misakigr/Ambulat_pristr/Ведомость метизов.pdf

00-25-КМД

13-июн-2025

Проект: Больничное учреждение без специальных требований к размещению. Амбулатория ООО "Аракс"

Деталировщик:

Исполнитель: | Шифр проекта:
ДЕТАЛЬНАЯ ВЕДОМОСТЬ БОЛТОВ | Мисак | Дата
Шайба C.16.01.08кп.016 ГОСТ 11371-78 | | 5 | 100 | 11371-78 | 0 | 1,1
Шайба C.14.01.08кп.016 ГОСТ 11371-78 | | 5 | 168 | 11371-78 | 0 | 1,4
0 | 3,8 Гайка М16 6Н.5 ГОСТ 5915-70 | 5 | 100 | 5915-70
0 | 3,8 Гайка М14 6Н.5 ГОСТ 5915-70 | 5 | 168 | 5915-70
Болт М16 - 6gx60.88 ГОСТ 7798-70 | 60 | 8.8 | 2 | 7798-70 | 0,1 | 0,3
Болт М16 - 6gx55.88 ГОСТ 7798-70 | 55 | 8.8 | 48 | 7798-70 | 0,1 | 5,8
Болт М14 - 6gx50.88 ГОСТ 7798-70 | 50 | 8.8 | 84 | 7798-70 | 0,1 | 7
| | Промежуточный итог: | 670 | | | 23,1
Всего: | 670 | 23,1
Длина Класс | Количест во

(кг)

Покрытие | Тип | Вес | Итог | Описание

(мм)

Наименование | шт. | Вес
(шт) | (кг/шт)

Покрытие

(мм)

Длина | Класс
Наименование
Страница | 1 / 1
