misakigr/Ambulat_pristr/02-2025-ОЗД-АР1.pdf

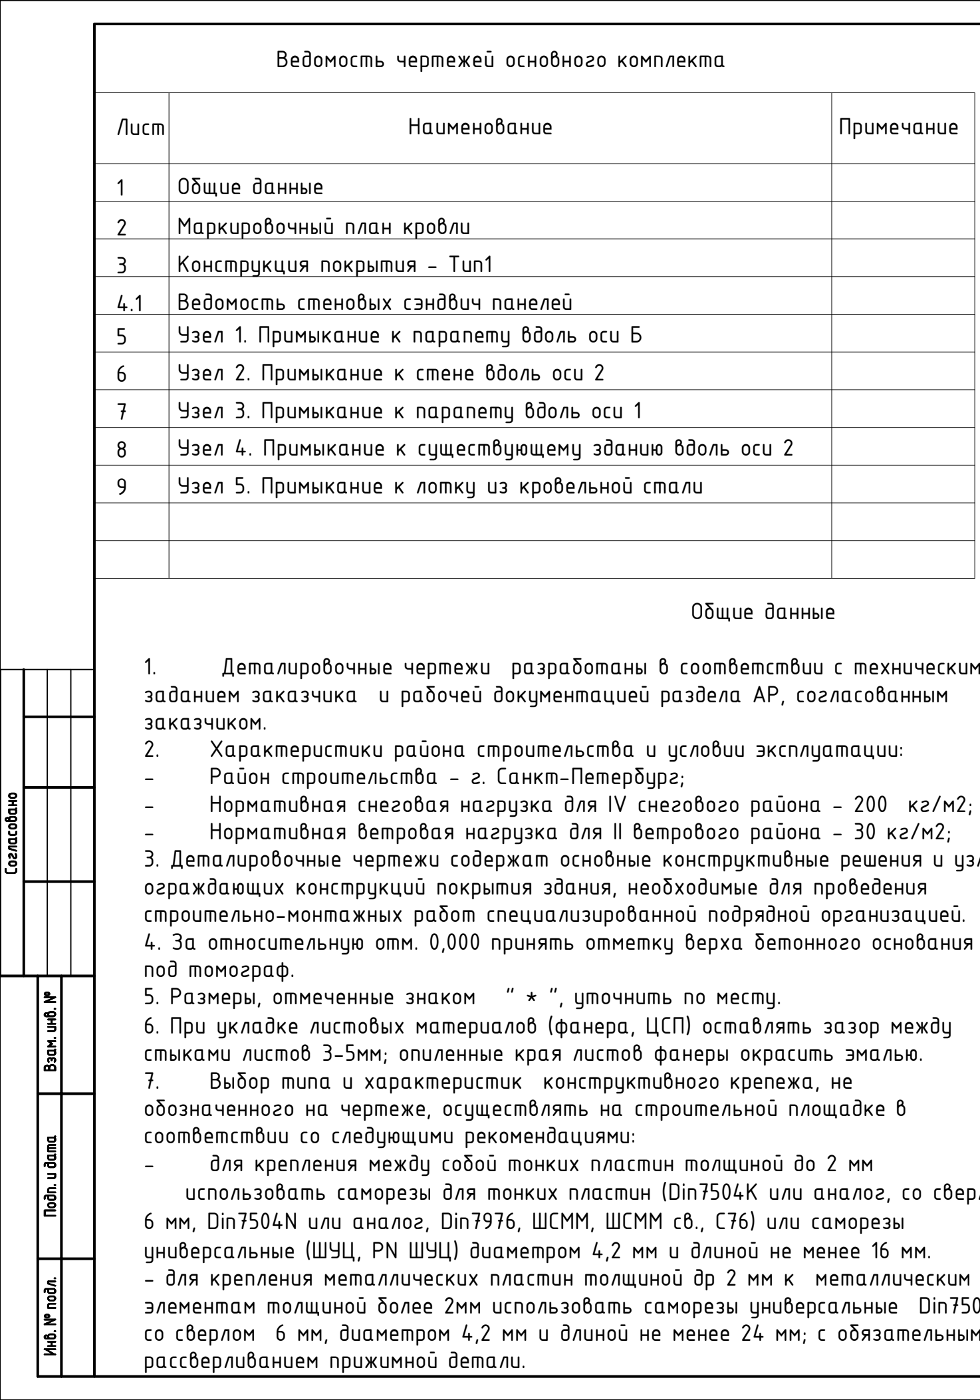
[picture p1: figure]

Ведомость чертежей основного комплекта Лист | Наименование | Примечание 1 | Общие данные 2 | Маркировочный план кровли 3 | Конструкция покрытия - Тип1 | действующими на территории РФ. Настоящий проект выполнен в соответствии с нормами, правилами и стандартами, - для крепления между собой металлических пластин толщиной более 2 мм использовать саморезы универсальные Din7504K со сверлом 12 мм или саморезы Pias диаметром 4.2 мм и длиной не менее 24 мм. - для крепления ЦСП, фанеры и стекломагниевого листа к металлическим каркасам использовать саморезы FLUGEL 4,2х38. - для нерасчетного фиксирующего крепления в бетон использовать дюбели NAT (L), YLT, КВТ, КВТМ, LYT UK KP, LYT LK SP, KAT TORX (N) или KAT HEX (N) диаметром не менее 6 мм и длиной не менее 30 мм. - при отсутствии на чертежах рекомендации по использованию конкретного крепежа допускается использование аналогов, по согласованию с автором проекта листы гипсокартона по подконструкции (внутренняя отделка) крепить к профлисту плоскими саморезами не менее 2-х штук на м2 через бутиловую ленту. Диаметр и тип самореза по выбору подрядной организацией 4.1 | Ведомость стеновых сэндвич панелей 5 | Узел 1. Примыкание к парапету вдоль оси Б 6 | Узел 2. Примыкание к стене вдоль оси 2 7 | Узел 3. Примыкание к парапету вдоль оси 1 8 | Узел 4. Примыкание к существующему зданию вдоль оси 2 Общие данные 1. | Деталировочные чертежи разработаны в соответствии с техническим заданием заказчика и рабочей документацией раздела АР, согласованным заказчиком. 2. | Характеристики района строительства и условии эксплуатации: - | Район строительства - г. Санкт-Петербург; - | Нормативная снеговая нагрузка для IV снегового района - 200 кг/м2; - | Нормативная ветровая нагрузка для II ветрового района - 30 кг/м2; 3. Деталировочные чертежи содержат основные конструктивные решения и узлы ограждающих конструкций покрытия здания, необходимые для проведения строительно-монтажных работ специализированной подрядной организацией. 4. За относительную отм. 0,000 принять отметку верха бетонного основания под томограф. 5. Размеры, отмеченные знаком " * ", уточнить по месту. 6. При укладке листовых материалов (фанера, ЦСП) оставлять зазор между стыками листов 3-5мм; опиленные края листов фанеры окрасить эмалью. 7. | Выбор типа и характеристик конструктивного крепежа, не обозначенного на чертеже, осуществлять на строительной площадке в соответствии со следующими рекомендациями: - | для крепления между собой тонких пластин толщиной до 2 мм использовать саморезы для тонких пластин (Din7504K или аналог, со сверлом 6 мм, Din7504N или аналог, Din7976, ШСММ, ШСММ св., С76) или саморезы универсальные (ШУЦ, PN ШУЦ) диаметром 4,2 мм и длиной не менее 16 мм. - для крепления металлических пластин толщиной др 2 мм к металлическим элементам толщиной более 2мм использовать саморезы универсальные Din7504K со сверлом 6 мм, диаметром 4,2 мм и длиной не менее 24 мм; с обязательным рассверливанием прижимной детали. 9 | Узел 5. Примыкание к лотку из кровельной стали

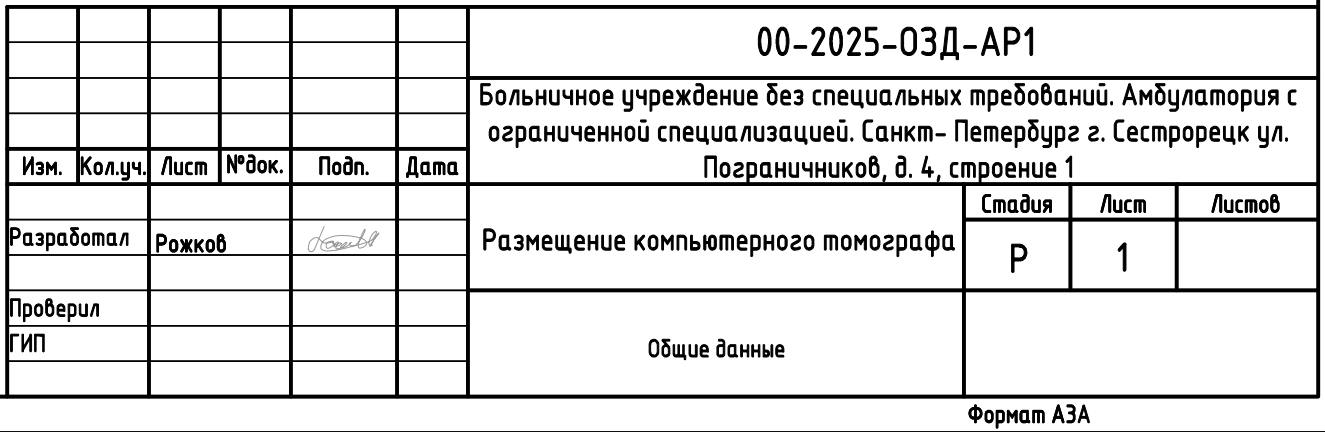
[picture p2: figure]
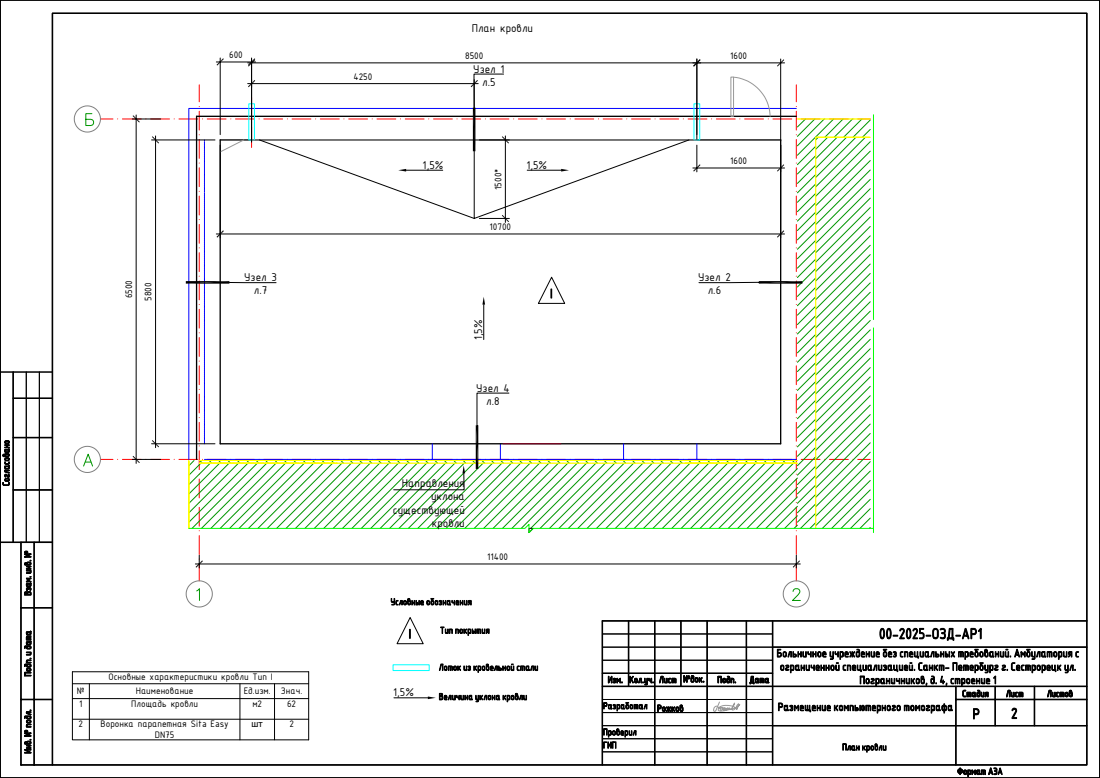
[picture p3: page 2]

1,5% 1,5% 1,5% 1600 План кровли 4250 1,5% Узел 1 л.5 Узел 2 л.6 Узел 3 л.7 Узел 4 л.8 Направления уклона существующей кровли

5800 10700 Основные характеристики кровли Тип I № Наименование Ед.изм. Знач. 1 Площадь кровли м2 62 2 Воронка парапетная Sita Easy DN75 шт 2

Тип К1 Прогоны см. КМ Гидроизоляция верхий слой - Технониколь ЭКП Техноэласт Гидроизоляция нижний слой - Технониколь Техноэласт Фикс П с механическим креплением к основанию Термоплиты LOGICPIR PROF Ф/Ф толщ. 50мм Теплоизоляция-каменная вата Техноруф Н ПРОФ, толщ.150мм Пароизоляция-Технониколь паробарьер СА500 Основание по КМ- профнастил | 1,5% | Профнастил с контруклоном к воронкам

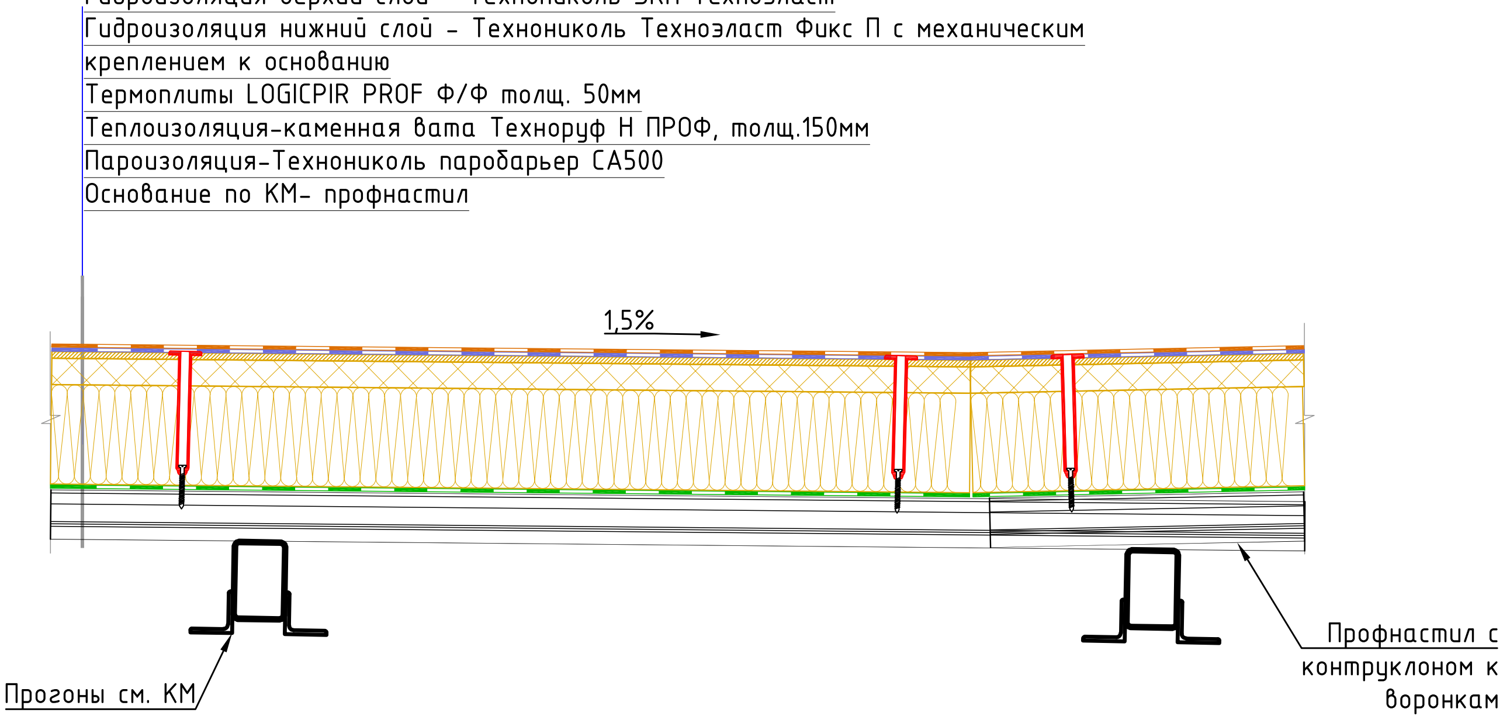
[picture p4: figure]
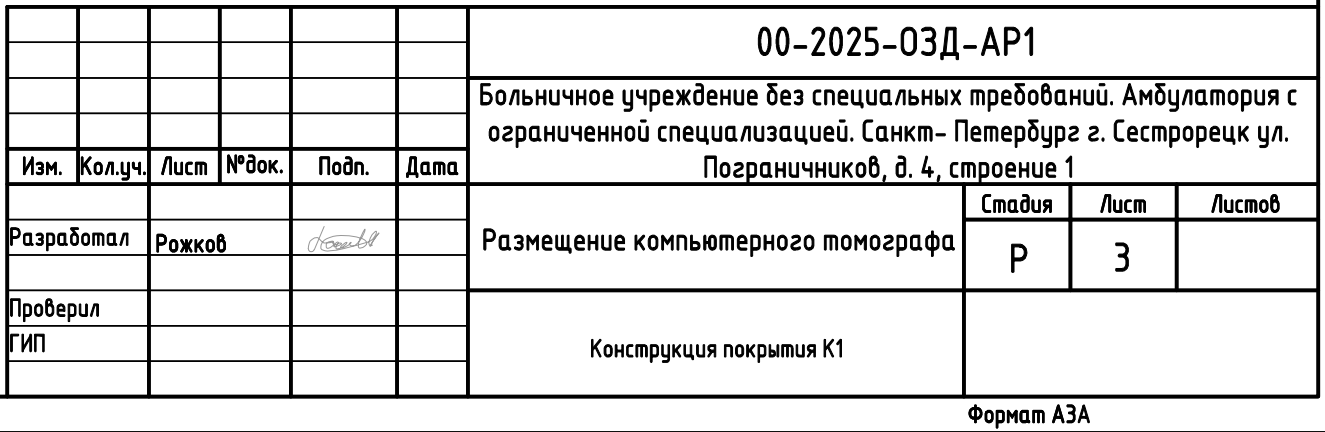
[picture p5: figure]

1000 1190 1190 СП1* СП1 СП1 СП2* СП2 СП2 СП3* СП3 СП3 150 3140 20 3935 20 4163 20 +0,400 +0,400 6100 3050 3050 1000 1190 1190 СП4* СП4 СП4 СП5* СП5 СП5 150 3100 20 3330 20 +0,400 Ведомость стеновых сэндвич-панелей Крафтспан Поз. Обозначение Высота, мм Длина, мм Толщ., мм Кол-во шт Примеч. 1 СП-1 1190 3140 150 3 *-подрезать по месту 2 СП-2 1190 3935 150 3 *-подрезать по месту 3 СП-3 1190 4163 150 3 *-подрезать по месту 4 СП-4 1190 3100 150 3 *-подрезать по месту 5 СП-5 1190 3330 150 3 *-подрезать по месту

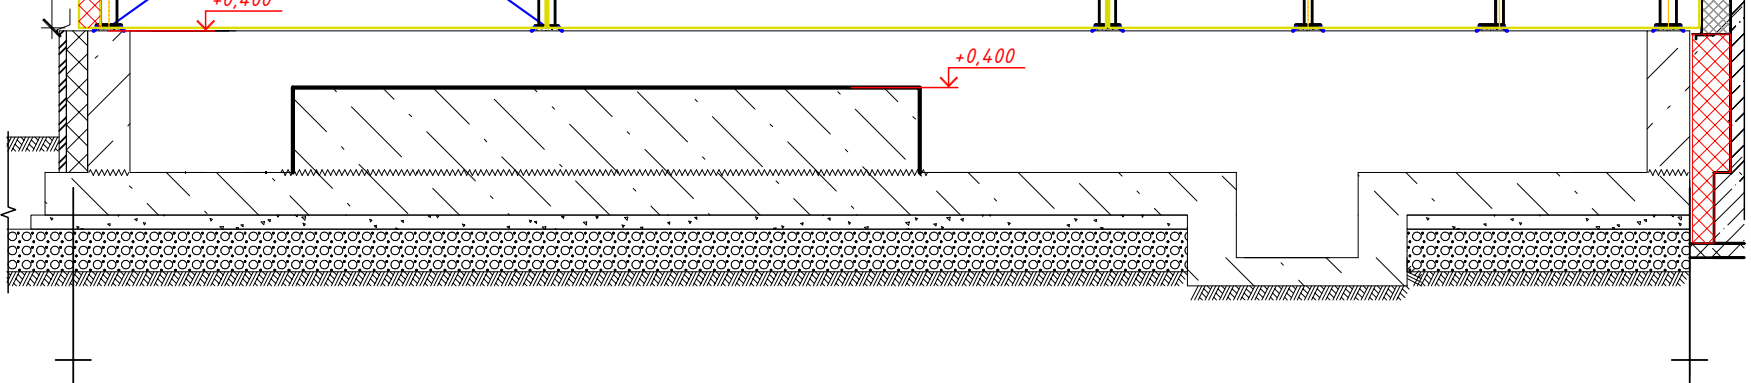
[picture p6: figure]
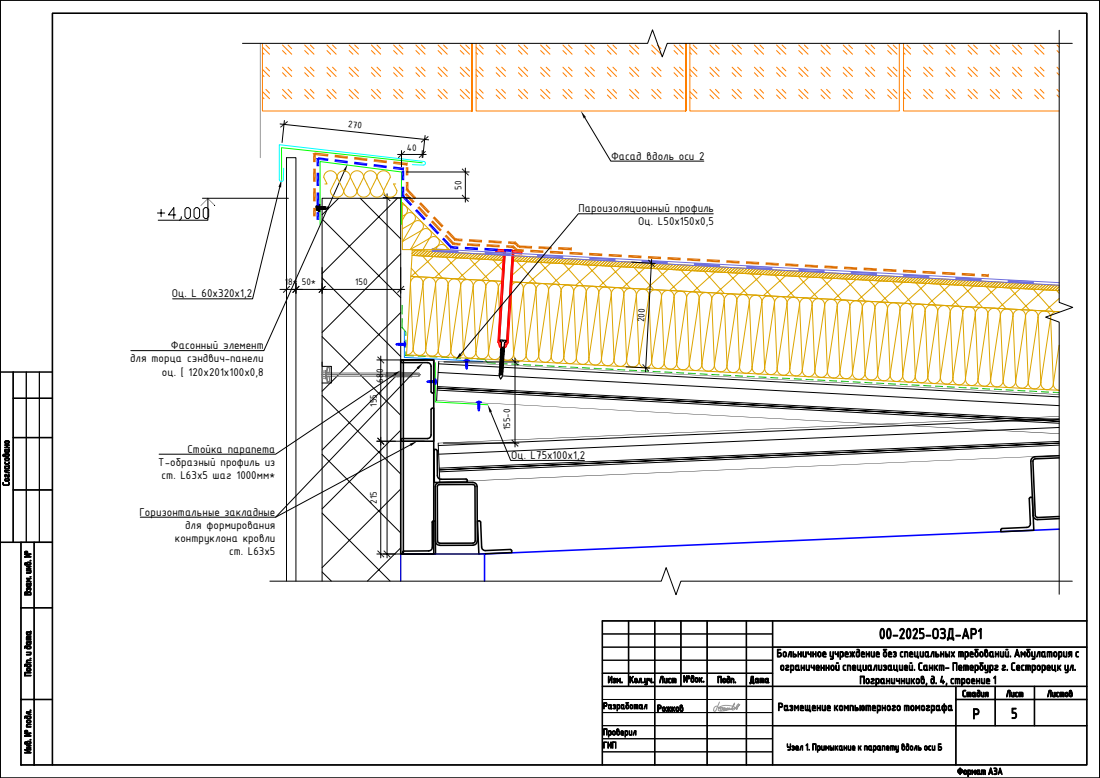
[picture p7: page 5]
150 Фасонный элемент для торца сэндвич-панели оц. [ 120x201x100x0,8

50 270 40 Фасад вдоль оси 2

155-0 Оц. L75x100x1,2Пароизоляционный профиль Оц. L50x150x0,5 200

155 215 Стойка парапета Т-образный профиль из ст. L63x5 шаг 1000мм* 18* 50*

680 Горизонтальные закладные для формирования контруклона кровли ст. L63x5

Гидроизоляция верхий слой - Технониколь ЭКП Техноэласт Гидроизоляция нижний слой - Технониколь Техноэласт Фикс П с механическим креплением к основанию Сплошной настил - лист СМЛ 10мм Теплоизоляция-каменная вата Техноруф Н ПРОФ, толщ.50+100=150мм Обрешетка из оц. [50x150x50x1,2 вдоль стены Пароизоляция - Технониколь СА500 Теплоизоляция-каменная вата Техноруф Н ПРОФ, толщ.50мм Основание по Ж.Б. Пароизоляционный компенсационный профиль Оц. 300x50x50x100x0,8 Оц. [50x150x575x150x50x1,2

556 50 50 Оц. -130х1,2

50 Оц. L100х50x1,2 Компенсационный профиль Оц. 200x50x50x100x0,8 Герметик PU Капельник из кровельной стали

575 150 50

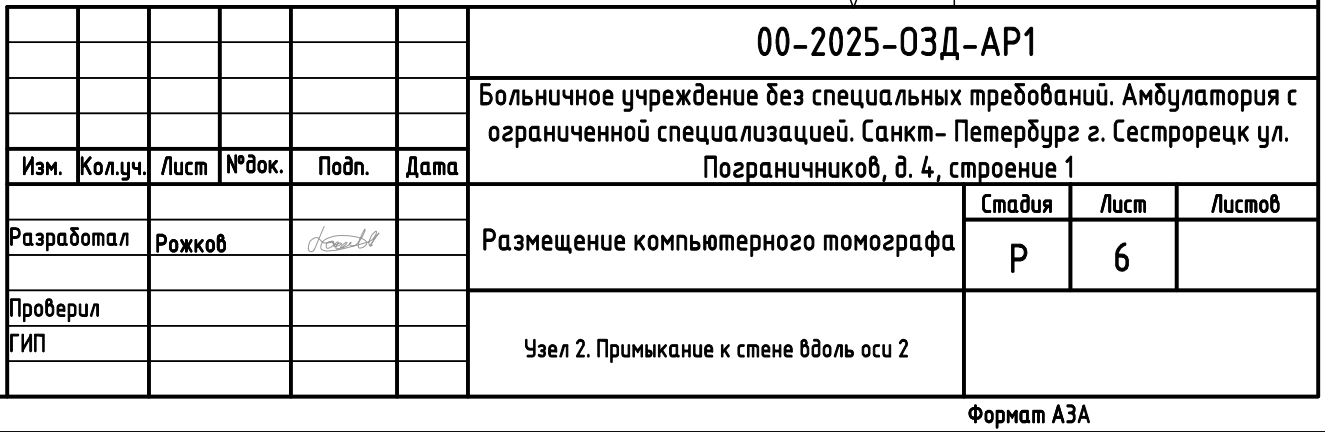
[picture p8: figure]
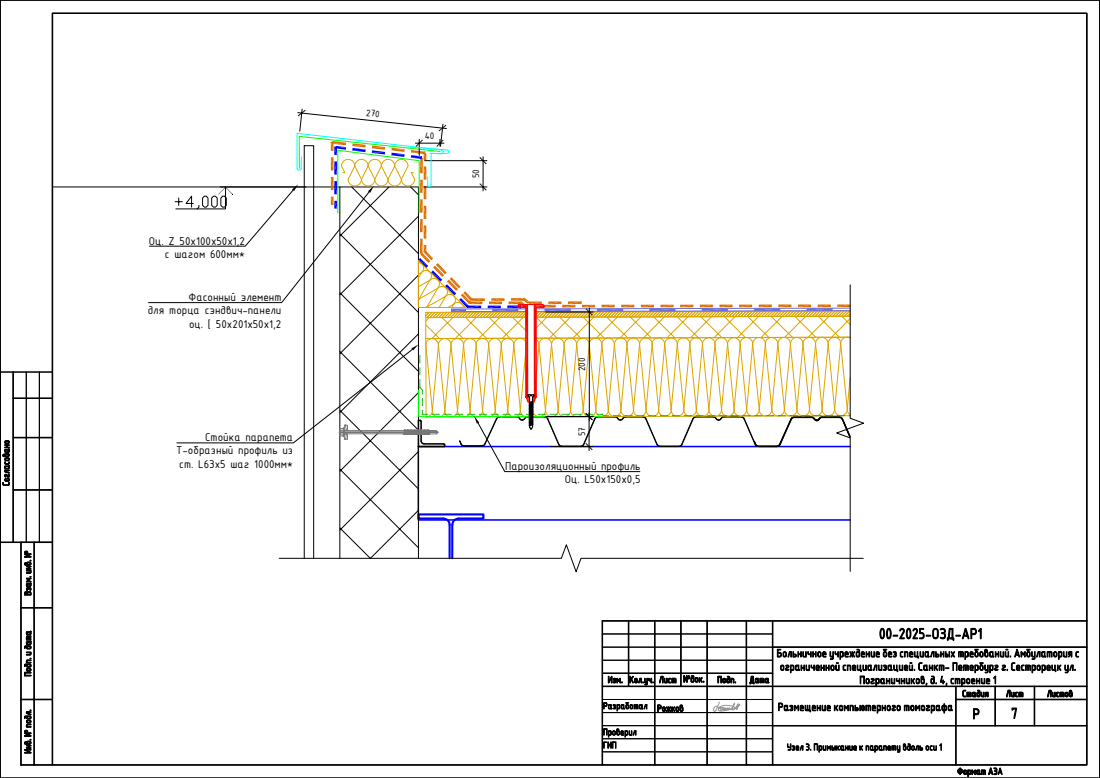
[picture p9: page 7]

57 200 Оц. Z 50x100x50x1,2 с шагом 600мм* Фасонный элемент для торца сэндвич-панели оц. [ 50x201x50x1,2 Стойка парапета Т-образный профиль из ст. L63x5 шаг 1000мм* Пароизоляционный профиль Оц. L50x150x0,5

35 Пароизоляционный компенсационный профиль Оц. 300x50x50x100x0,8 Элемент добора толщины из оц.20х20х100х20х15х0,8 вкладывать в импост верхний, к боковым импостам крепить механически на саморезы сверлоконечные 20 Герметик PU

150 Существующий капельник L=150мм* 50

100 150 Слой усиления Унифлекс ЭПП (или аналог) Оц. [50x150x50x1,2 H=195мм
195 Оц. L 50x50x1,2 Сплошной настил Гидроизоляция 2 слоя до границы водораздела 1.5% Уклон существующей кровли

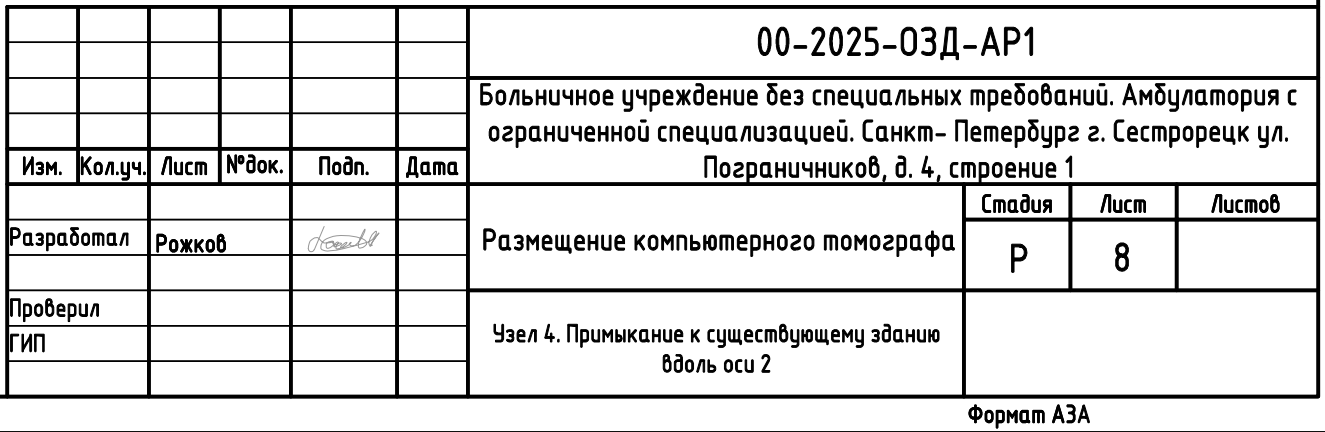
[picture p10: figure]
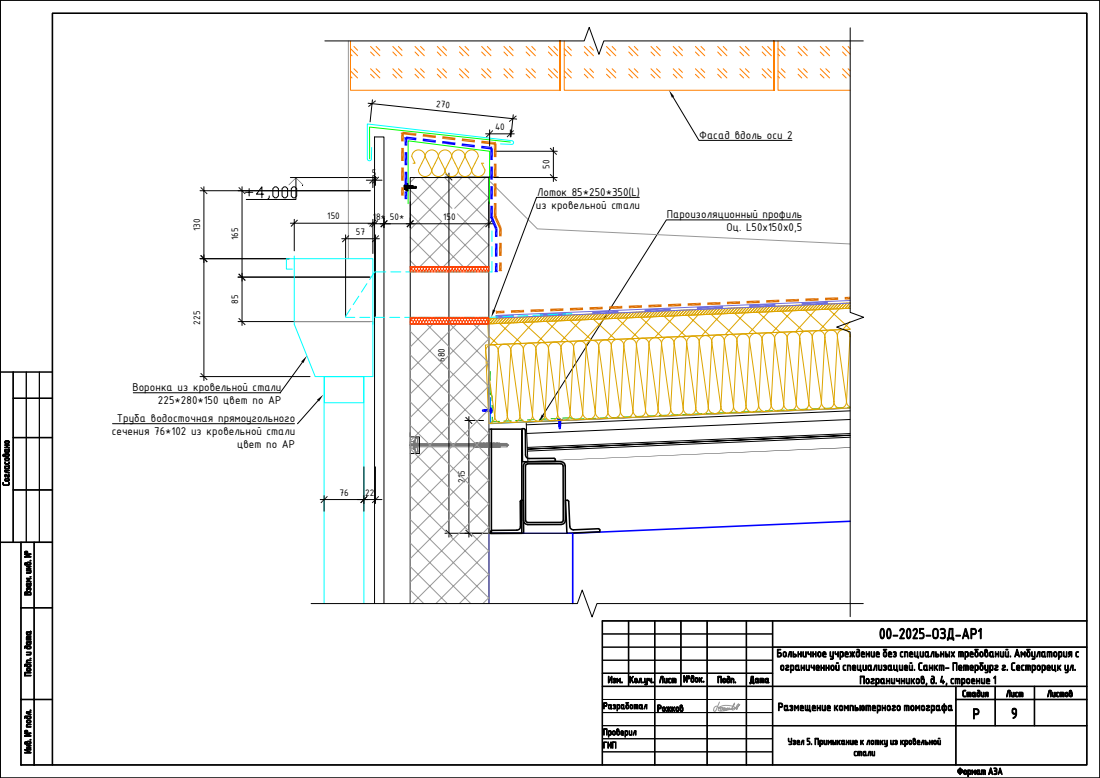
[picture p11: page 9]

50 270 40 Фасад вдоль оси 2 57

130 76 22 Труба водосточная прямоугольного сечения 76*102 из кровельной стали цвет по АР Лоток 85*250*350(L) из кровельной стали Воронка из кровельной стали 225*280*150 цвет по АР

150 Пароизоляционный профиль Оц. L50x150x0,5
