misakigr/Ambulat_pristr/(list of files, cad)

Other CAD files:
Ambulat.dwg
