misakigr/Ambulat_pristr/Балки.pdf

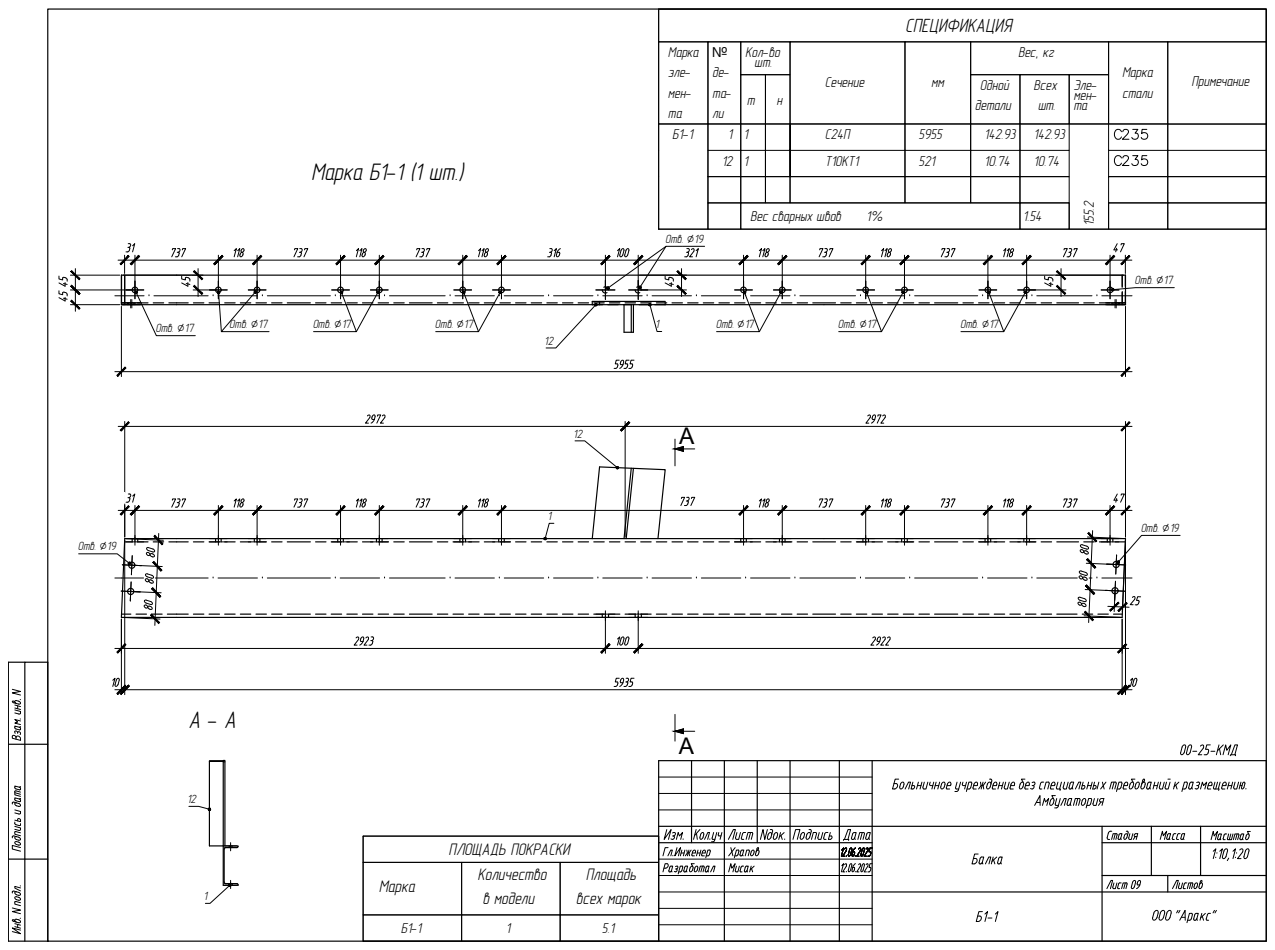
[picture p12: page 1]
СПЕЦИФИКАЦИЯ Марка эле- мен- та; Кол-во шт.; Всех шт. Одной детали Вес, кг Сечение; Примечание Марка стали Эле- мен- та Б1-1; 10.74 Вес сварных швов

155.2 ПЛОЩАДЬ ПОКРАСКИ Площадь всех марок Количество в модели МаркаБ1-1 1 5.1 Марка Б1-1 (1 шт.) 1 Отв. 19 Отв. 19 12 АА 1 Отв. 17 Отв. 17 Отв. 17 Отв. 17 Отв. 17 Отв. 17 Отв. 17 Отв. 17 Отв. 19 12 1 12А - А

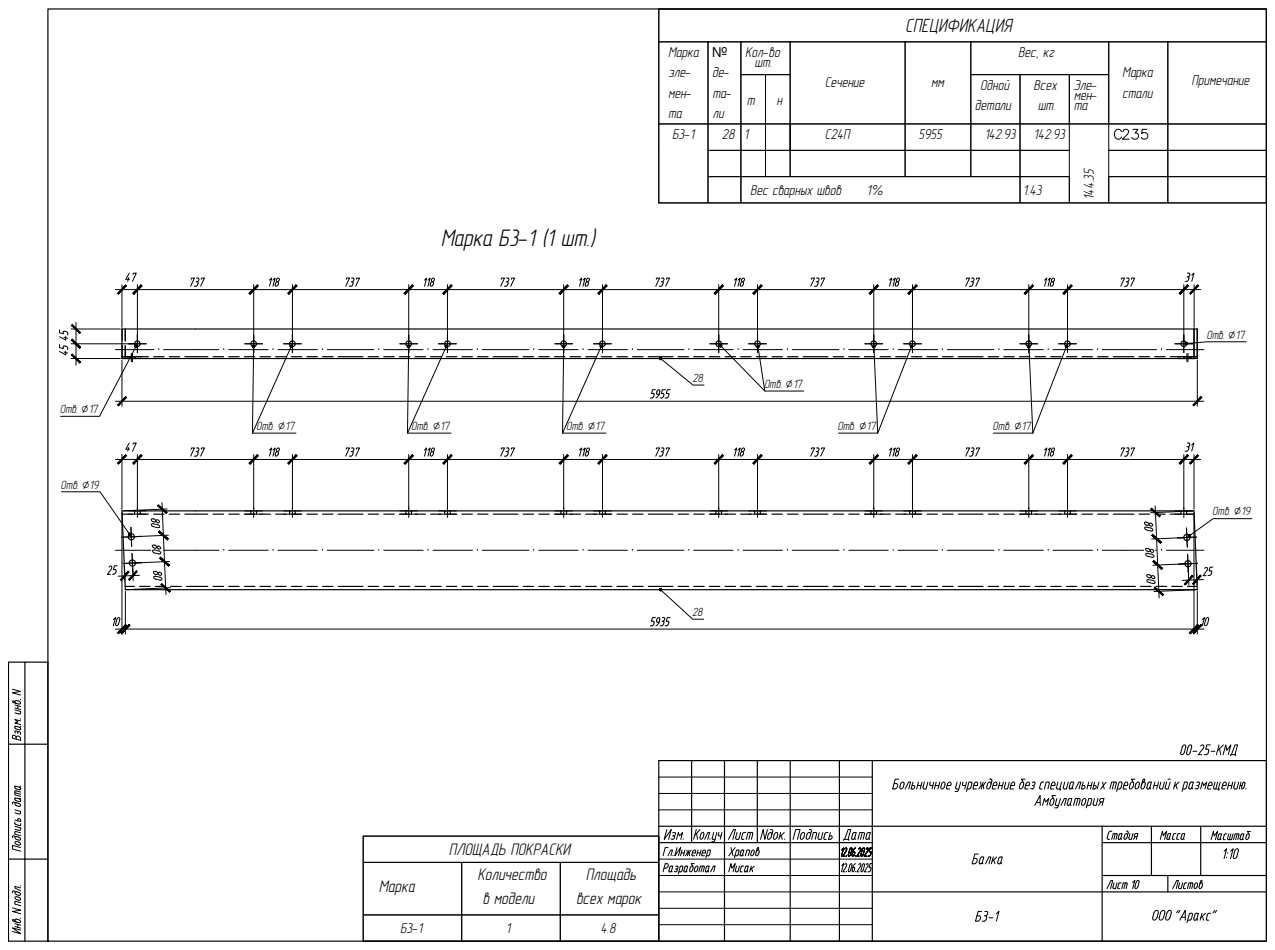
[picture p13: page 2]
СПЕЦИФИКАЦИЯ Марка эле- мен- та; Кол-во шт.; Всех шт. Одной детали Вес, кг Сечение; Примечание Марка стали Эле- мен- та Б3-1; 142.93 Вес сварных швов

144.35 ПЛОЩАДЬ ПОКРАСКИ Площадь всех марок Количество в модели МаркаБ3-1 1 4.8 Марка Б3-1 (1 шт.) 28 Отв. 19 Отв. 19 28 Отв. 17 Отв. 17 Отв. 17 Отв. 17 Отв. 17 Отв. 17 Отв. 17 Отв. 17

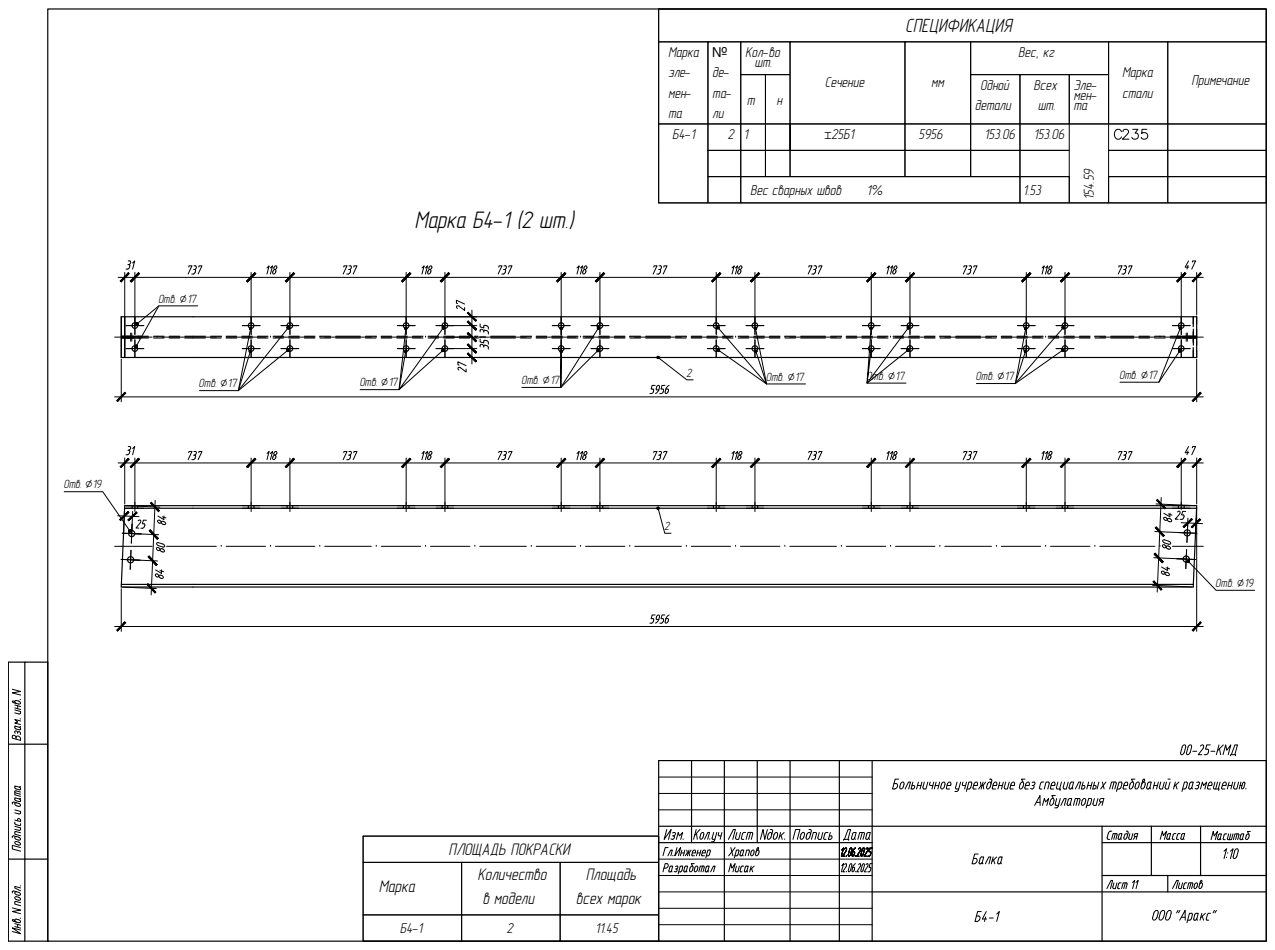
[picture p14: page 3]
СПЕЦИФИКАЦИЯ Марка эле- мен- та; Кол-во шт.; Всех шт. Одной детали Вес, кг Сечение; Примечание Марка стали Эле- мен- та Б4-1; 153.06 Вес сварных швов

154.59 ПЛОЩАДЬ ПОКРАСКИ Площадь всех марок Количество в модели МаркаБ4-1 2 11.45 Марка Б4-1 (2 шт.) 2 Отв. 19 Отв. 19 2 Отв. 17 Отв. 17 Отв. 17 Отв. 17 Отв. 17 Отв. 17 Отв. 17 Отв. 17
