misakigr/Ambulat_pristr/Деталировка.pdf

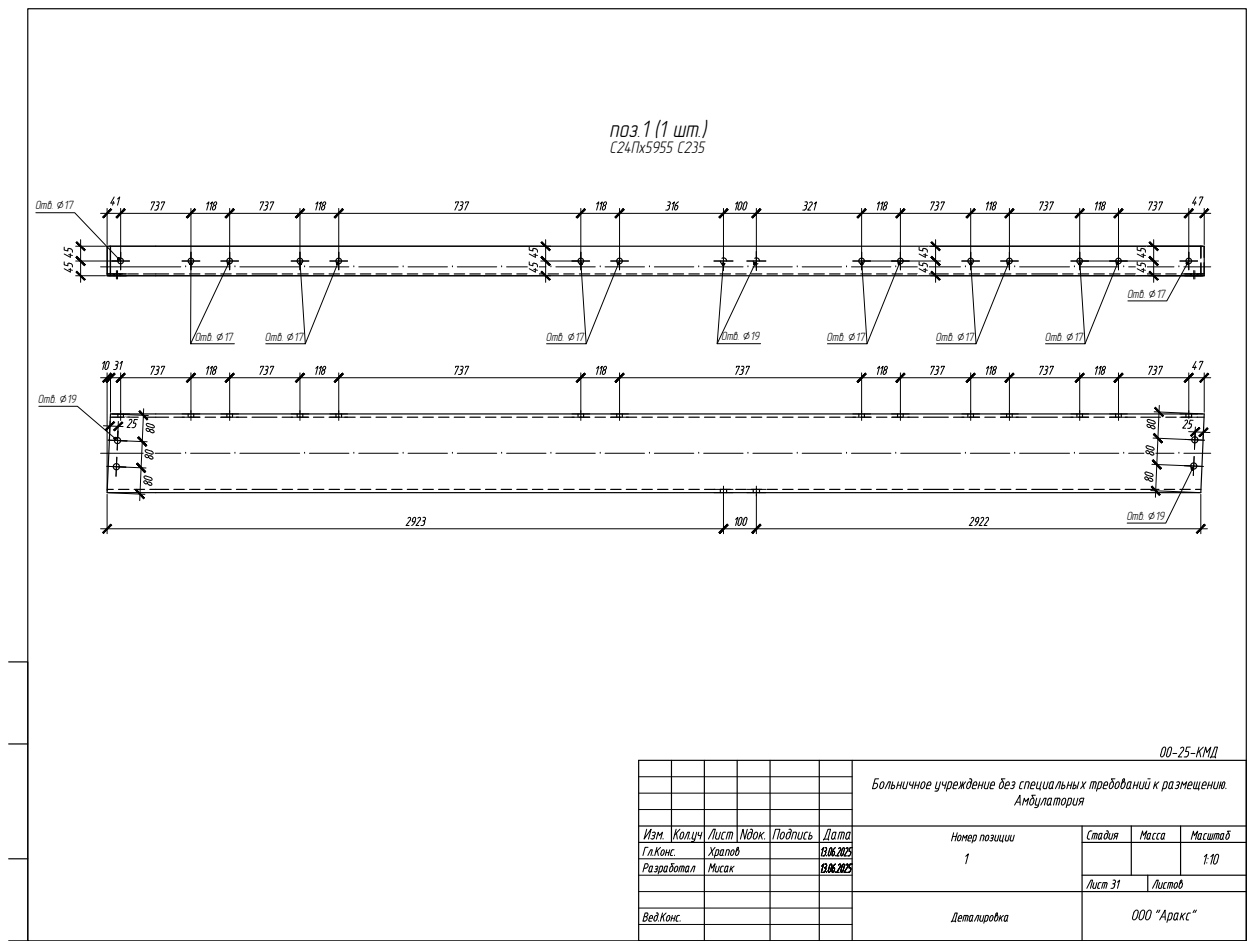
[picture p15: page 1]
поз.1 (1 шт.) С24Пx5955 С235 Отв. 19; Отв. 19 Отв. 17; Отв. 17; Отв. 17 Отв. 19

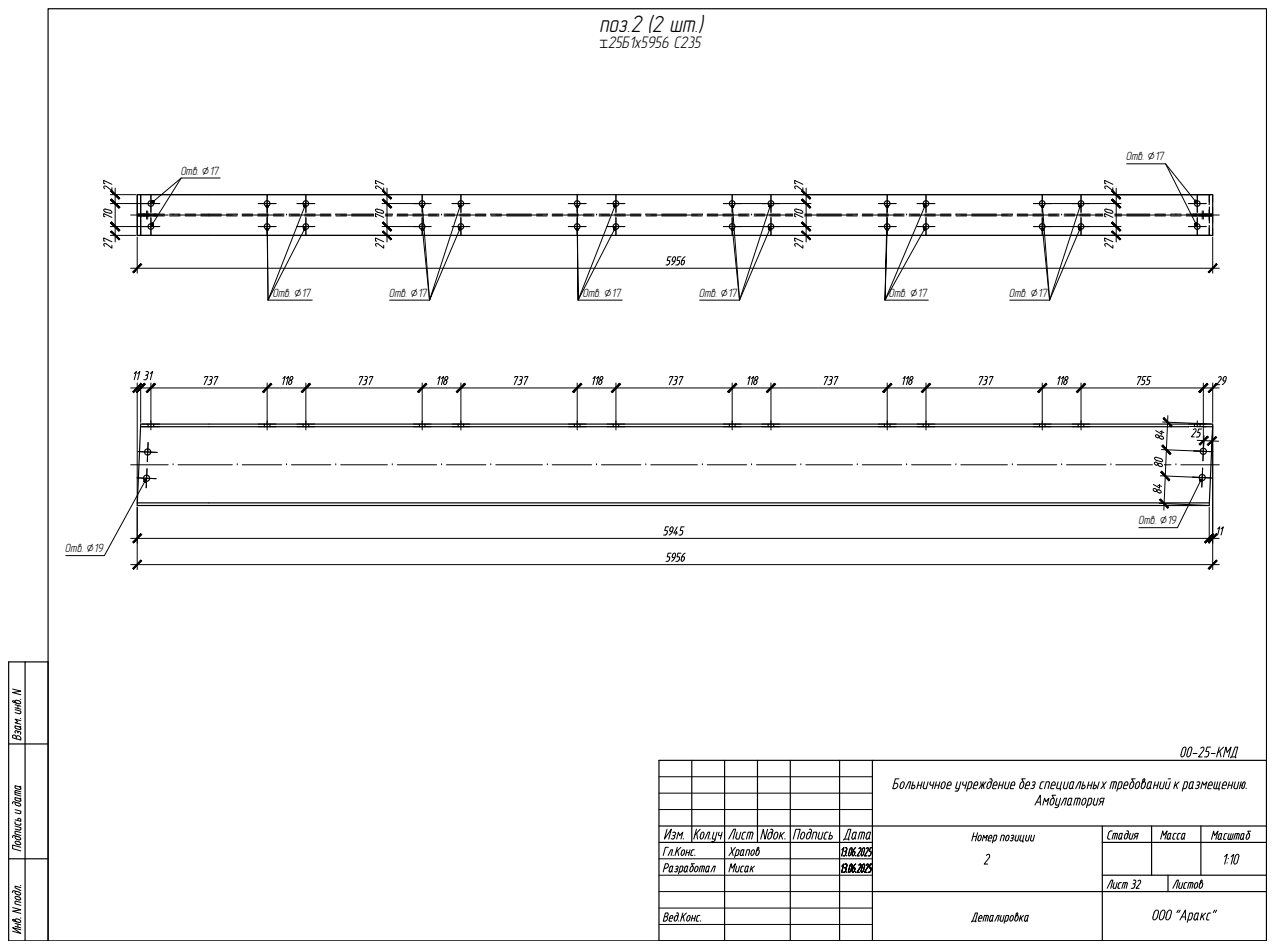
[picture p16: page 2]
поз.2 (2 шт.) I25Б1x5956 С235 Отв. 19; Отв. 19 Отв. 17; Отв. 17

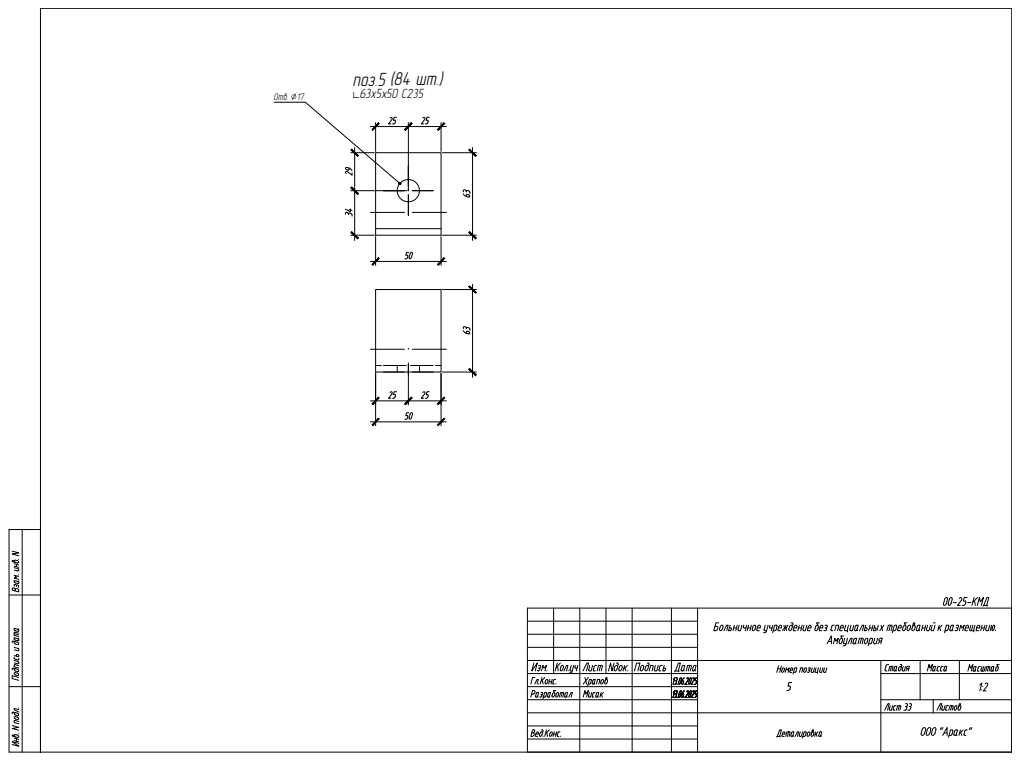
[picture p17: page 3]
поз.5 (84 шт.) Отв. 17

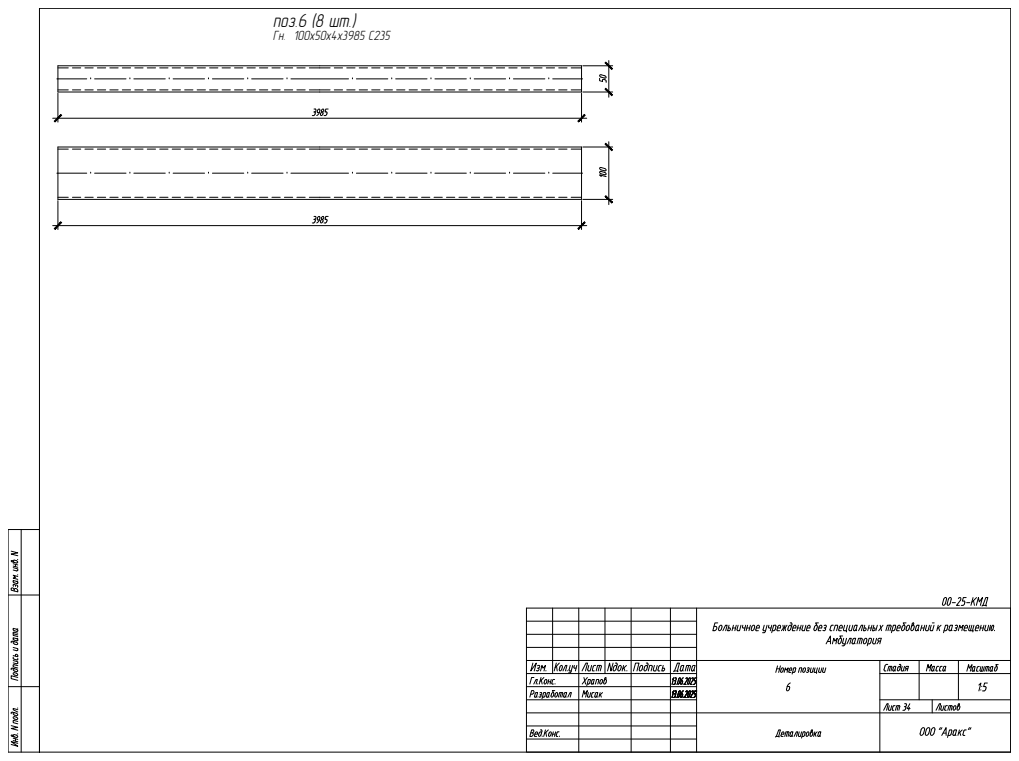
[picture p18: page 4]

поз.6 (8 шт.) Гн. 100x50x4x3985 С235

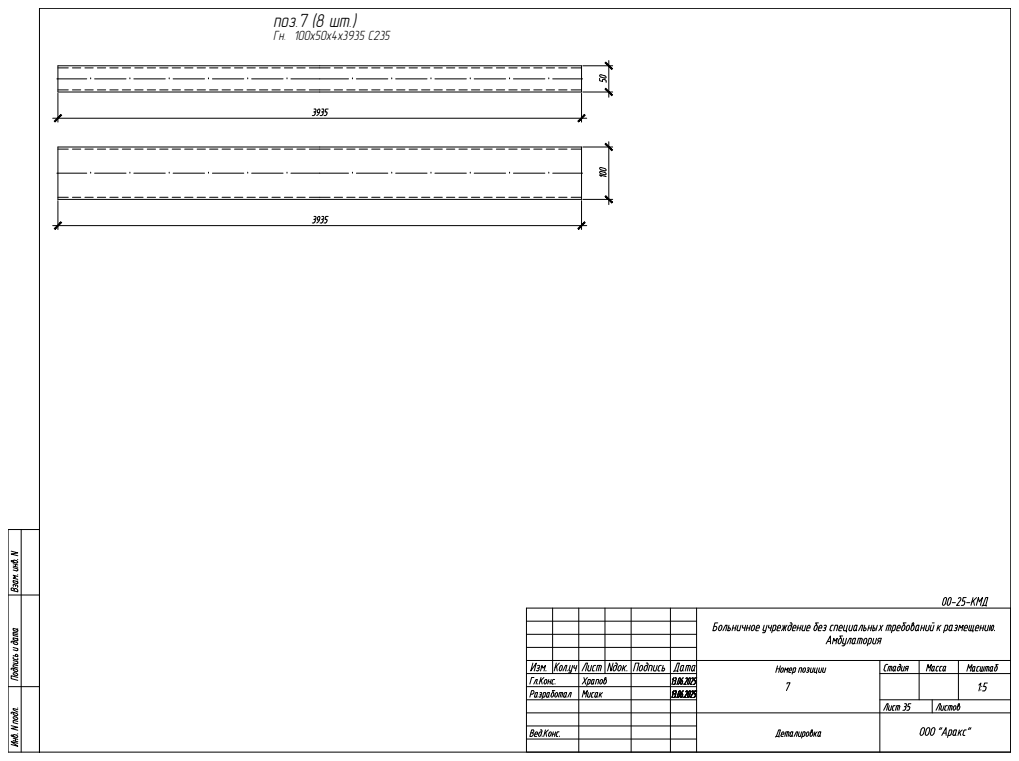
[picture p19: page 5]

поз.7 (8 шт.) Гн. 100x50x4x3935 С235

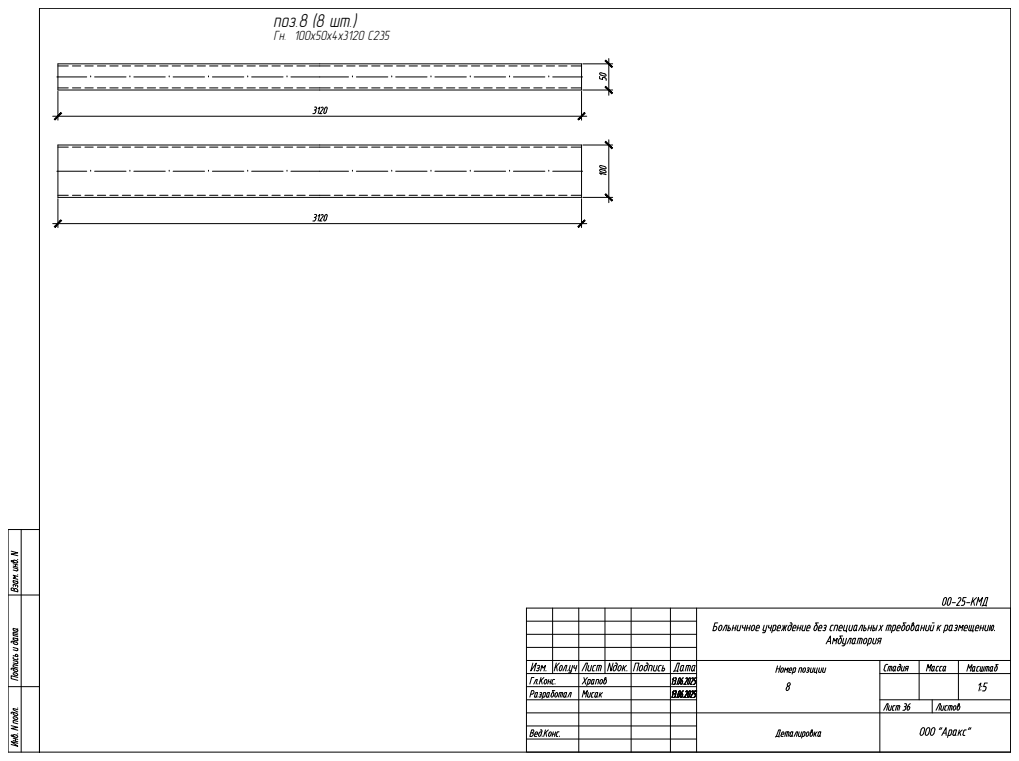
[picture p20: page 6]

поз.8 (8 шт.) Гн. 100x50x4x3120 С235

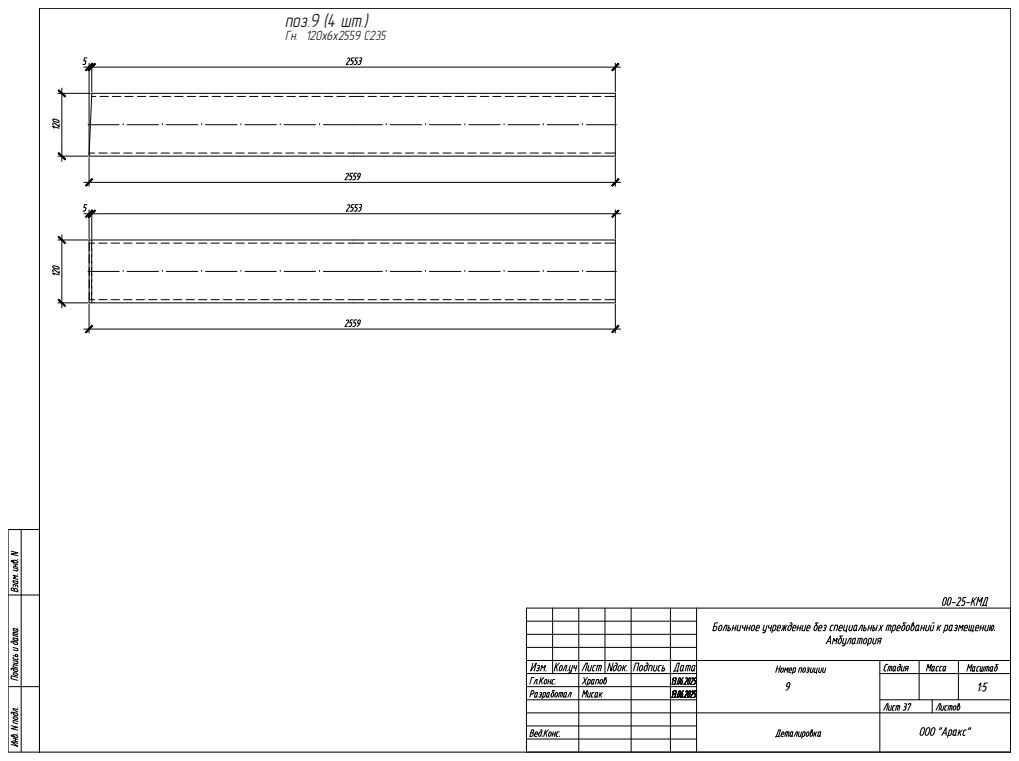
[picture p21: page 7]

поз.9 (4 шт.) Гн. 120x6x2559 С235

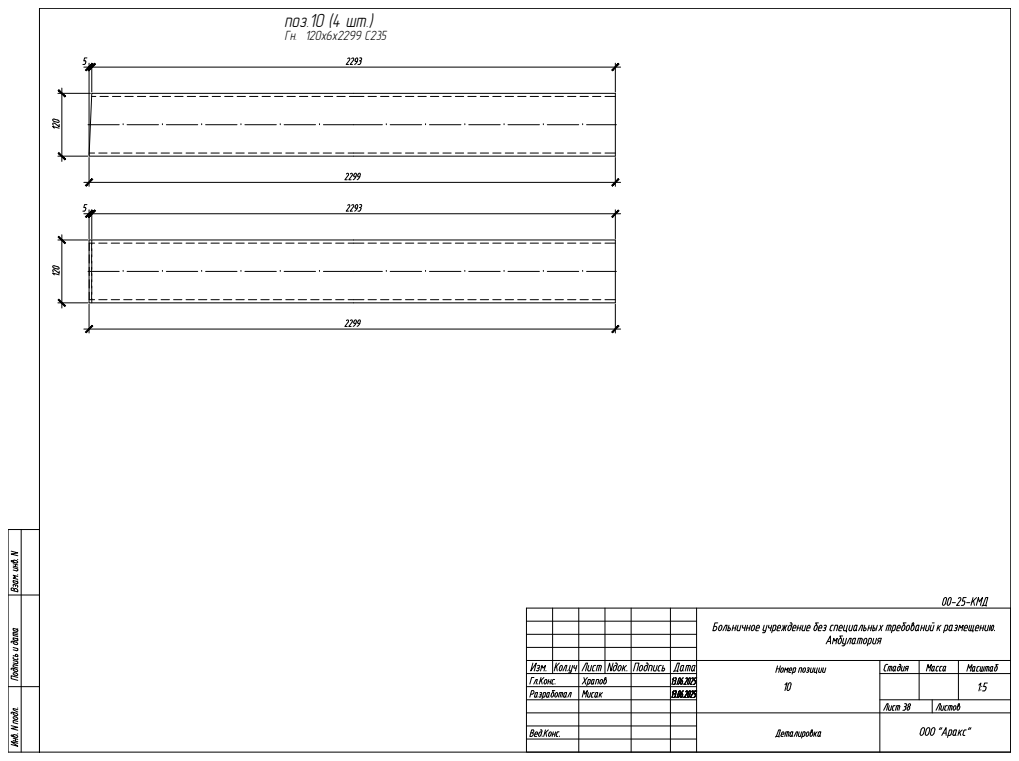
[picture p22: page 8]

поз.10 (4 шт.) Гн. 120x6x2299 С235

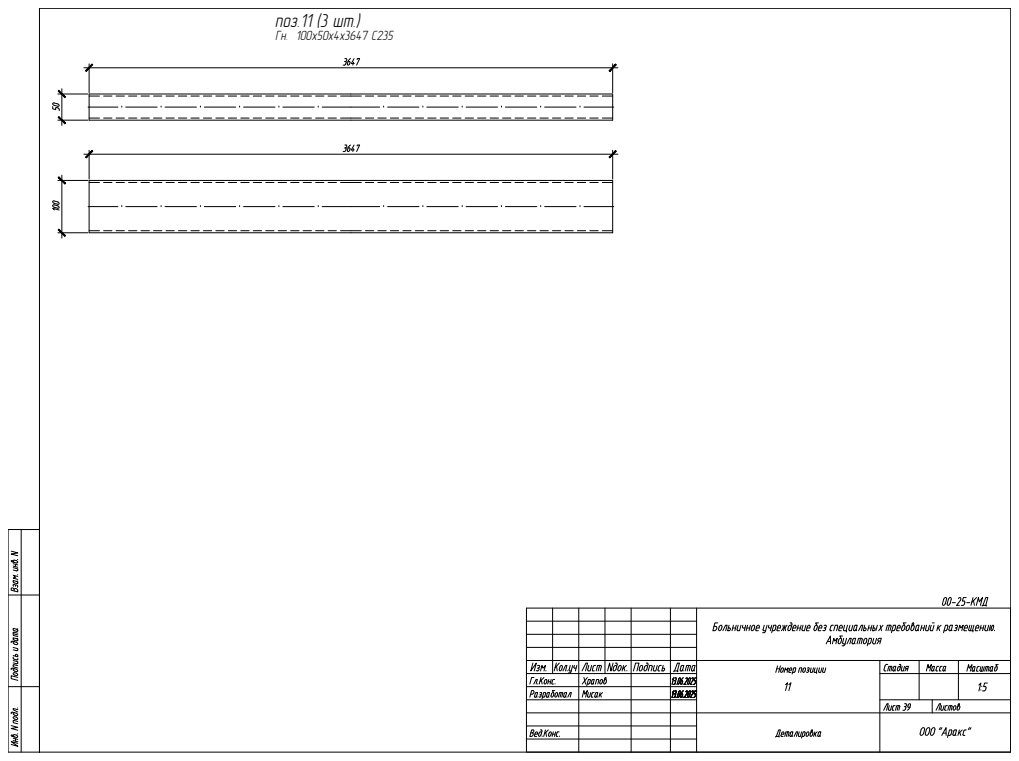
[picture p23: page 9]

поз.11 (3 шт.) Гн. 100x50x4x3647 С235

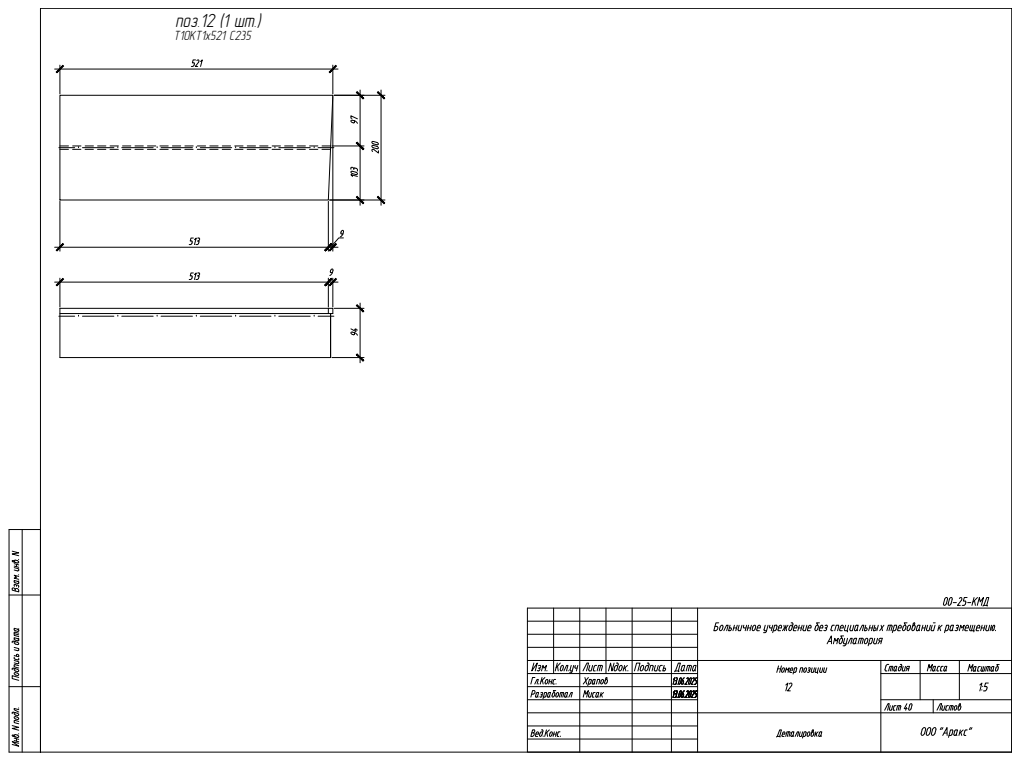
[picture p24: page 10]
поз.12 (1 шт.) Т10КТ1x521 С235

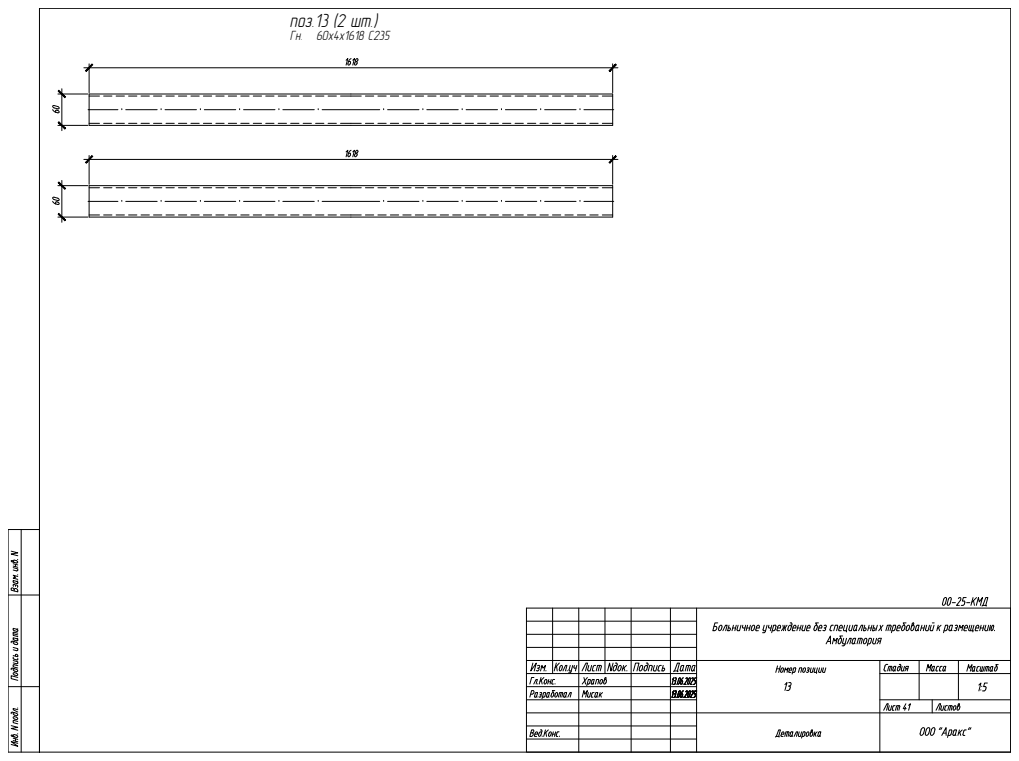
[picture p25: page 11]

поз.13 (2 шт.) Гн. 60x4x1618 С235

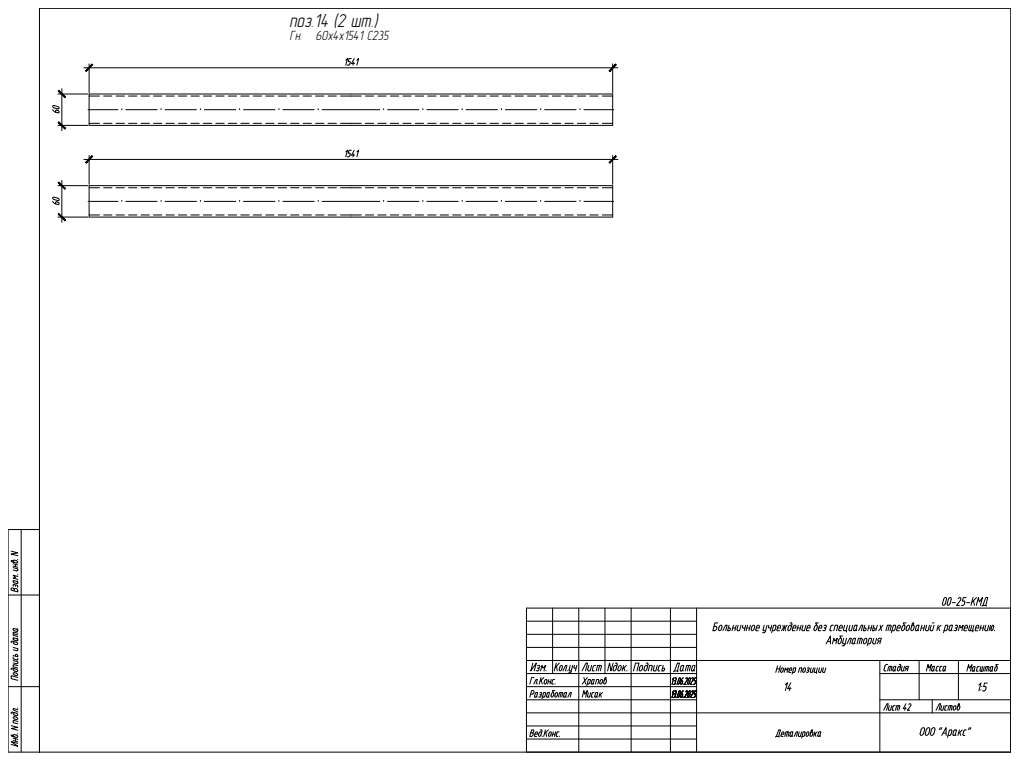
[picture p26: page 12]

поз.14 (2 шт.) Гн. 60x4x1541 С235

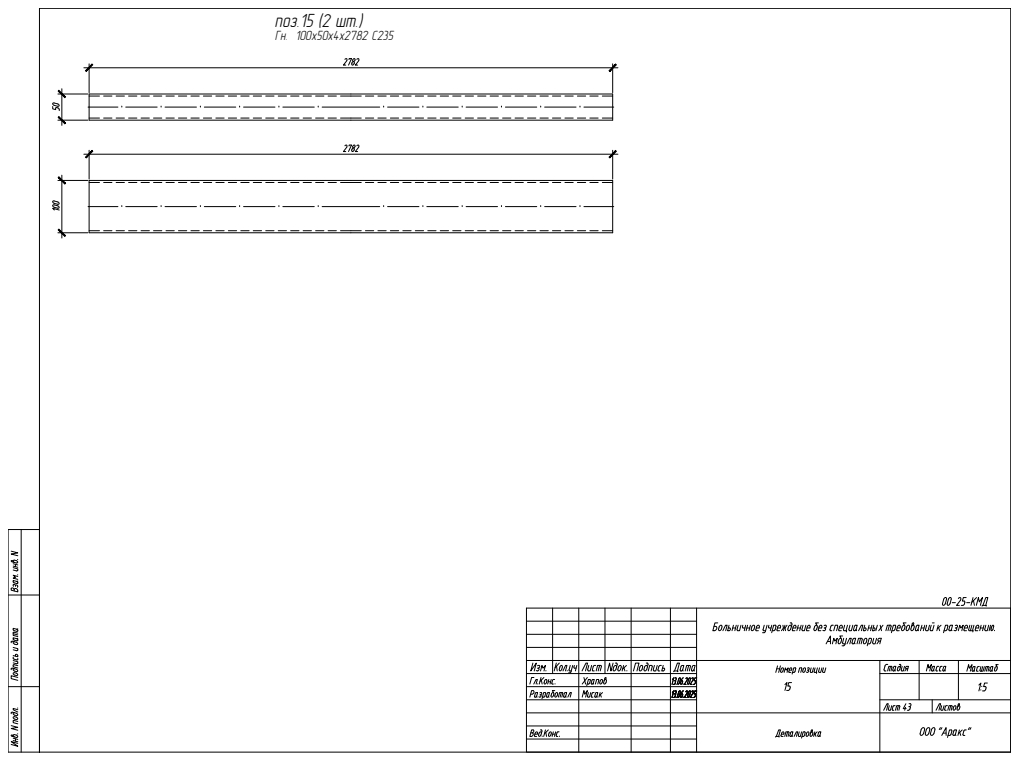
[picture p27: page 13]

поз.15 (2 шт.) Гн. 100x50x4x2782 С235

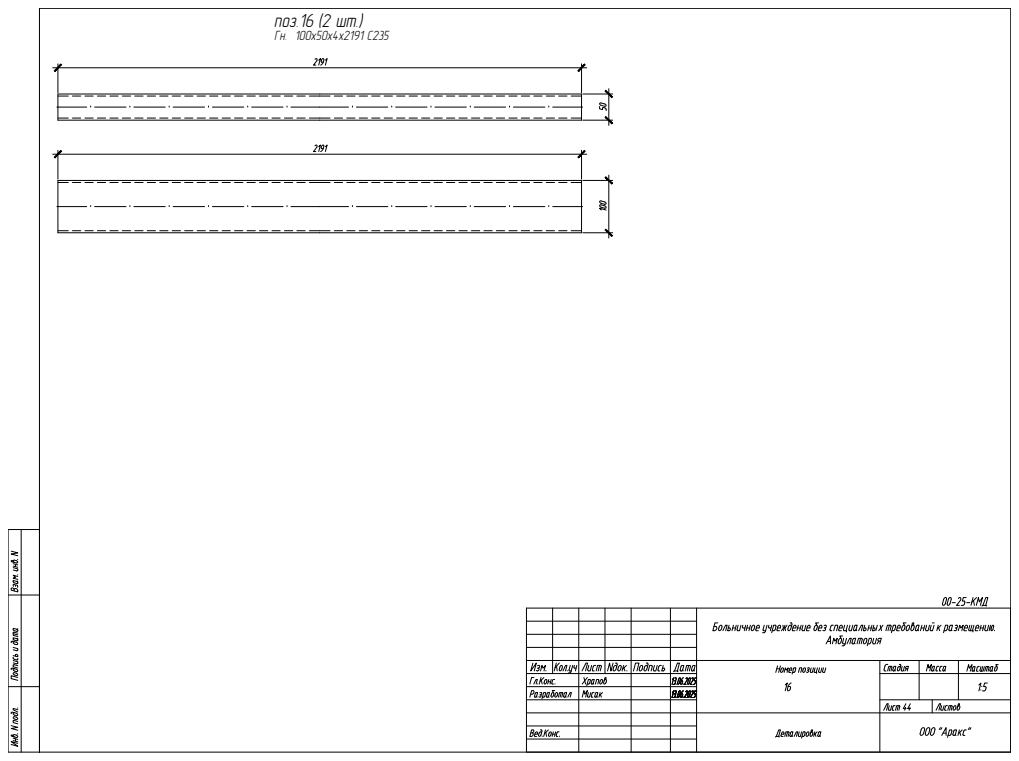
[picture p28: page 14]

поз.16 (2 шт.) Гн. 100x50x4x2191 С235

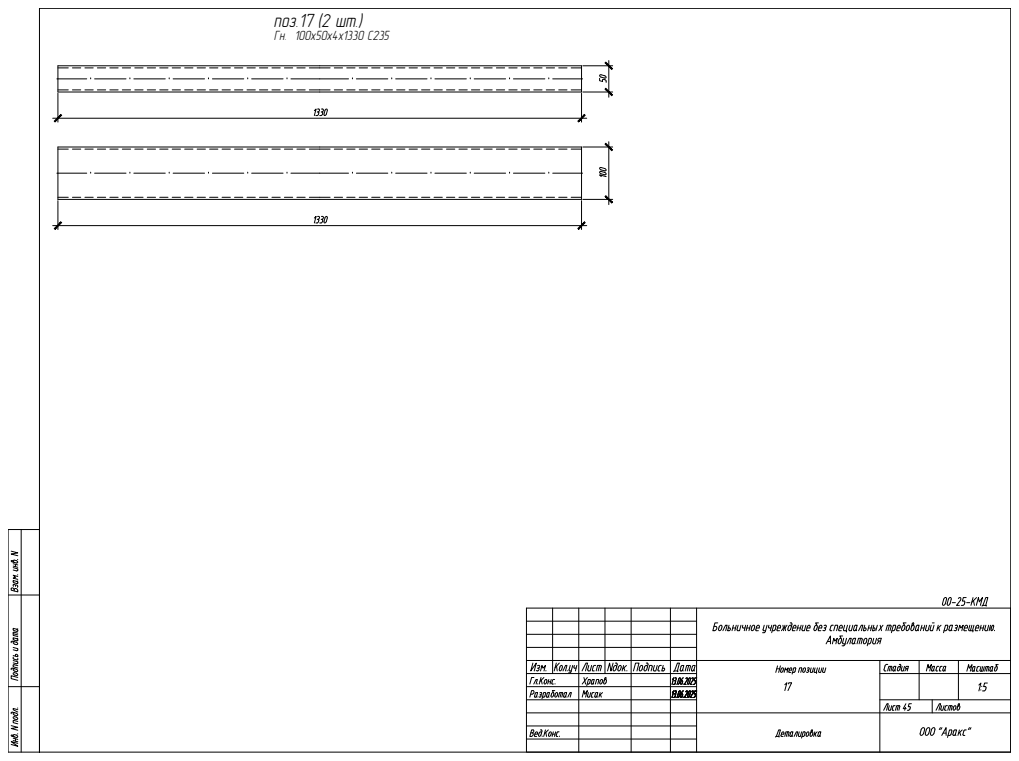
[picture p29: page 15]

поз.17 (2 шт.) Гн. 100x50x4x1330 С235

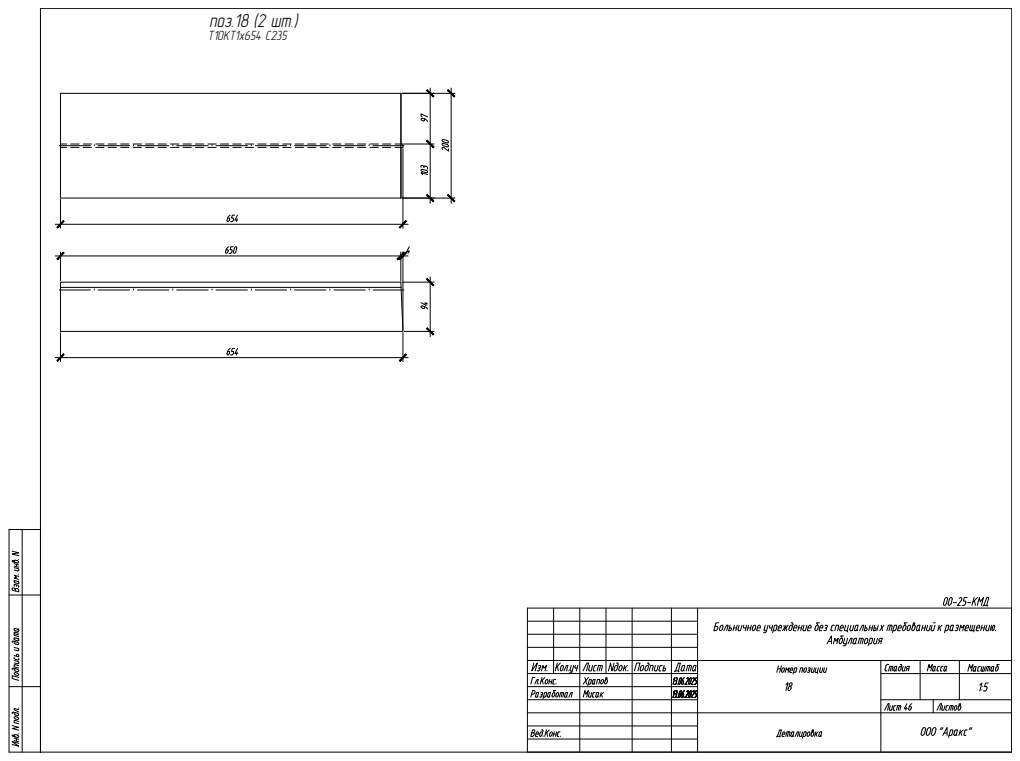
[picture p30: page 16]
поз.18 (2 шт.) Т10КТ1x654 С235

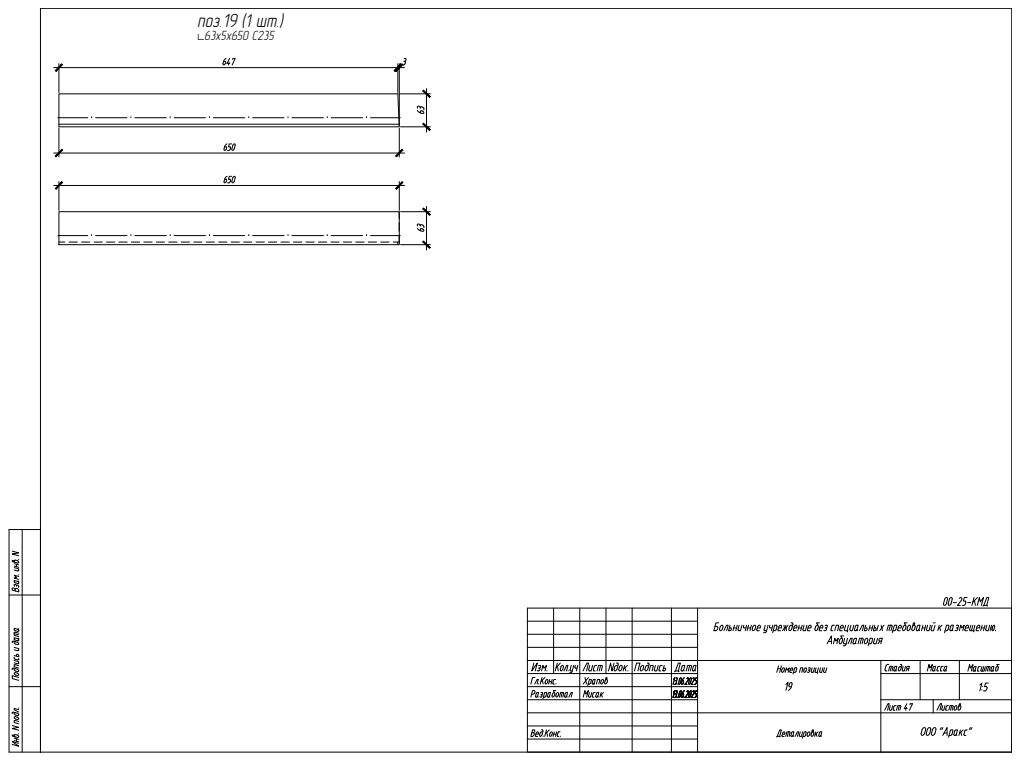
[picture p31: page 17]
поз.19 (1 шт.) L63x5x650 С235

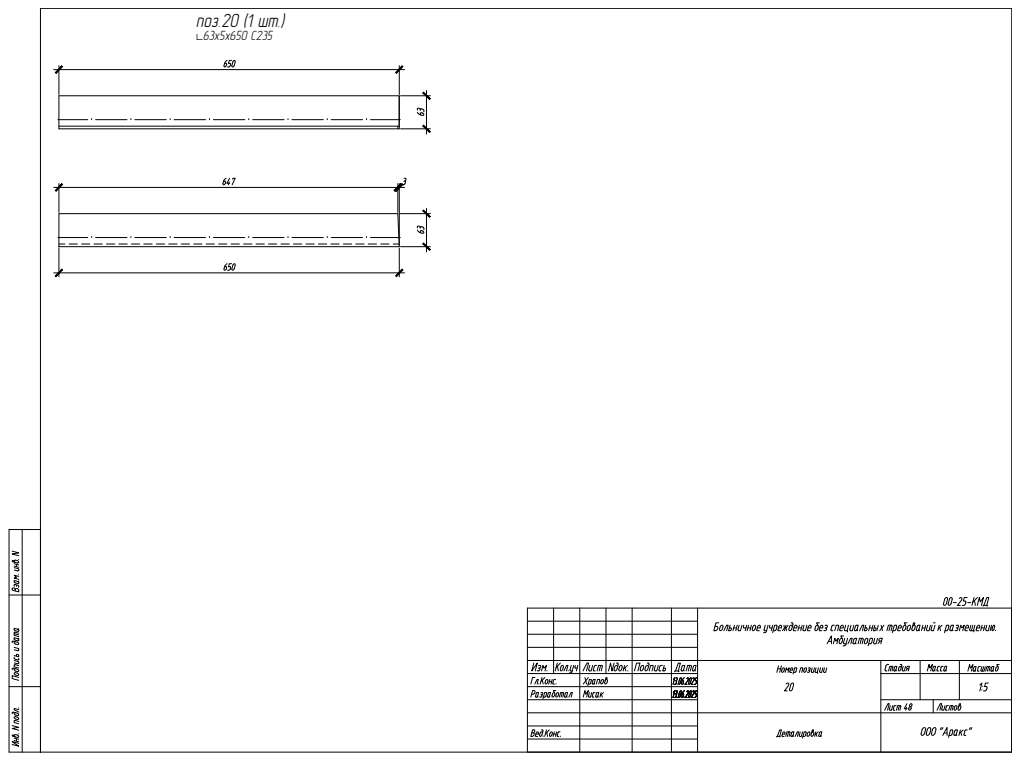
[picture p32: page 18]
поз.20 (1 шт.) L63x5x650 С235

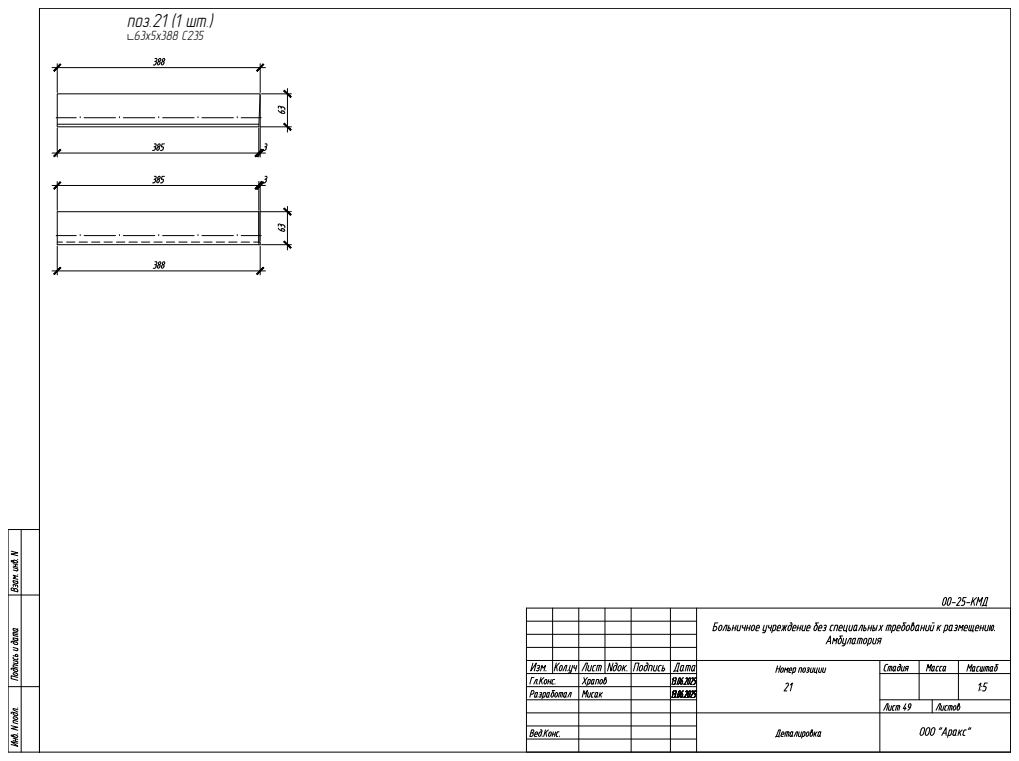
[picture p33: page 19]
поз.21 (1 шт.) L63x5x388 С235

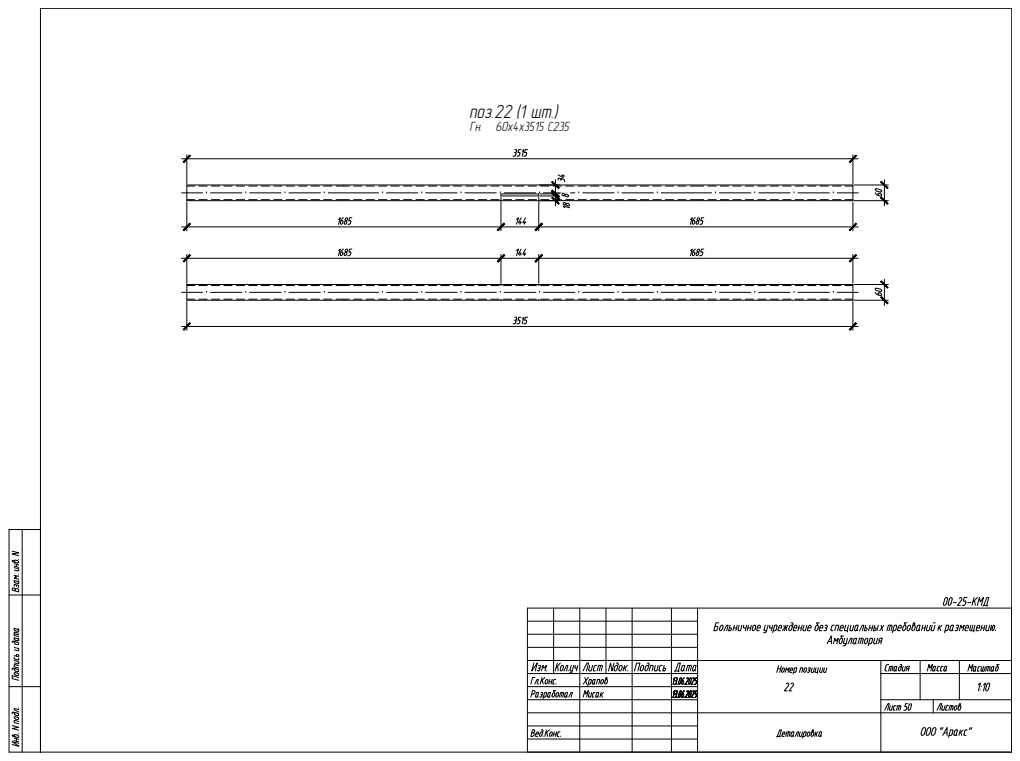
[picture p34: page 20]

поз.22 (1 шт.) Гн. 60x4x3515 С235

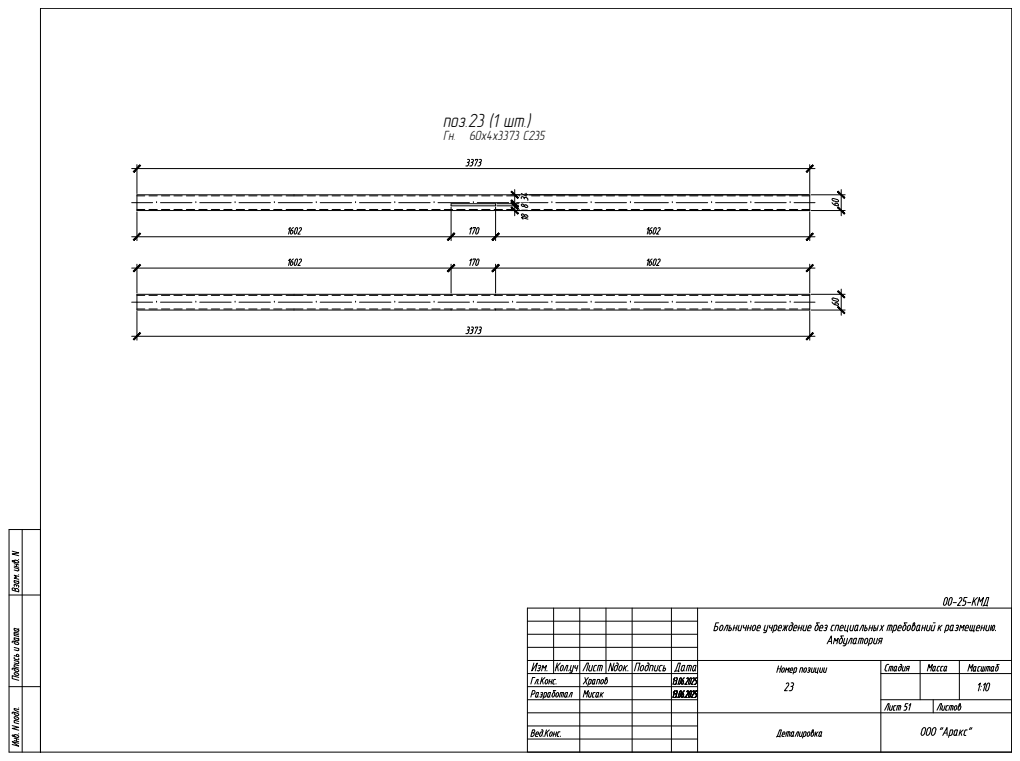
[picture p35: page 21]

поз.23 (1 шт.) Гн. 60x4x3373 С235

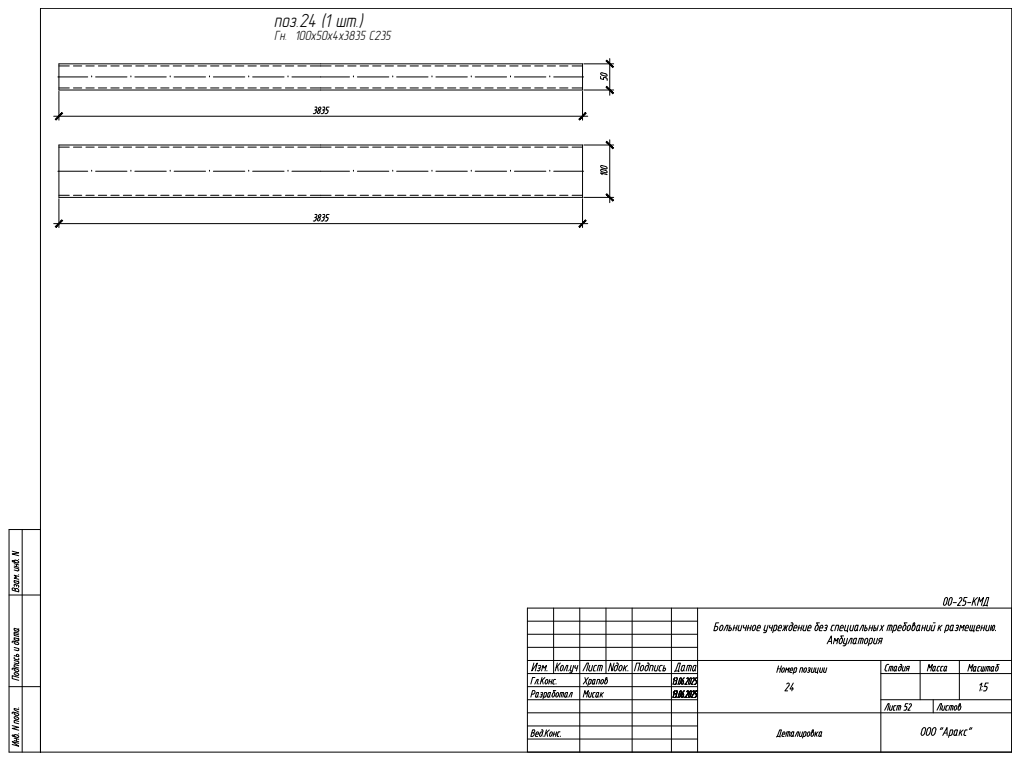
[picture p36: page 22]

поз.24 (1 шт.) Гн. 100x50x4x3835 С235

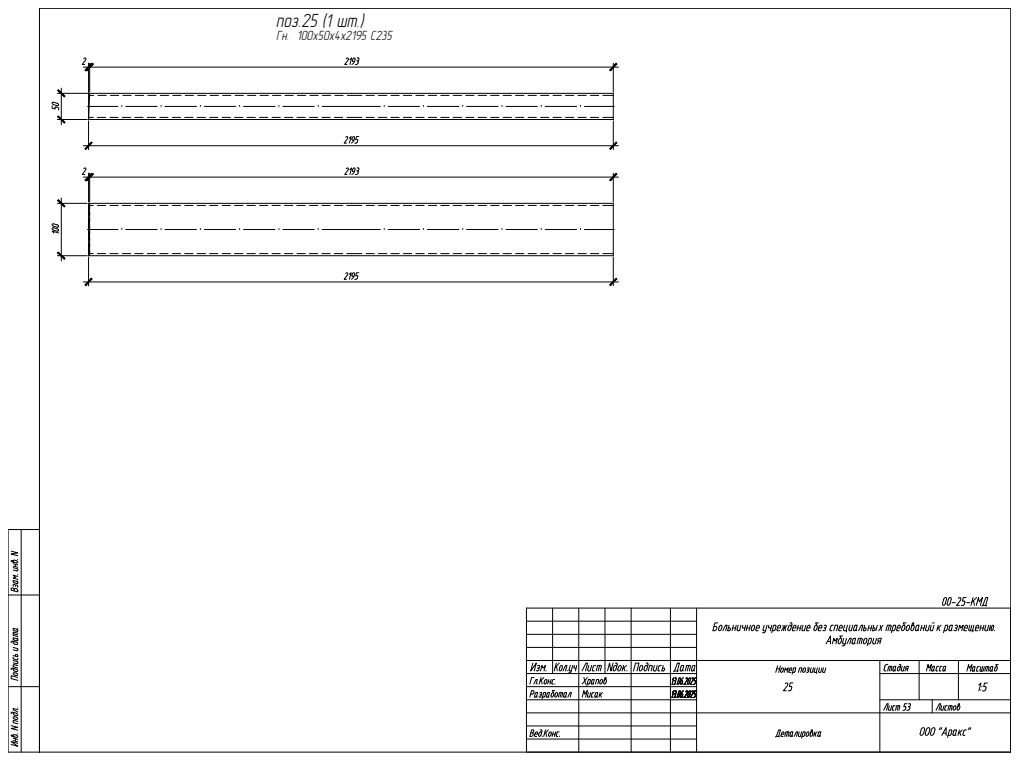
[picture p37: page 23]

поз.25 (1 шт.) Гн. 100x50x4x2195 С235

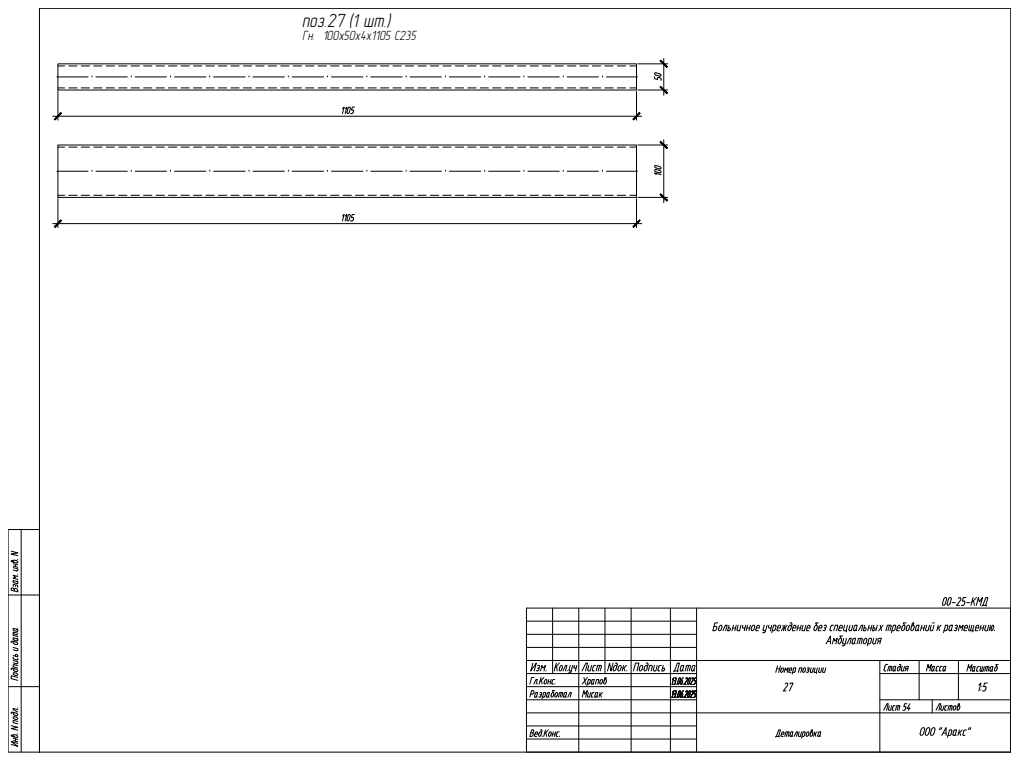
[picture p38: page 24]

поз.27 (1 шт.) Гн. 100x50x4x1105 С235

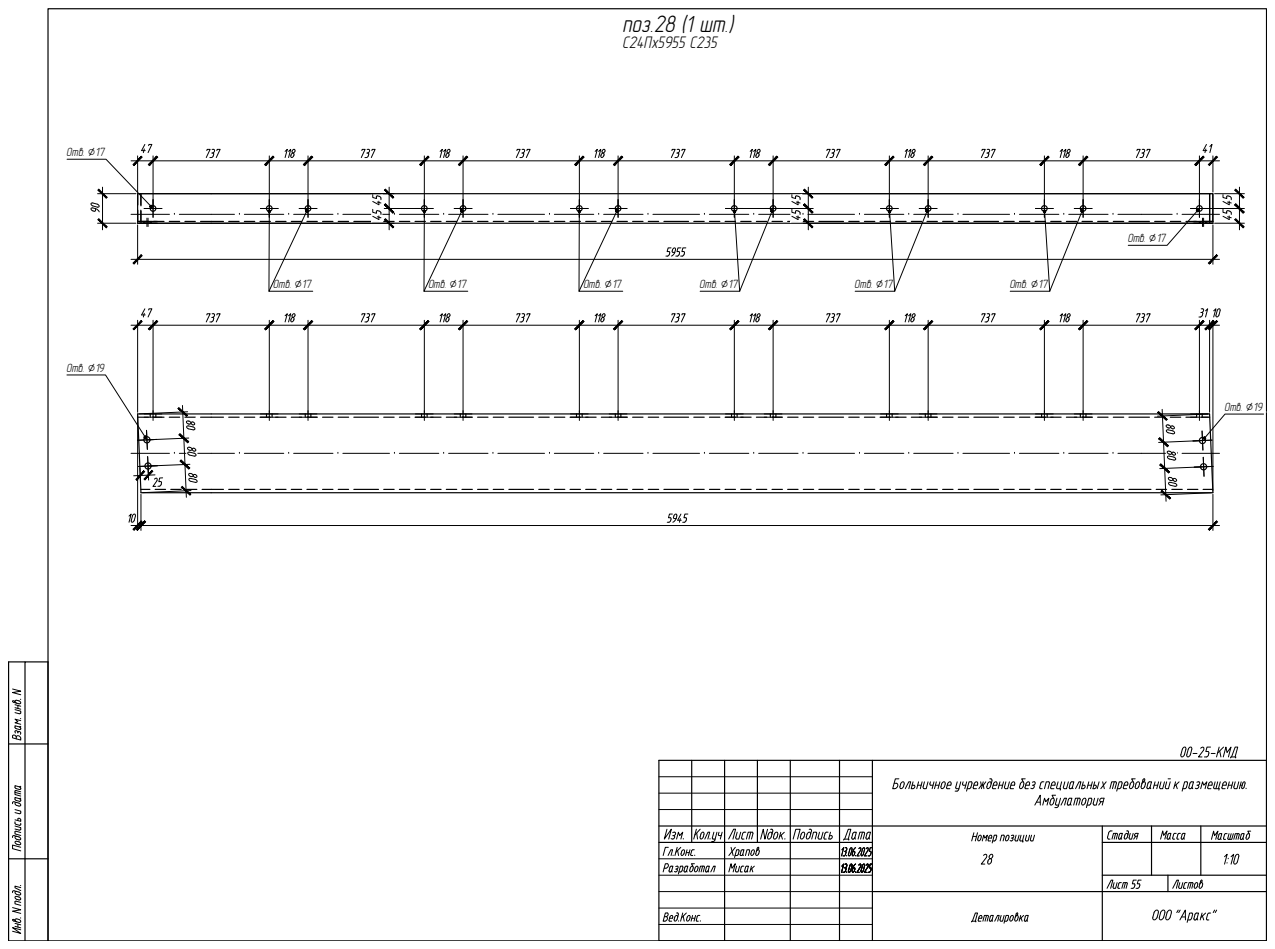
[picture p39: page 25]
поз.28 (1 шт.) С24Пx5955 С235; Отв. 19 Отв. 19; Отв. 17 Отв. 17; Отв. 17
