misakigr/Ambulat_pristr/Колонны.pdf

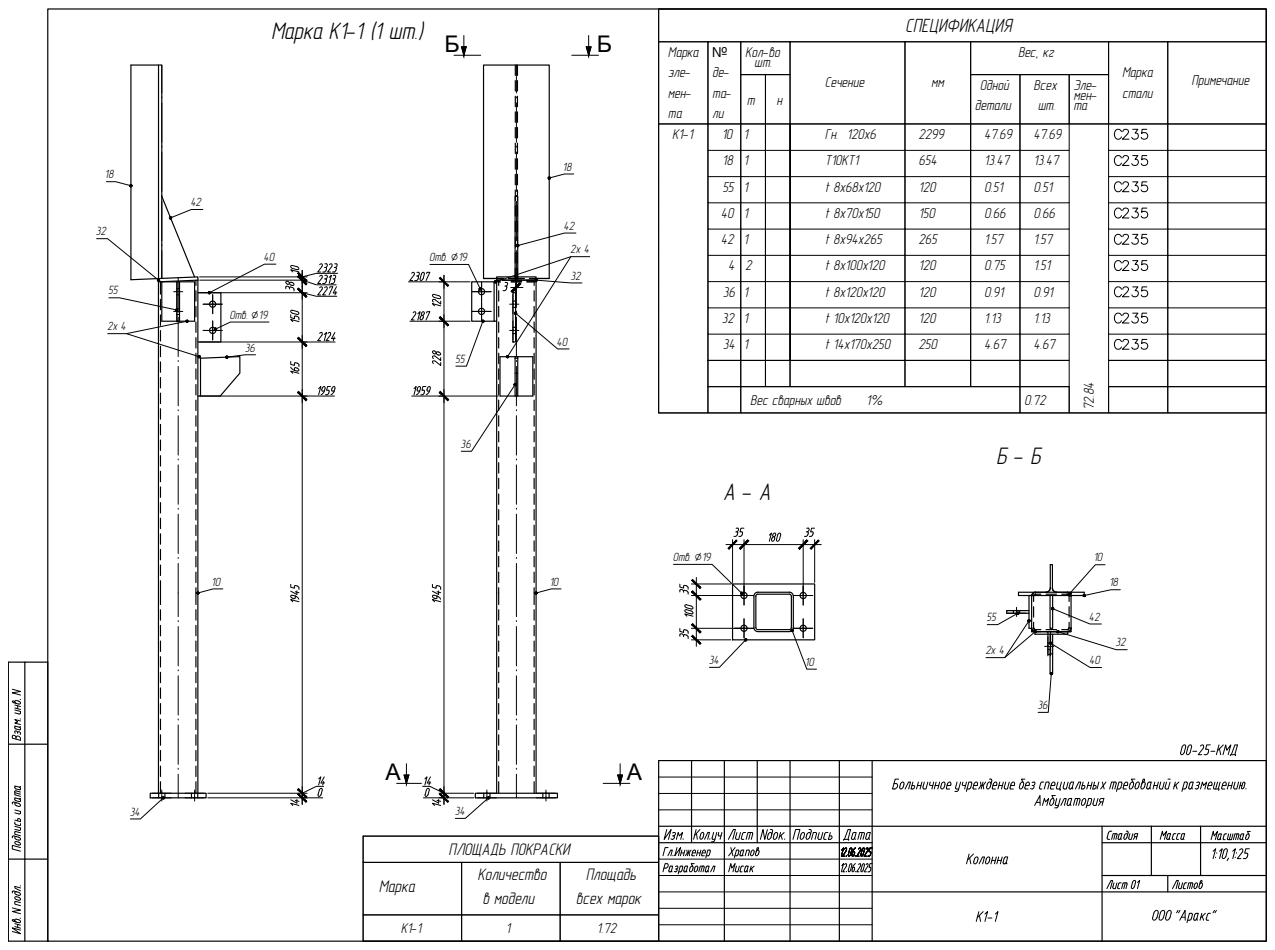
[picture p40: page 1]
СПЕЦИФИКАЦИЯ Марка эле- мен- та; Кол-во шт.; Всех шт. Одной детали Вес, кг Сечение; Примечание Марка стали Эле- мен- та К1-1; 4.67 Вес сварных швов

72.84 ПЛОЩАДЬ ПОКРАСКИ Площадь всех марок Количество в модели МаркаК1-1 1 1.72 Марка К1-1 (1 шт.) 10 42 34 2x 4 55 Отв. 19 18 36 40 32 А А Б Б 10 42 34 2x 4 55 18 36 40 Отв. 19 32 34 10 Отв. 19 А - А 10 42 2x 4 55 18 36 40 32 Б - Б

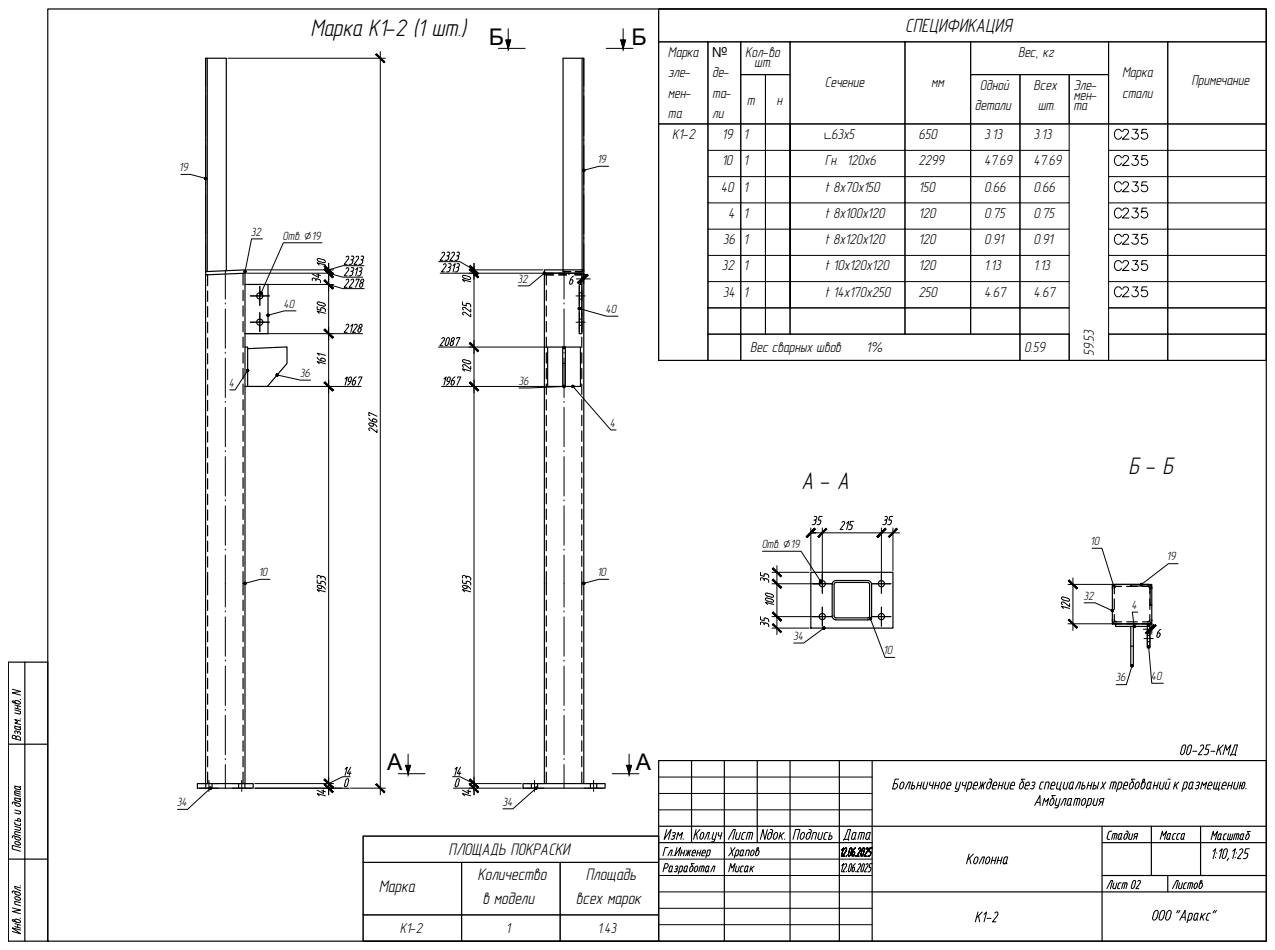
[picture p41: page 2]
СПЕЦИФИКАЦИЯ Марка эле- мен- та; Кол-во шт.; Всех шт. Одной детали Вес, кг Сечение; Примечание Марка стали Эле- мен- та К1-2; 4.67 Вес сварных швов

59.53 ПЛОЩАДЬ ПОКРАСКИ Площадь всех марок Количество в модели МаркаК1-2 1 1.43 Марка К1-2 (1 шт.) 10 34 404 36 19 32 А А Б Б 10 34 40Отв. 19 4 36 19 32 10 34 Отв. 19А - А 10 40 4 36 19 32 Б - Б

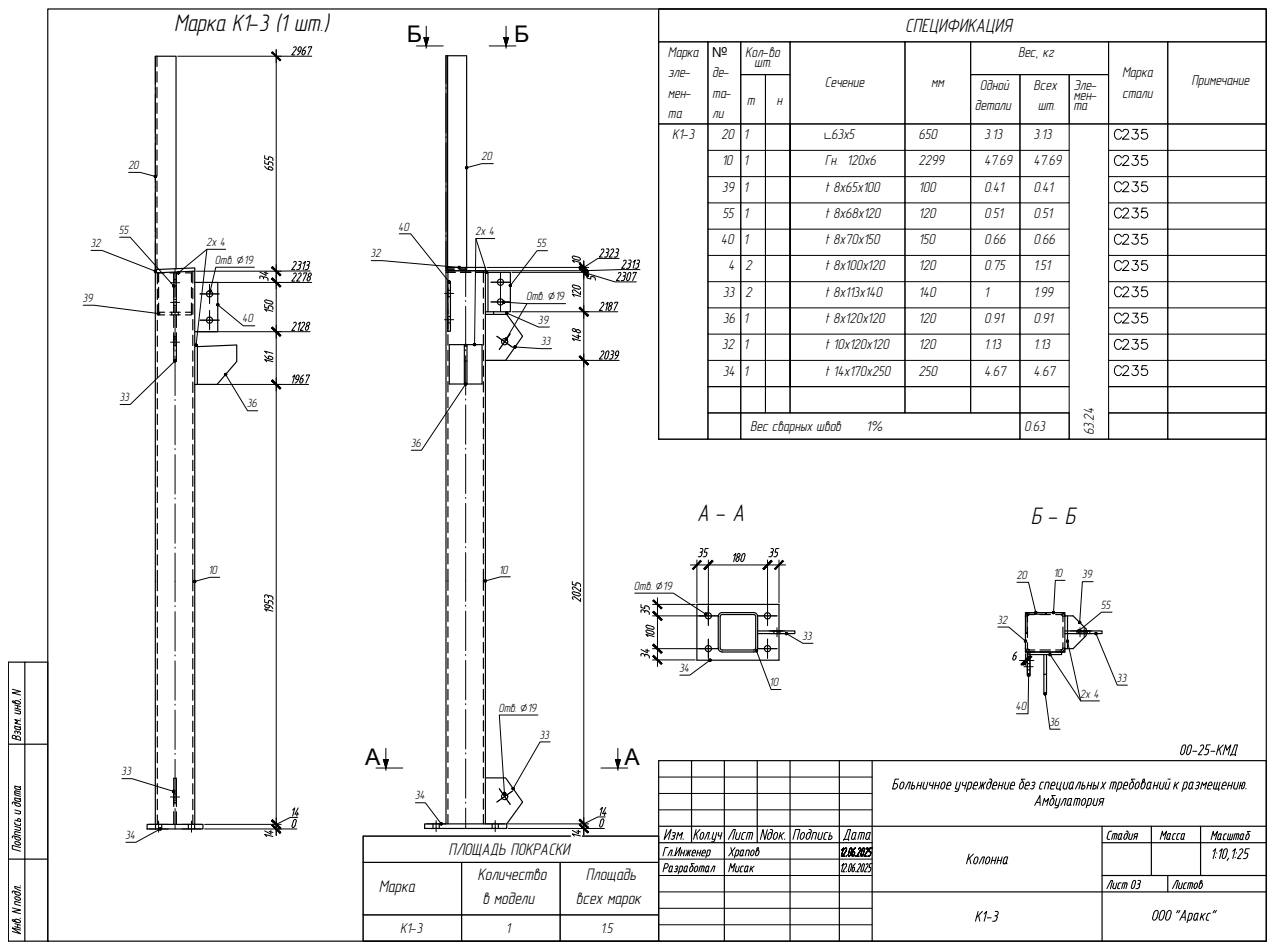
[picture p42: page 3]
СПЕЦИФИКАЦИЯ Марка эле- мен- та; Кол-во шт.; Всех шт. Одной детали Вес, кг Сечение; Примечание Марка стали Эле- мен- та К1-3; 4.67 Вес сварных швов

63.24 ПЛОЩАДЬ ПОКРАСКИ Площадь всех марок Количество в модели МаркаК1-3 1 1.5 Марка К1-3 (1 шт.) 10 33 Отв. 19 33 Отв. 19 39 34 2x 4 55 40 36 20 32 А А Б Б 10 3333 39 34 2x 4 55 40 Отв. 1936 20 32 10 33 34 Отв. 19 А - А 10 33 392x 4 55 40 36 20 32 Б - Б

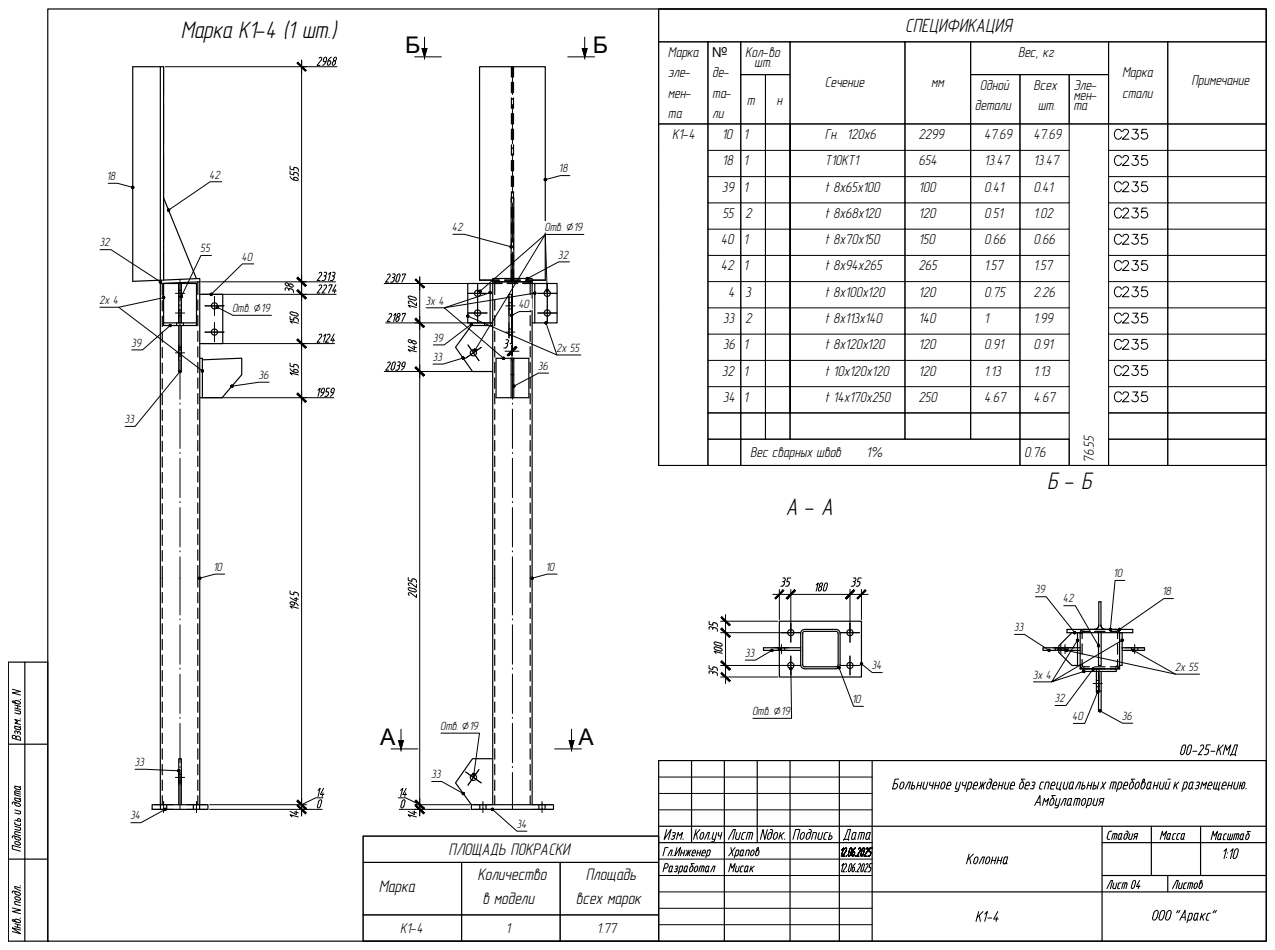
[picture p43: page 4]
СПЕЦИФИКАЦИЯ Марка эле- мен- та; Кол-во шт.; Всех шт. Одной детали Вес, кг Сечение; Примечание Марка стали Эле- мен- та К1-4; 4.67 Вес сварных швов

76.55 ПЛОЩАДЬ ПОКРАСКИ Площадь всех марок Количество в модели МаркаК1-4 1 1.77 Марка К1-4 (1 шт.) 10 33Отв. 19 33 42 Отв. 19 18 39 34 3x 4 2x 55 36 40 32 А А Б Б 10 33 33 18 42 3934 2x 4 55 36 40 Отв. 19 32 10 33 34 Отв. 19А - А 10 33 42 39 18 3x 4 2x 55 40 36 32 Б - Б

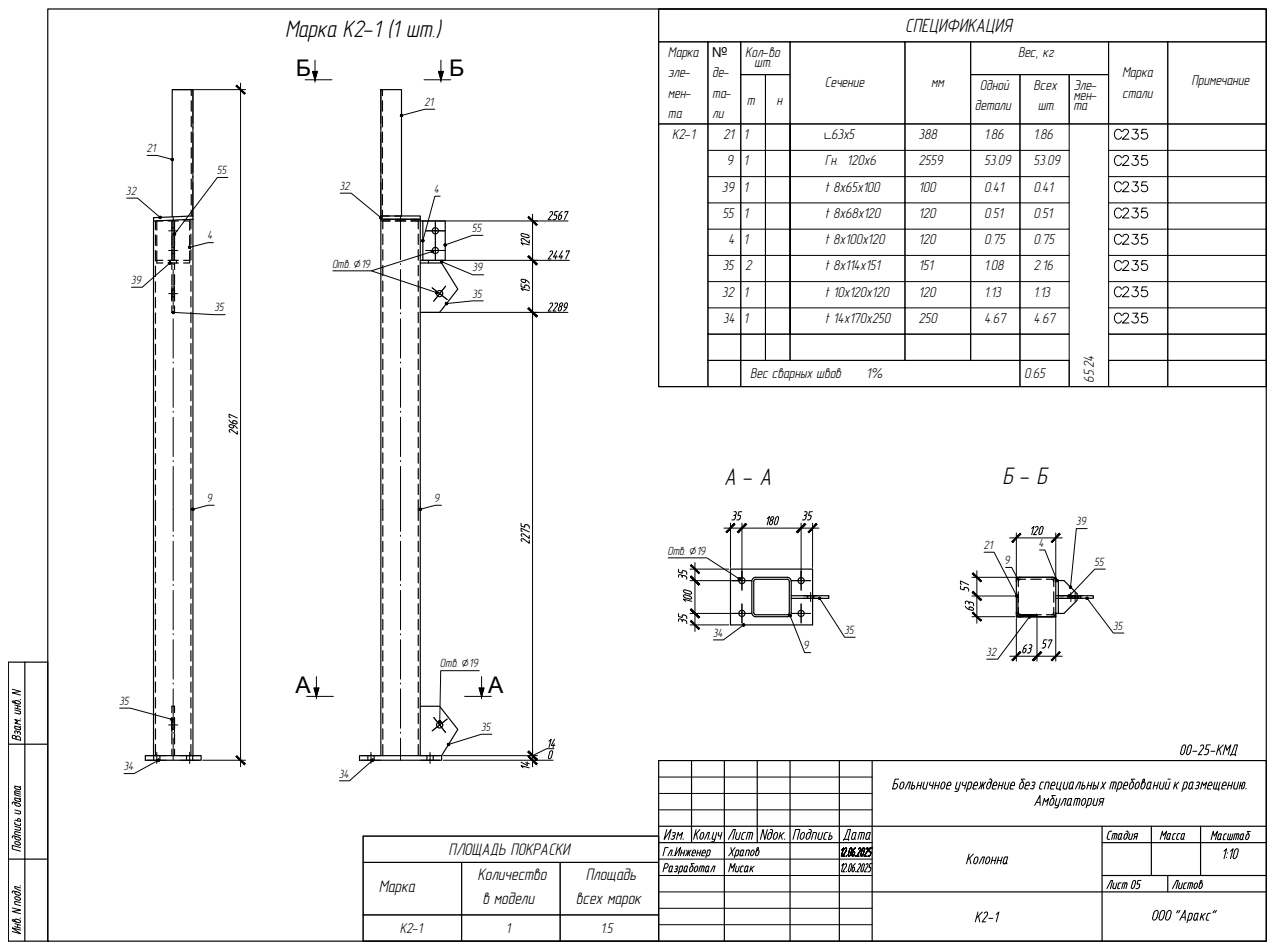
[picture p44: page 5]
СПЕЦИФИКАЦИЯ Марка эле- мен- та; Кол-во шт.; Всех шт. Одной детали Вес, кг Сечение; Примечание Марка стали Эле- мен- та К2-1; 4.67 Вес сварных швов

65.24 ПЛОЩАДЬ ПОКРАСКИ Площадь всех марок Количество в модели МаркаК2-1 1 1.5 Марка К2-1 (1 шт.)9 35 Отв. 19 35 Отв. 1939 34 4 55 21 32 А А Б Б 9 35 3539 34 4 55 21 32 9 35 34 Отв. 19 А - А 9 35 39 4 55 2132 Б - Б

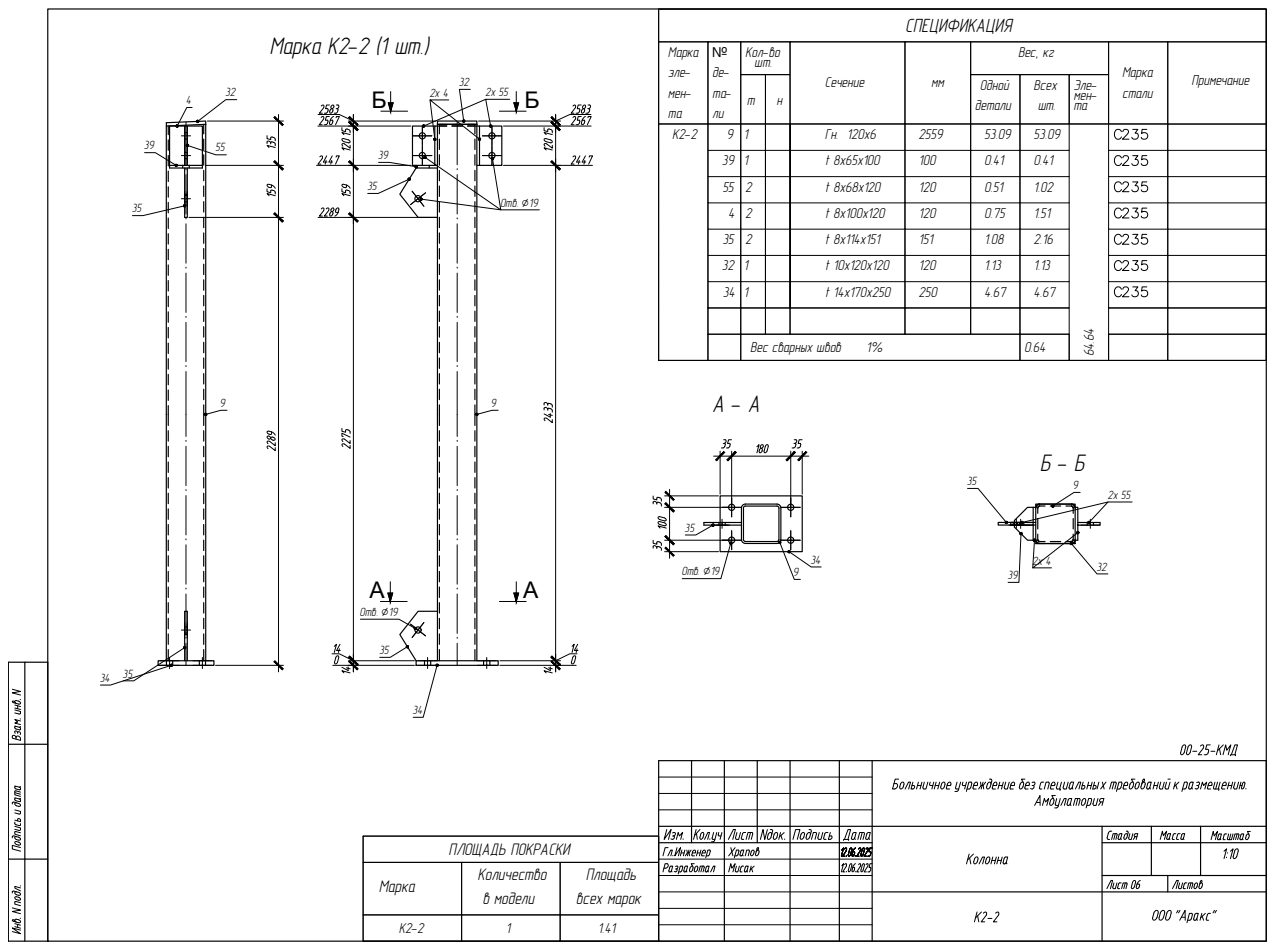
[picture p45: page 6]
СПЕЦИФИКАЦИЯ Марка эле- мен- та; Кол-во шт.; Всех шт. Одной детали Вес, кг Сечение; Примечание Марка стали Эле- мен- та К2-2; 4.67 Вес сварных швов

64.64 ПЛОЩАДЬ ПОКРАСКИ Площадь всех марок Количество в модели Марка К2-2 1 1.41 Марка К2-2 (1 шт.) 9 35 Отв. 19 35 Отв. 19 39 34 2x 4 2x 55 32 А А Б Б 9 35 35 39 34 4 5532 9 35 34 Отв. 19А - А 9 35 39 2x 4 2x 55 32 Б - Б

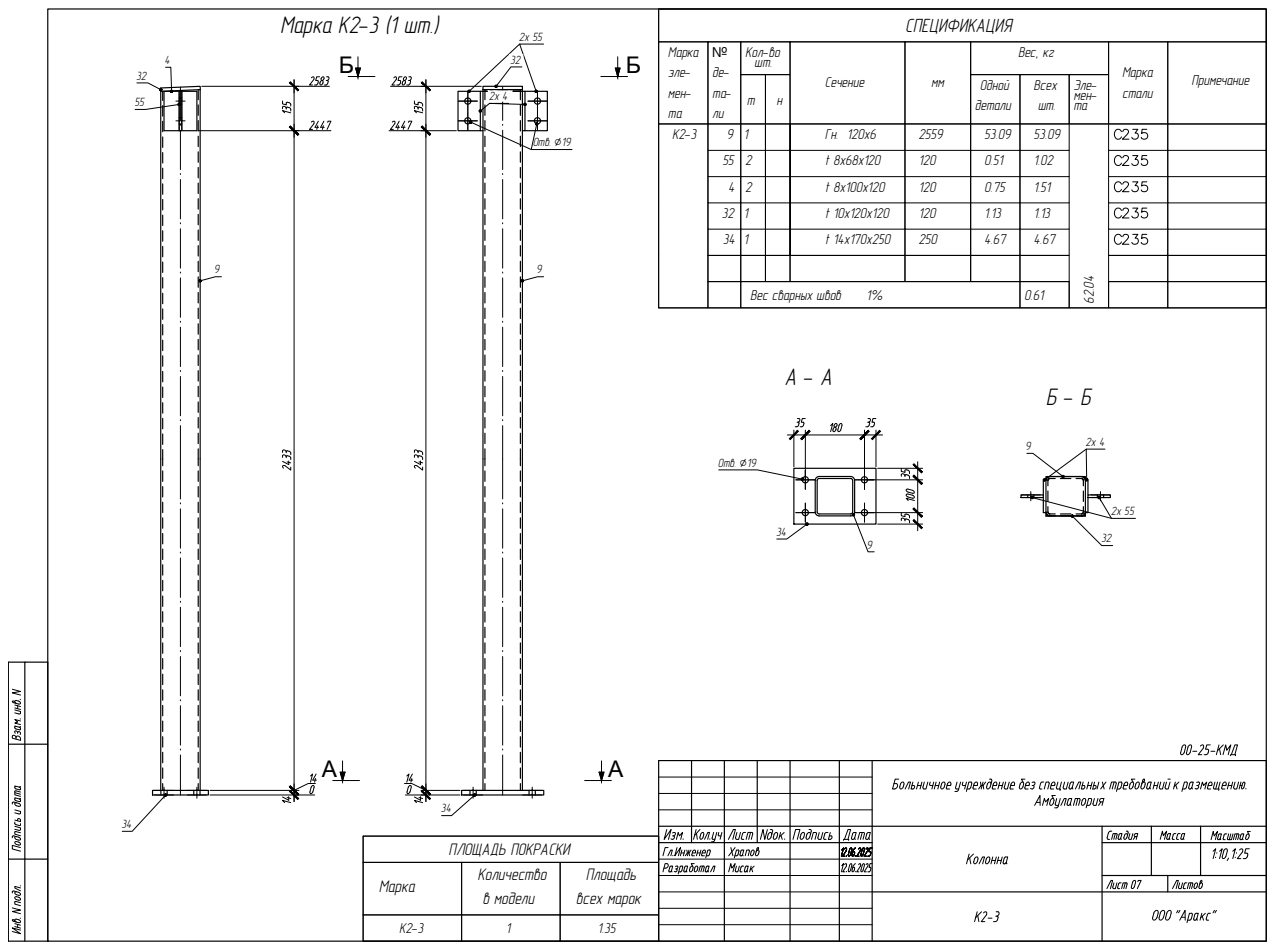
[picture p46: page 7]
СПЕЦИФИКАЦИЯ Марка эле- мен- та; Кол-во шт.; Всех шт. Одной детали Вес, кг Сечение; Примечание Марка стали Эле- мен- та К2-3; 4.67 Вес сварных швов

62.04 ПЛОЩАДЬ ПОКРАСКИ Площадь всех марок Количество в модели Марка К2-3 1 1.35 9 34 2x 4 2x 55Отв. 19 32 9 2x 4 2x 55 32 А А Б Б Б - Б Марка К2-3 (1 шт.) 9 34 4 5532 9 34 Отв. 19 А - А

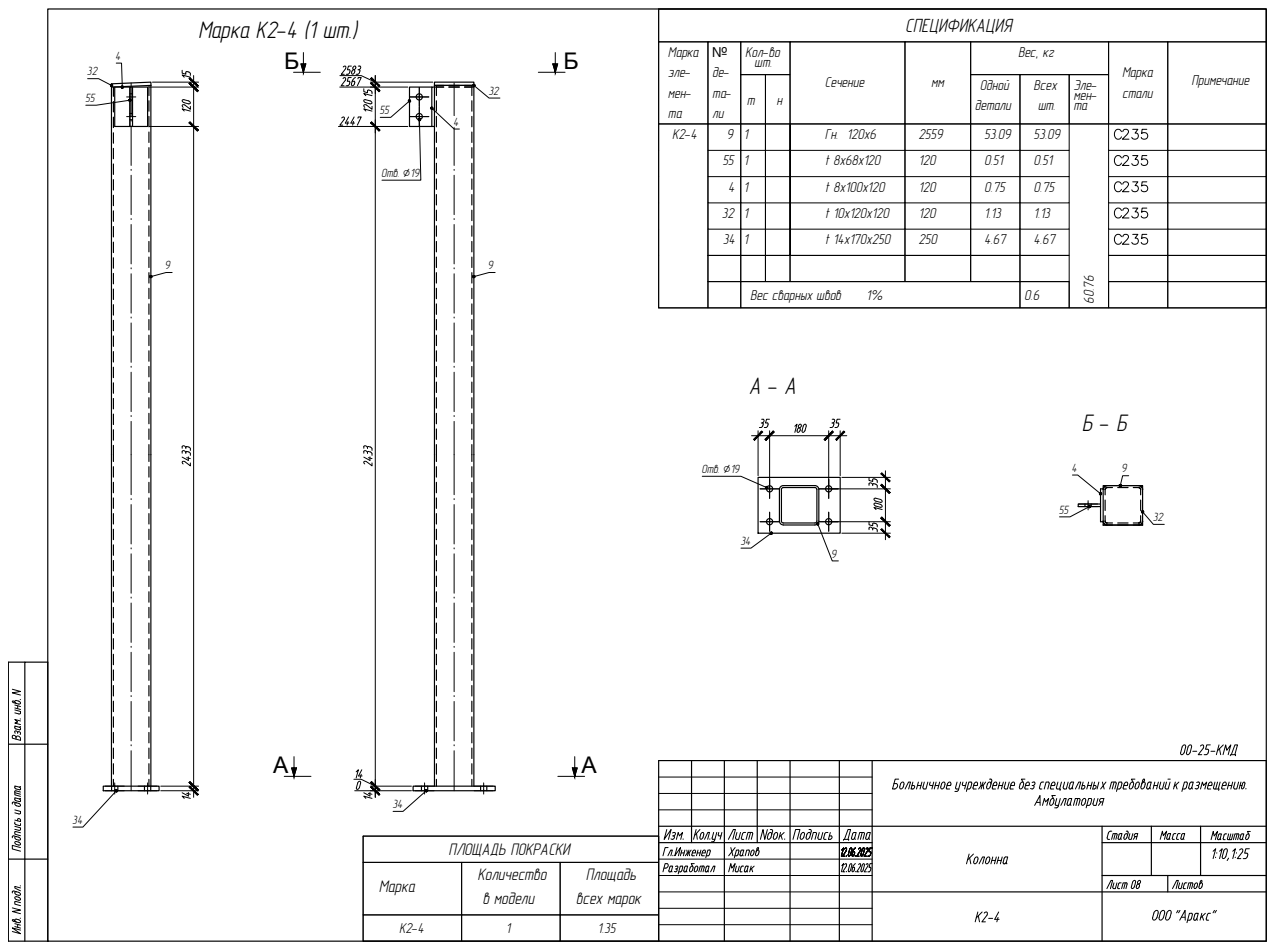
[picture p47: page 8]
СПЕЦИФИКАЦИЯ Марка эле- мен- та; Кол-во шт.; Всех шт. Одной детали Вес, кг Сечение; Примечание Марка стали Эле- мен- та К2-4; 4.67 Вес сварных швов

60.76 ПЛОЩАДЬ ПОКРАСКИ Площадь всех марок Количество в модели Марка К2-4 1 1.35 Марка К2-4 (1 шт.) 9 4 55Отв. 19 34 32 А А Б Б 9 4 55 34 32 9 34 Отв. 19 А - А 4 9 55 32 Б - Б
