misakigr/Ambulat_pristr/Общий Вид.pdf

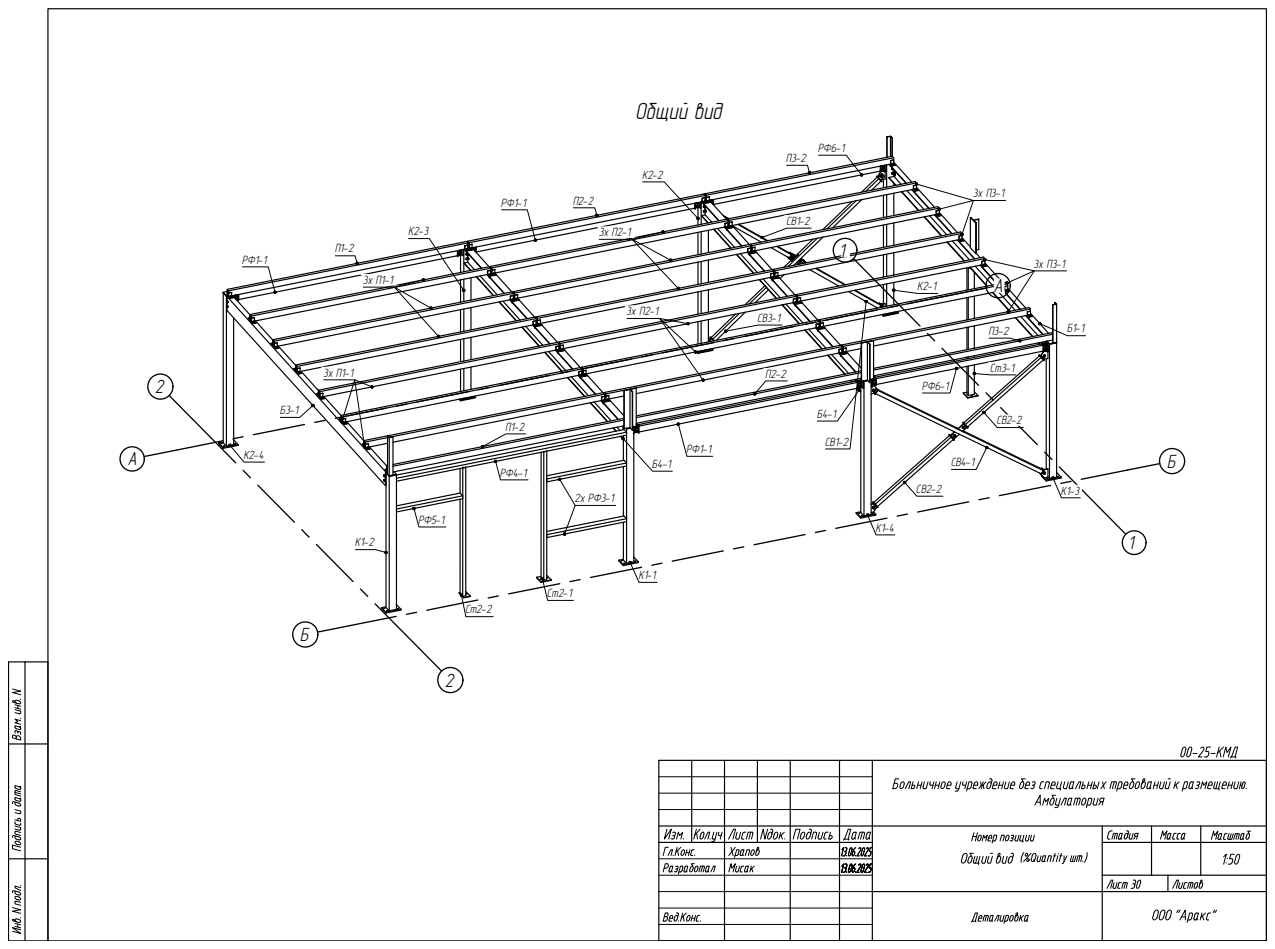
[picture p48: page 1]
Общий вид К2-2 К2-3 К2-4

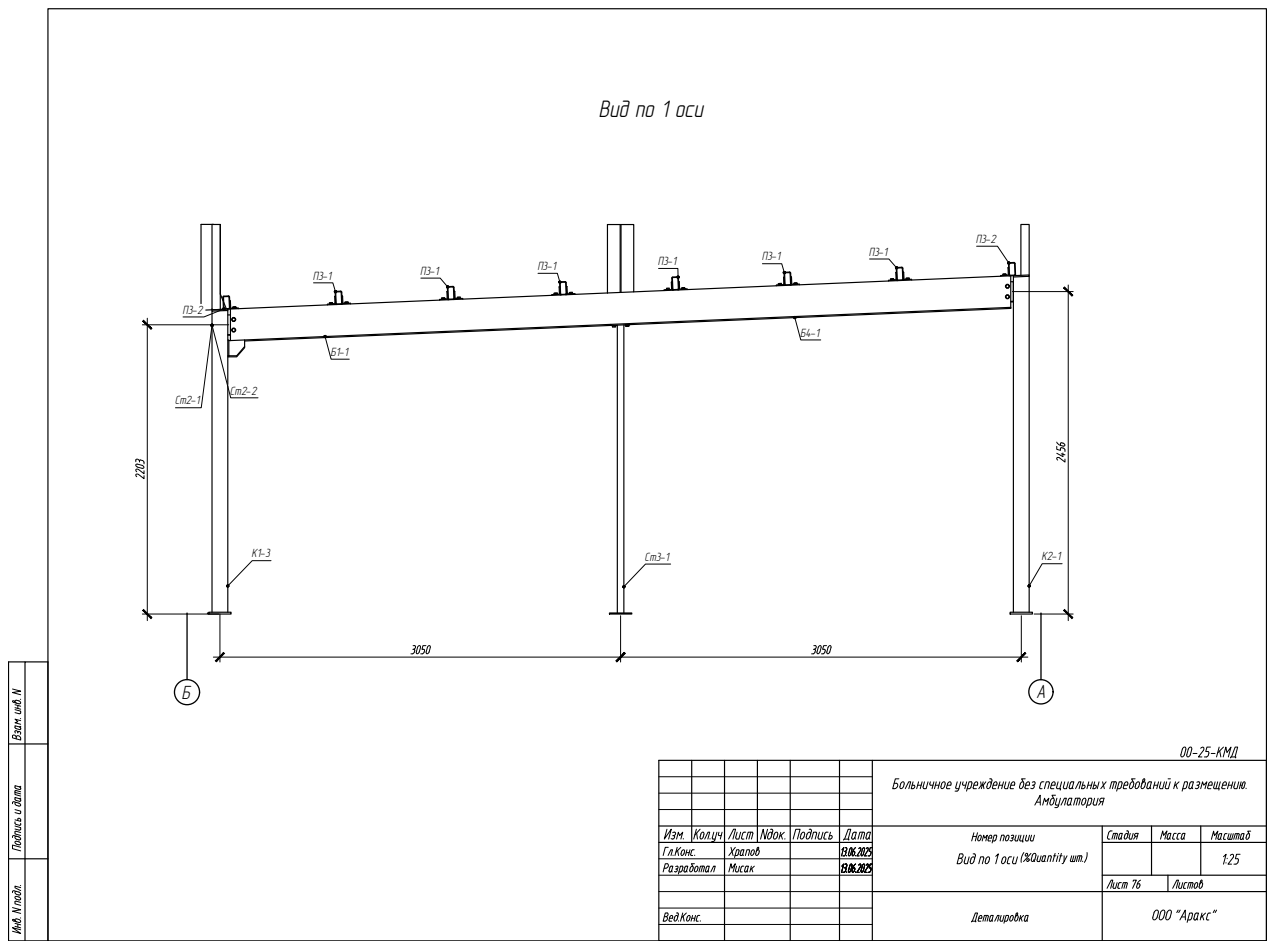
[picture p49: page 2]
А Вид по 1 оси К1-3

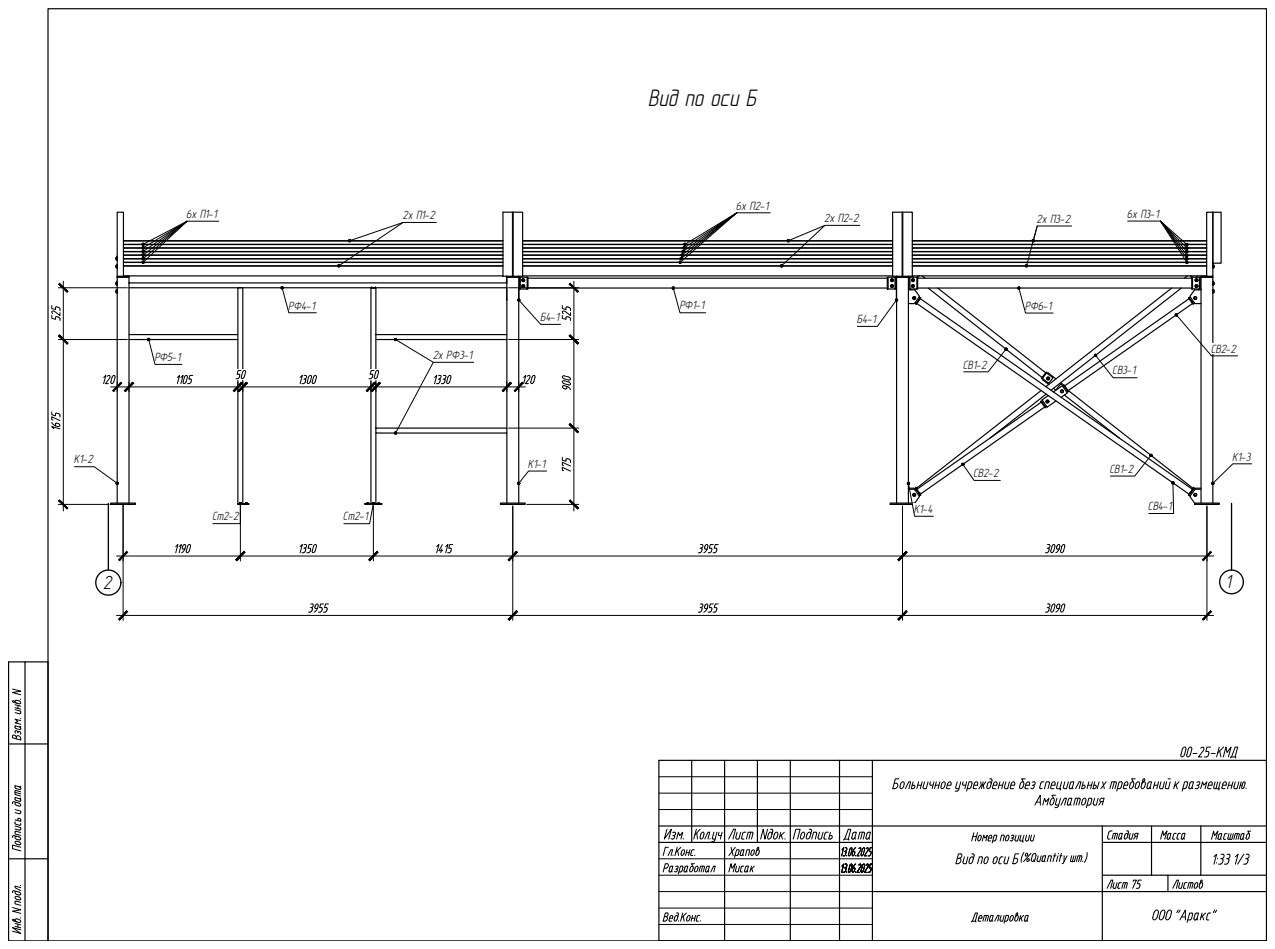
[picture p50: page 3]
1 Вид по оси Б К1-1 К1-2
