misakigr/Ambulat_pristr/Пластины.pdf

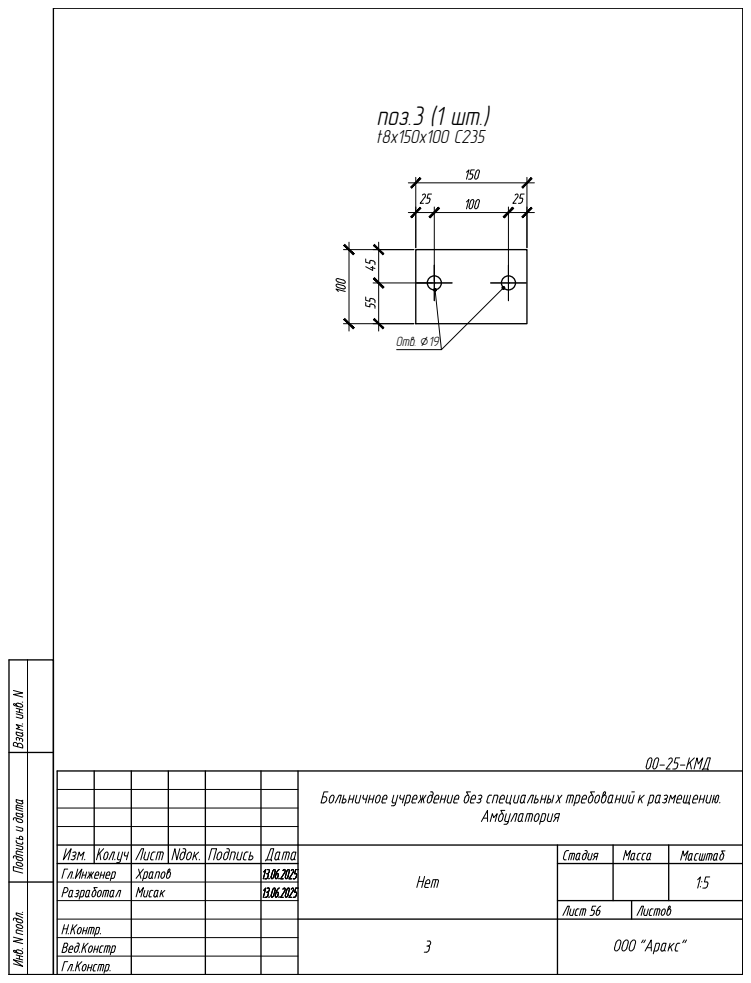
[picture p51: page 1]
Отв. 19; поз.3 (1 шт.) t8x150x100 С235

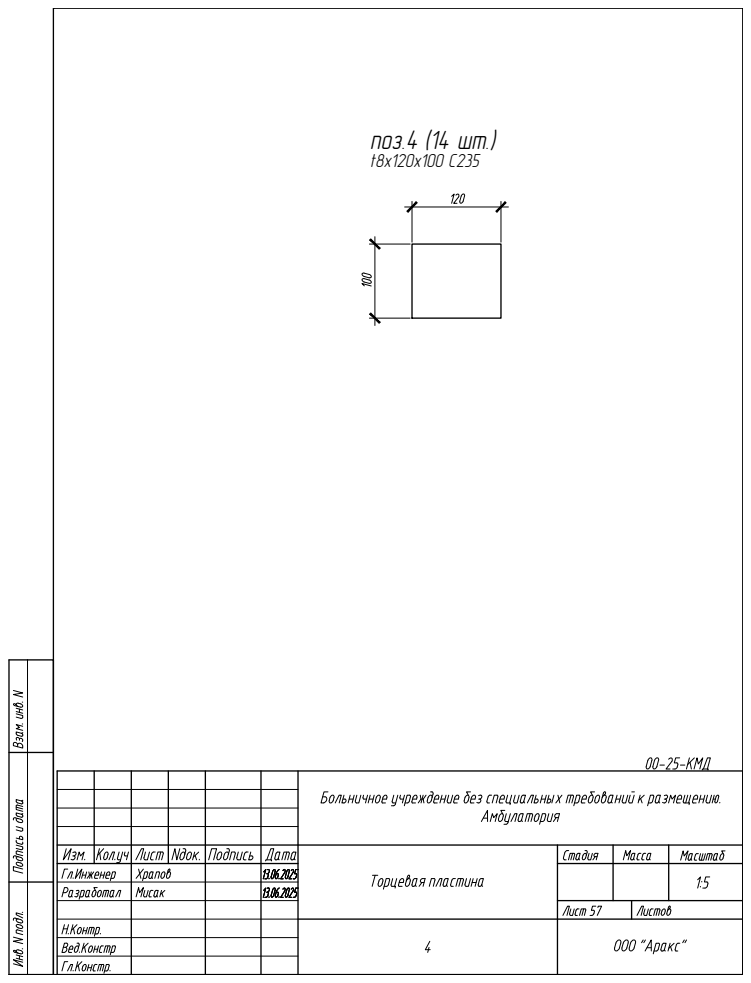
[picture p52: page 2]
поз.4 (14 шт.) t8x120x100 С235

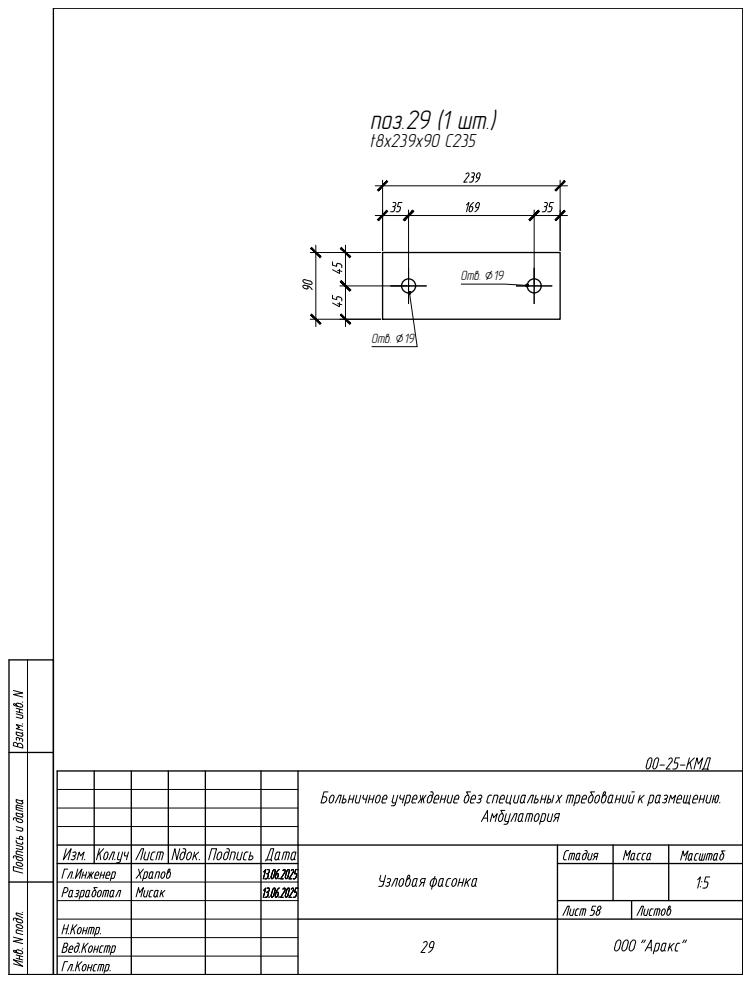
[picture p53: page 3]
поз.29 (1 шт.) t8x239x90 С235; Отв. 19

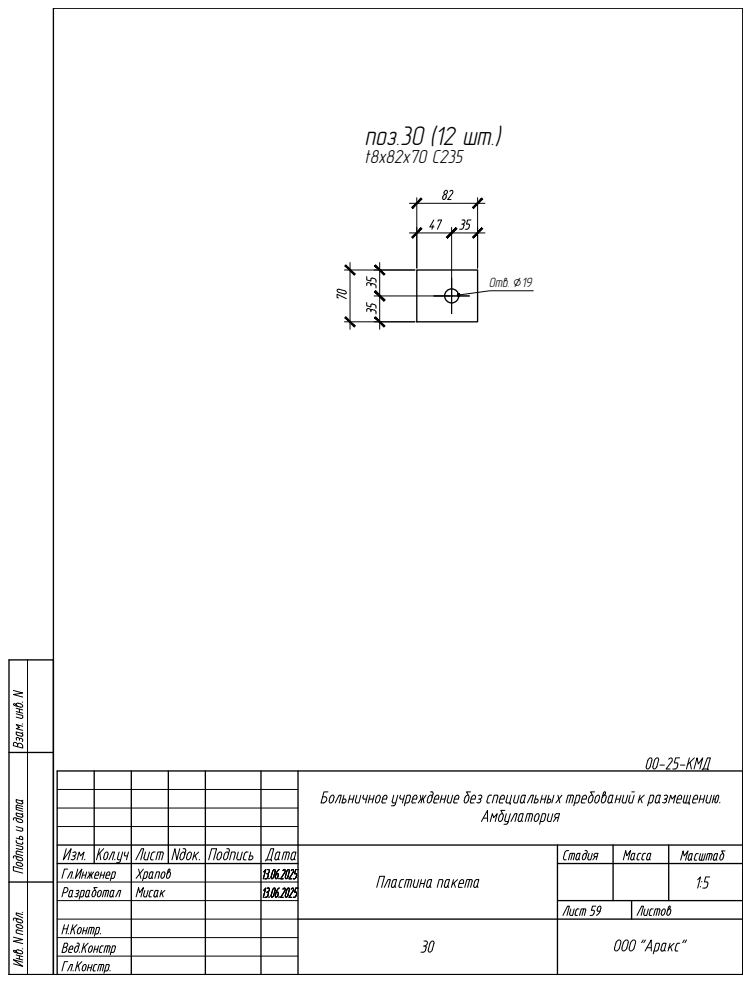
[picture p54: page 4]
поз.30 (12 шт.) t8x82x70 С235; Отв. 19

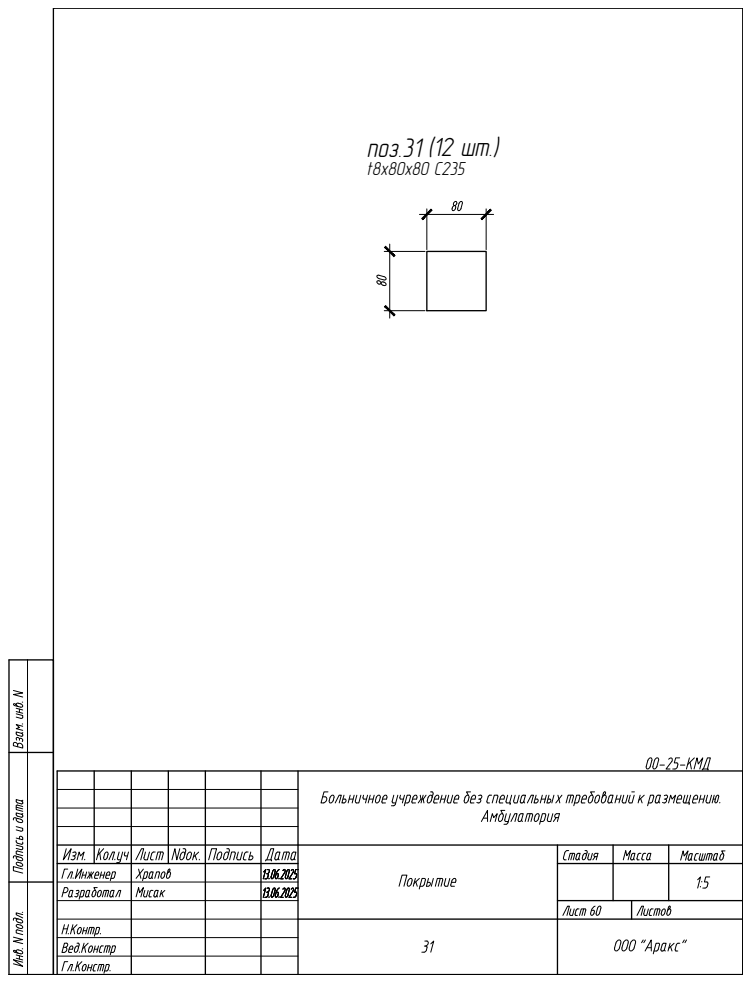
[picture p55: page 5]
поз.31 (12 шт.) t8x80x80 С235

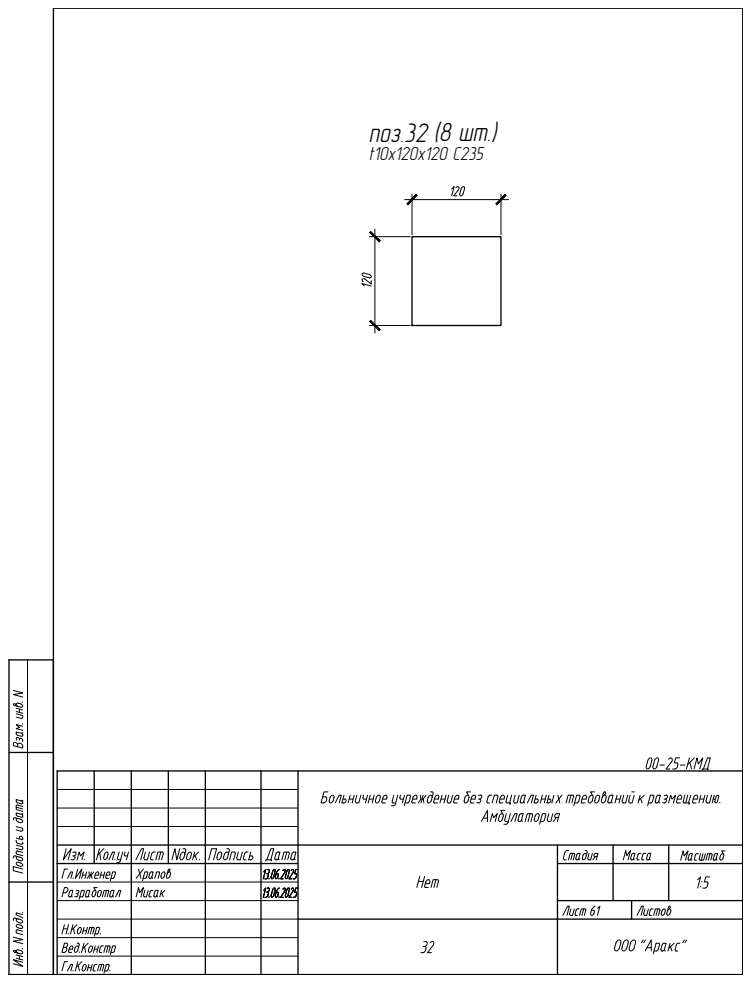
[picture p56: page 6]
поз.32 (8 шт.) t10x120x120 С235

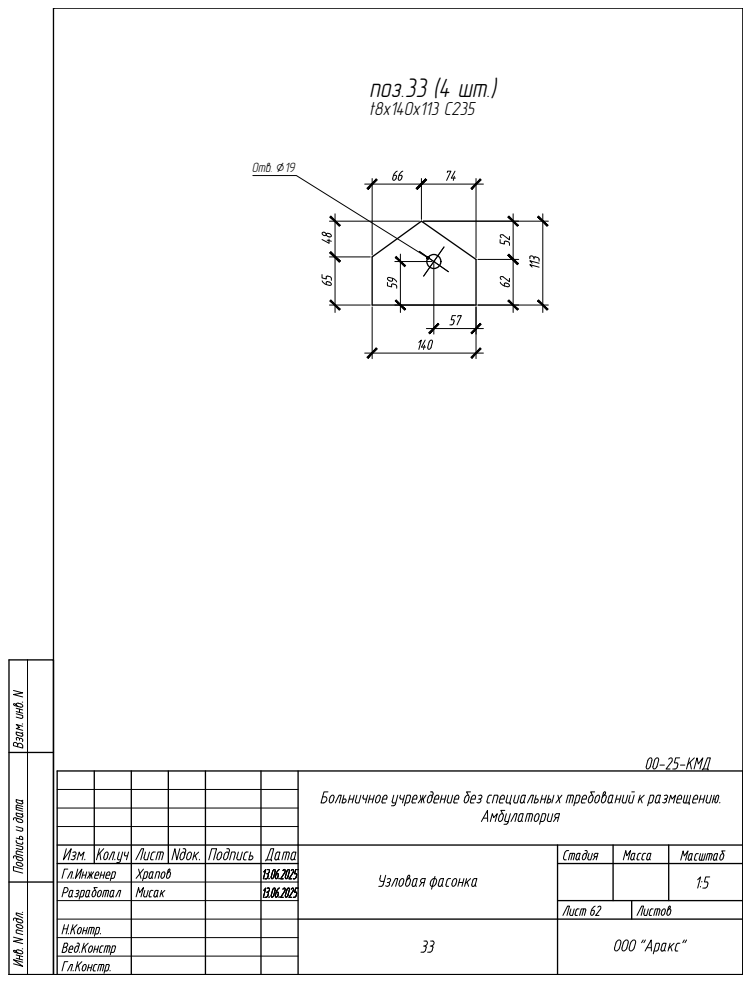
[picture p57: page 7]
поз.33 (4 шт.) t8x140x113 С235; Отв. 19

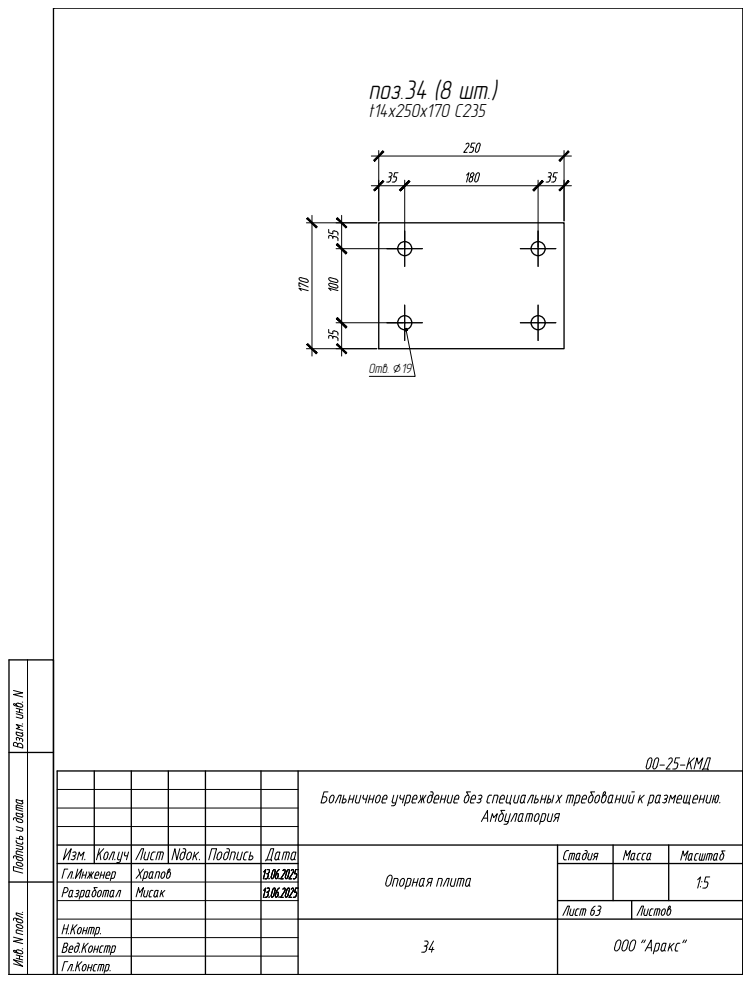
[picture p58: page 8]
поз.34 (8 шт.) t14x250x170 С235; Отв. 19

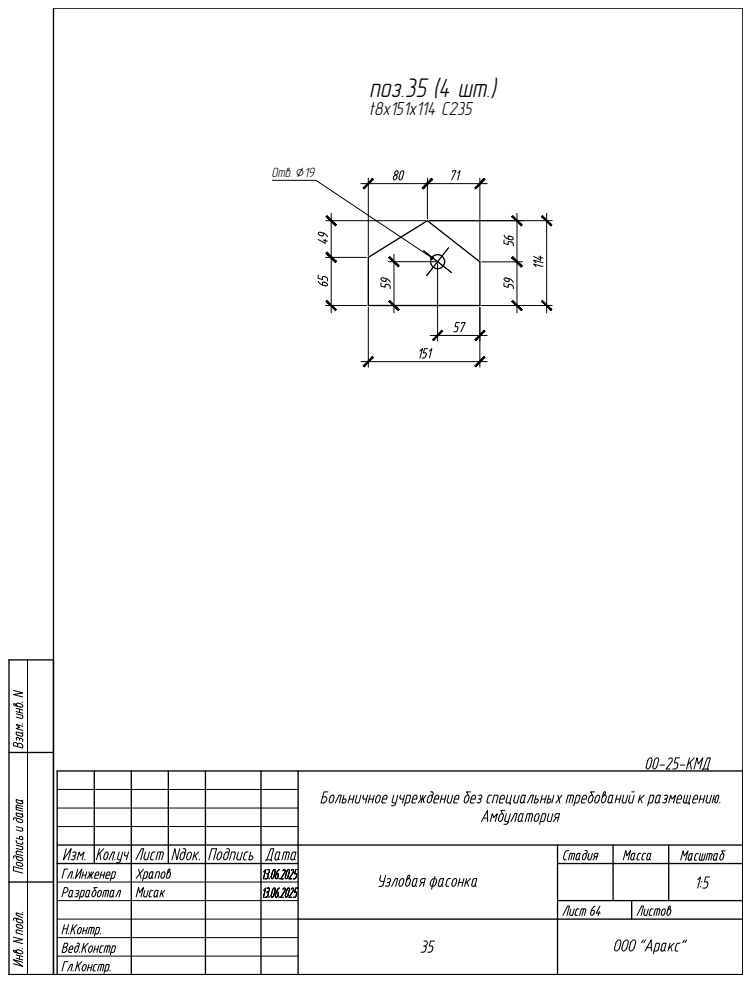
[picture p59: page 9]
поз.35 (4 шт.) t8x151x114 С235; Отв. 19

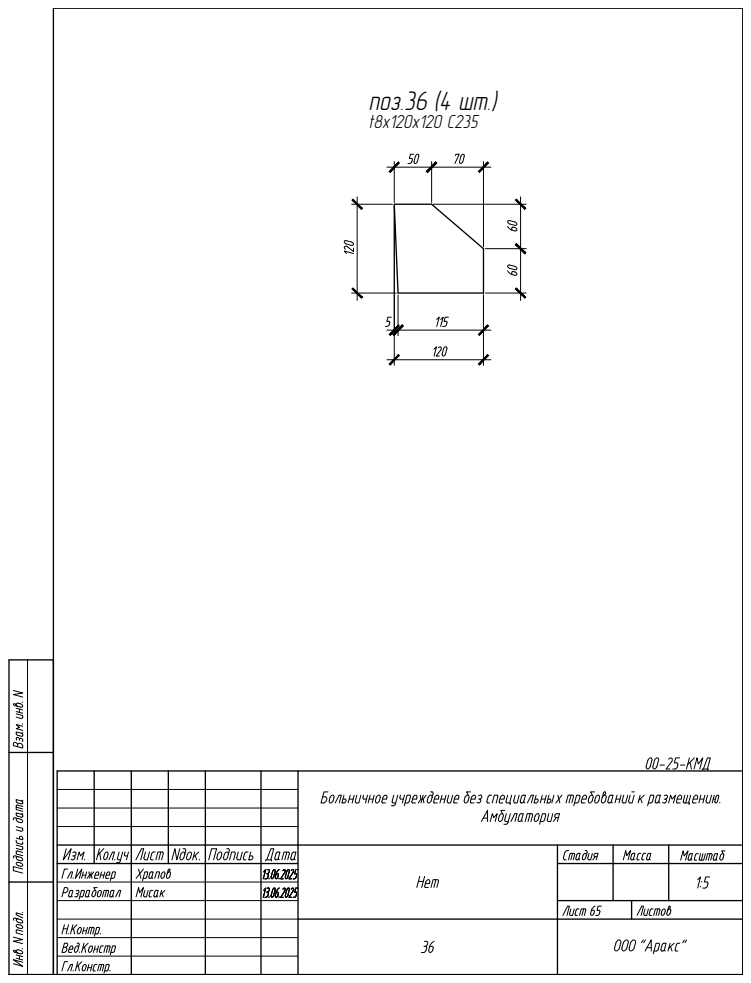
[picture p60: page 10]
поз.36 (4 шт.) t8x120x120 С235

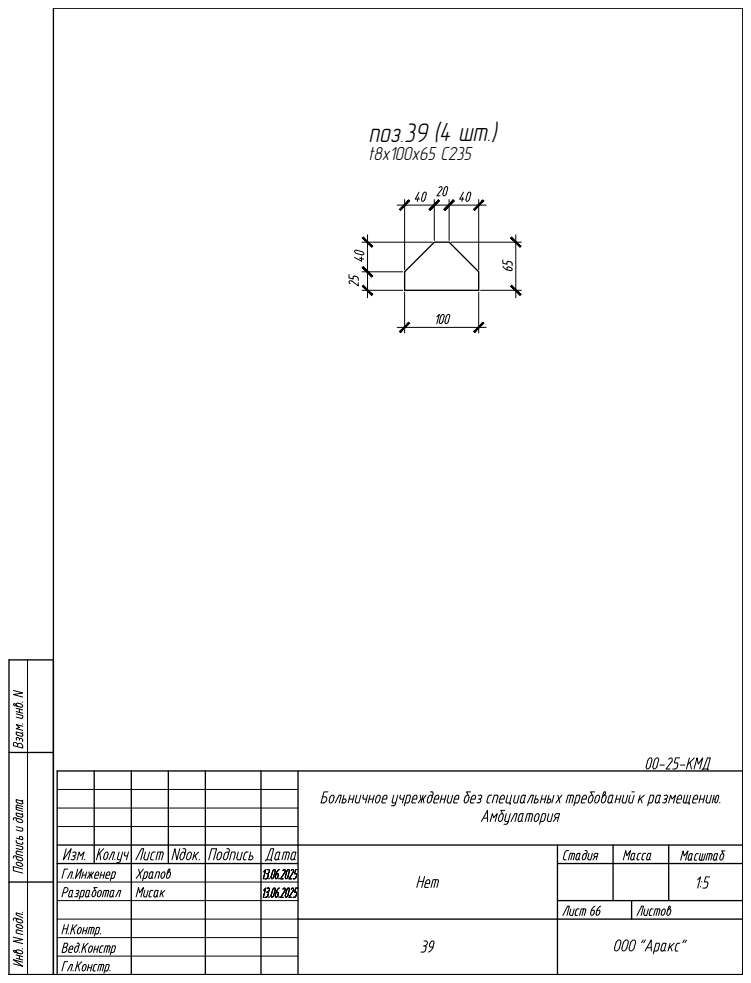
[picture p61: page 11]
поз.39 (4 шт.) t8x100x65 С235

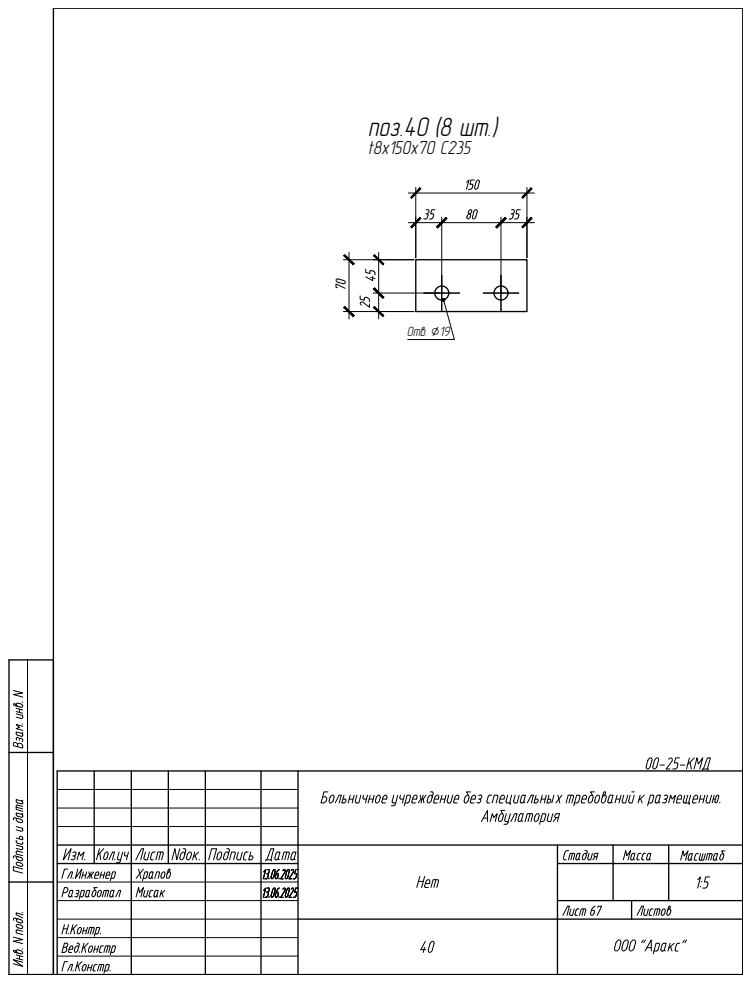
[picture p62: page 12]
поз.40 (8 шт.) t8x150x70 С235; Отв. 19

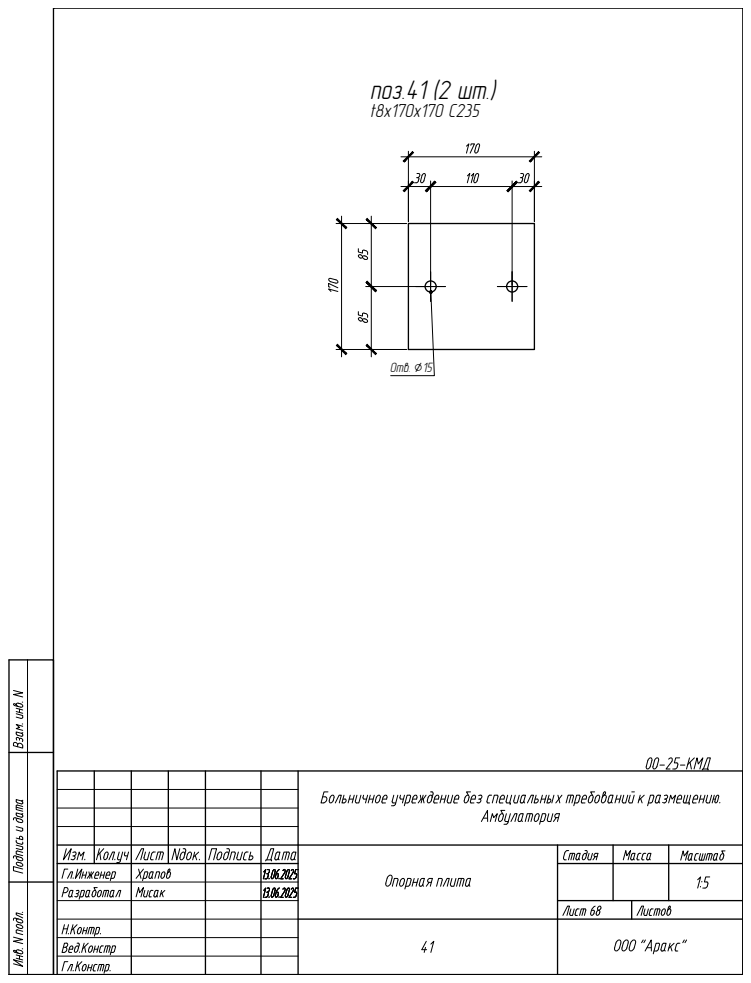
[picture p63: page 13]
поз.41 (2 шт.) t8x170x170 С235; Отв. 15

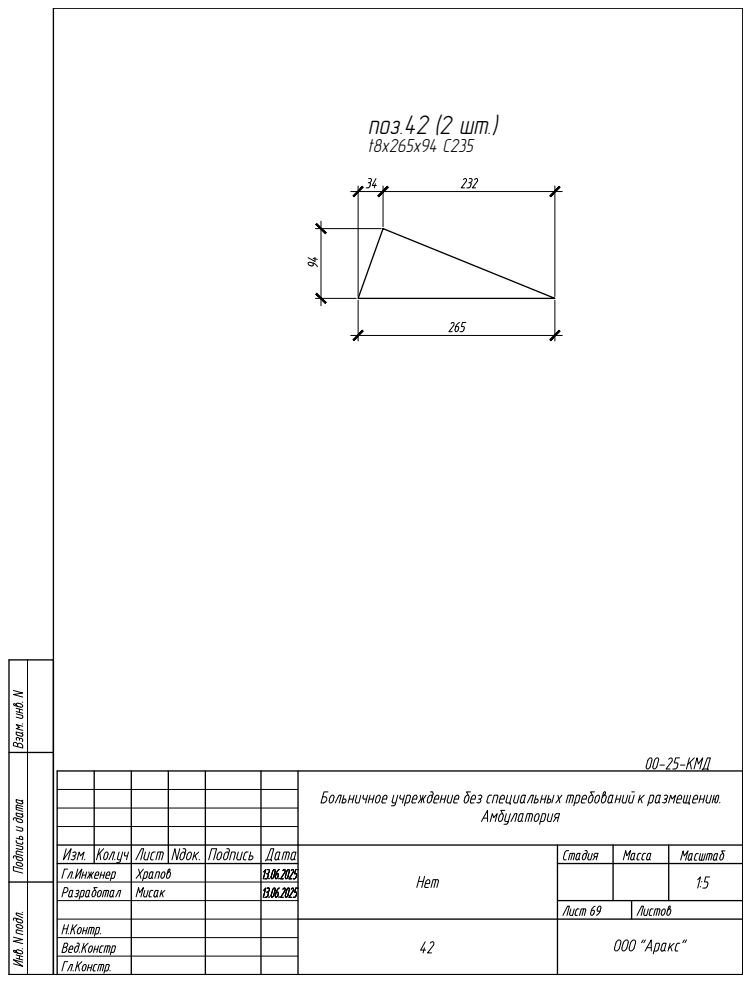
[picture p64: page 14]
поз.42 (2 шт.) t8x265x94 С235

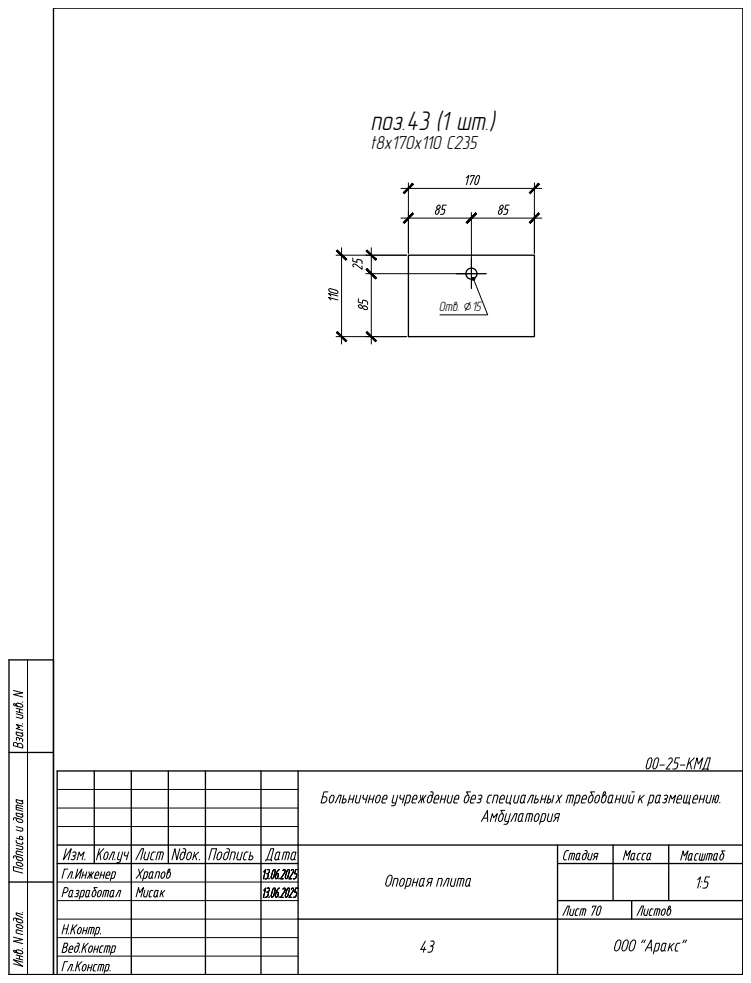
[picture p65: page 15]
поз.43 (1 шт.) t8x170x110 С235; Отв. 15

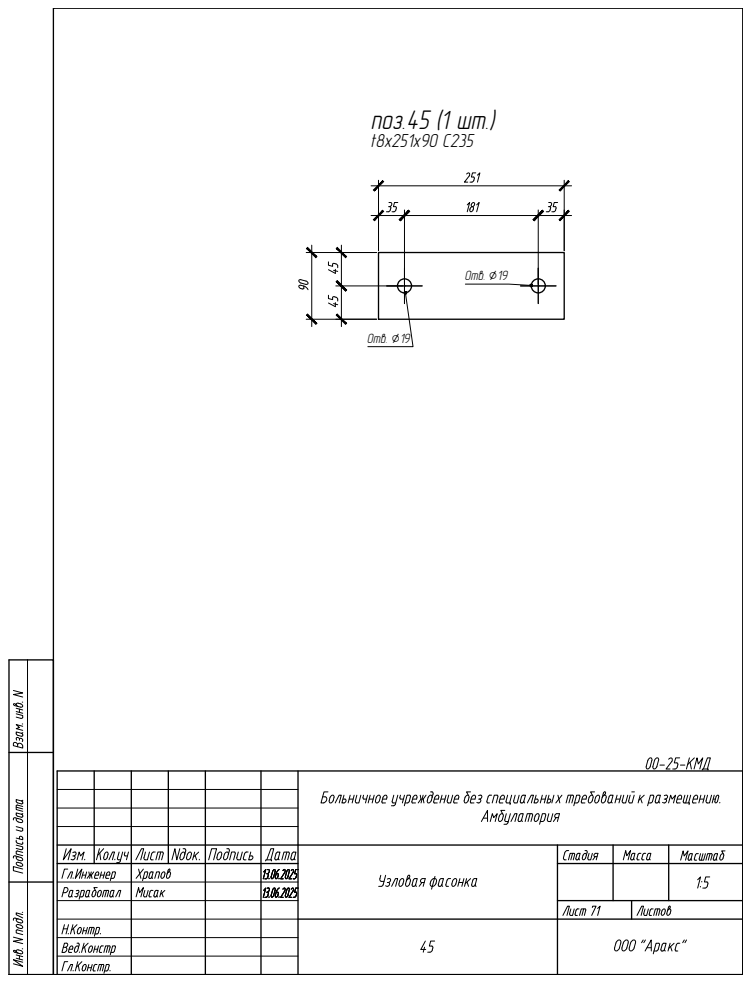
[picture p66: page 16]
поз.45 (1 шт.) t8x251x90 С235; Отв. 19

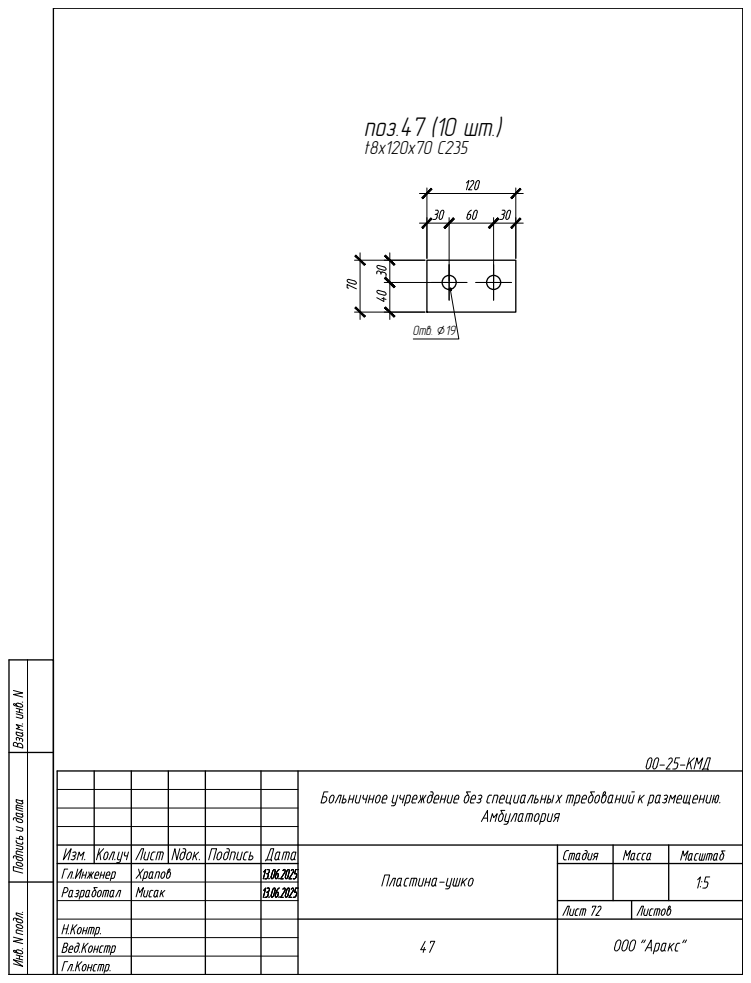
[picture p67: page 17]
поз.47 (10 шт.) t8x120x70 С235; Отв. 19

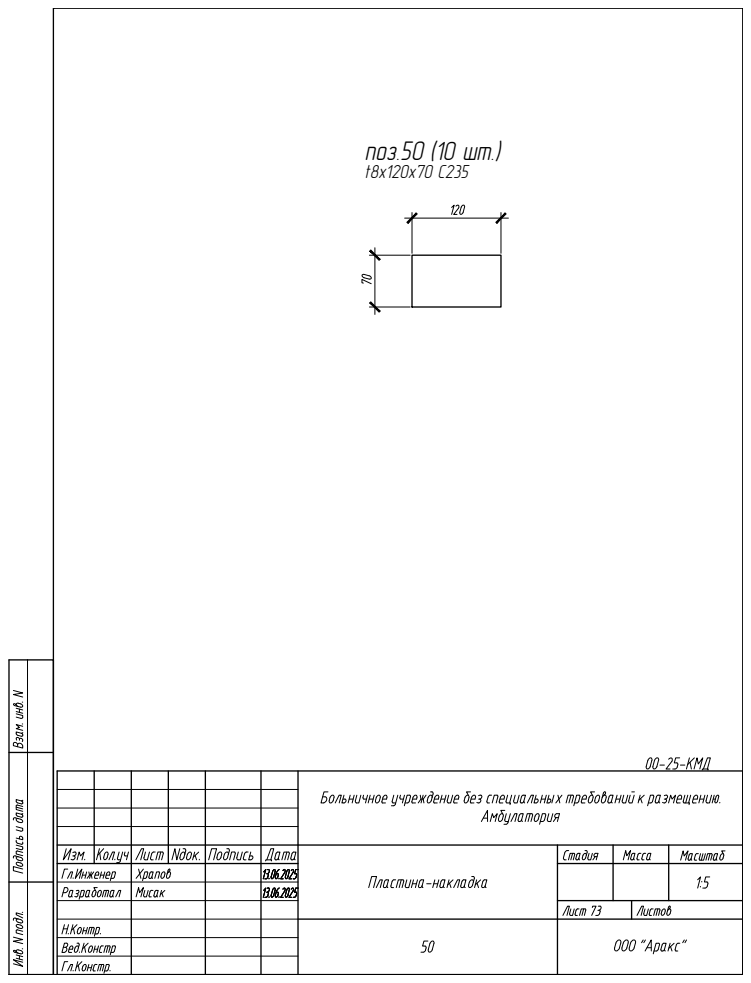
[picture p68: page 18]
поз.50 (10 шт.) t8x120x70 С235

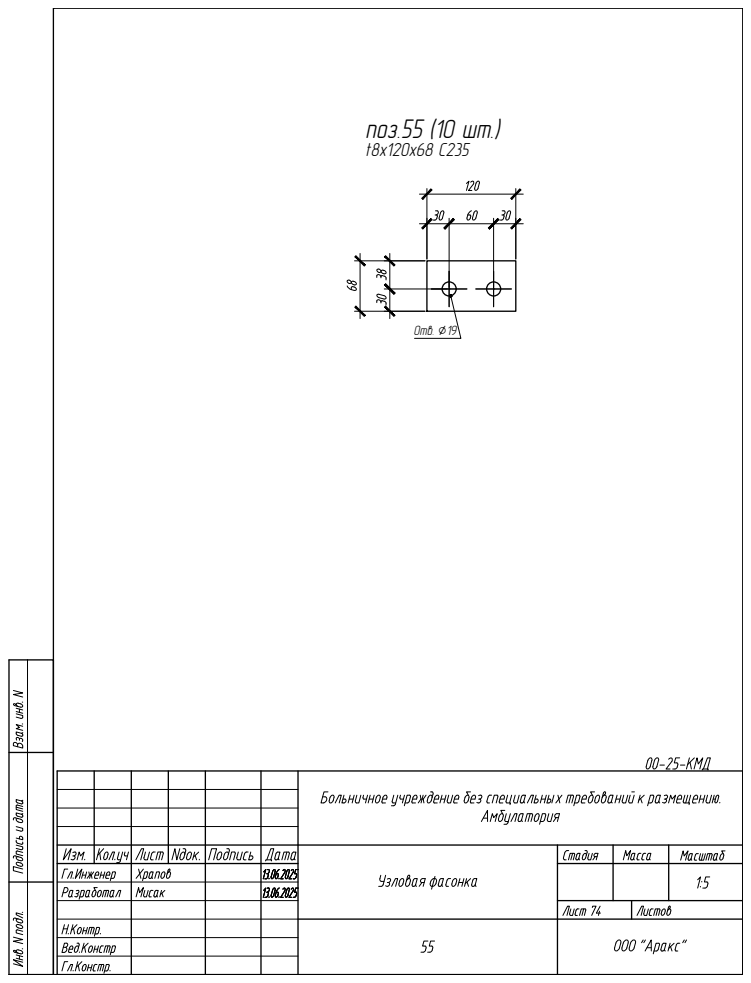
[picture p69: page 19]
поз.55 (10 шт.) t8x120x68 С235; Отв. 19
