misakigr/Ambulat_pristr/Прогоны.pdf

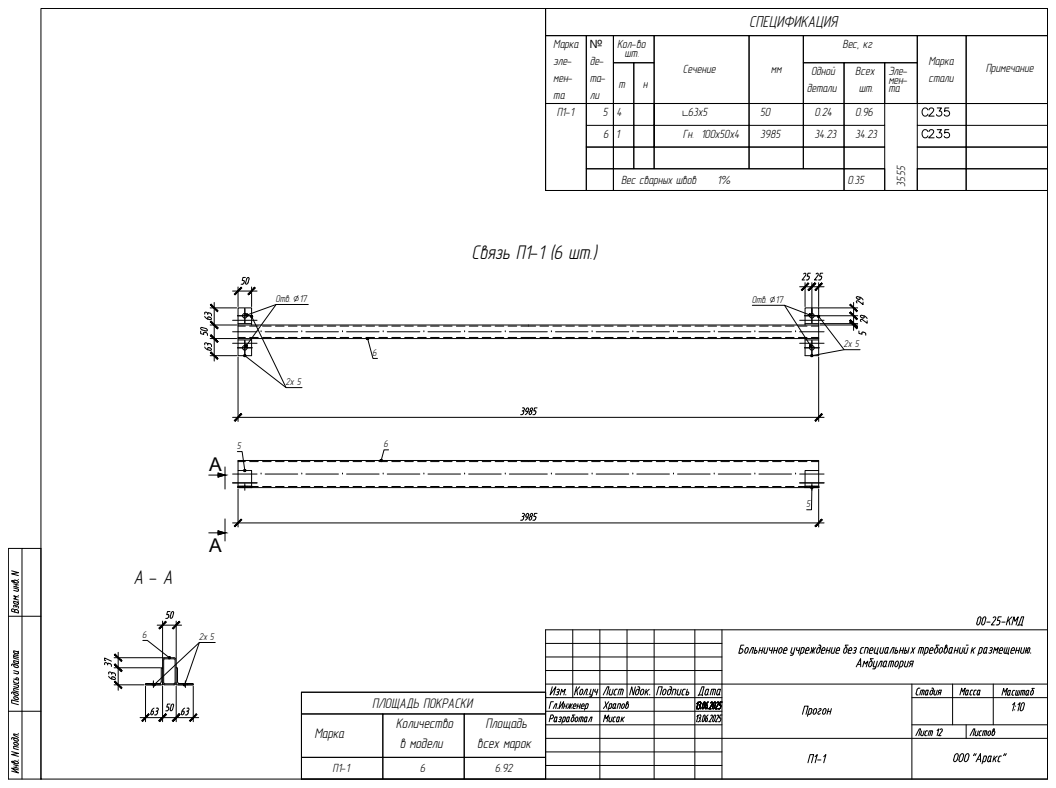
[picture p70: page 1]
СПЕЦИФИКАЦИЯ Марка эле- мен- та; Кол-во шт.; Всех шт. Одной детали Вес, кг Сечение; Примечание Марка стали Эле- мен- та П1-1; 34.23 Вес сварных швов

35.55 ПЛОЩАДЬ ПОКРАСКИ Площадь всех марок Количество в модели МаркаП1-1 6 6.92 Связь П1-1 (6 шт.) 5 6 5 АА 6 2x 5 Отв. 17 2x 5 Отв. 17 6 2x 5 А - А

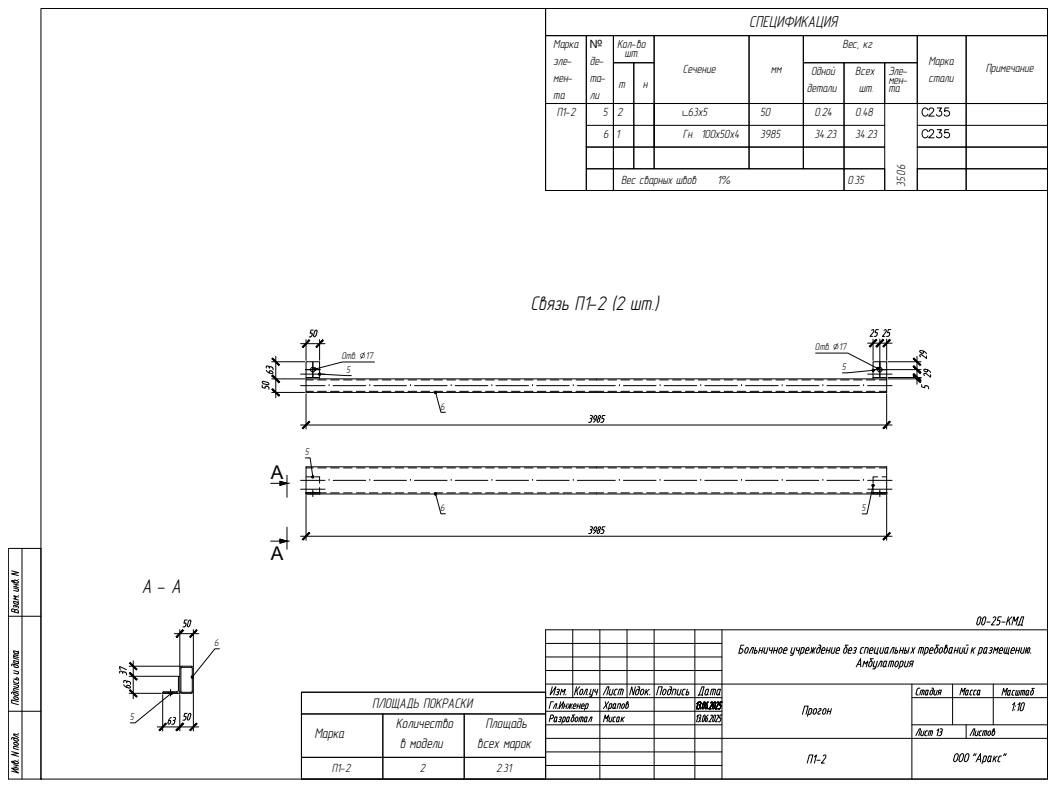
[picture p71: page 2]
СПЕЦИФИКАЦИЯ Марка эле- мен- та; Кол-во шт.; Всех шт. Одной детали Вес, кг Сечение; Примечание Марка стали Эле- мен- та П1-2; 34.23 Вес сварных швов

35.06 ПЛОЩАДЬ ПОКРАСКИ Площадь всех марок Количество в модели МаркаП1-2 2 2.31 Связь П1-2 (2 шт.) 6 5 5 АА 6 5Отв. 17 5 Отв. 17 6 5 А - А

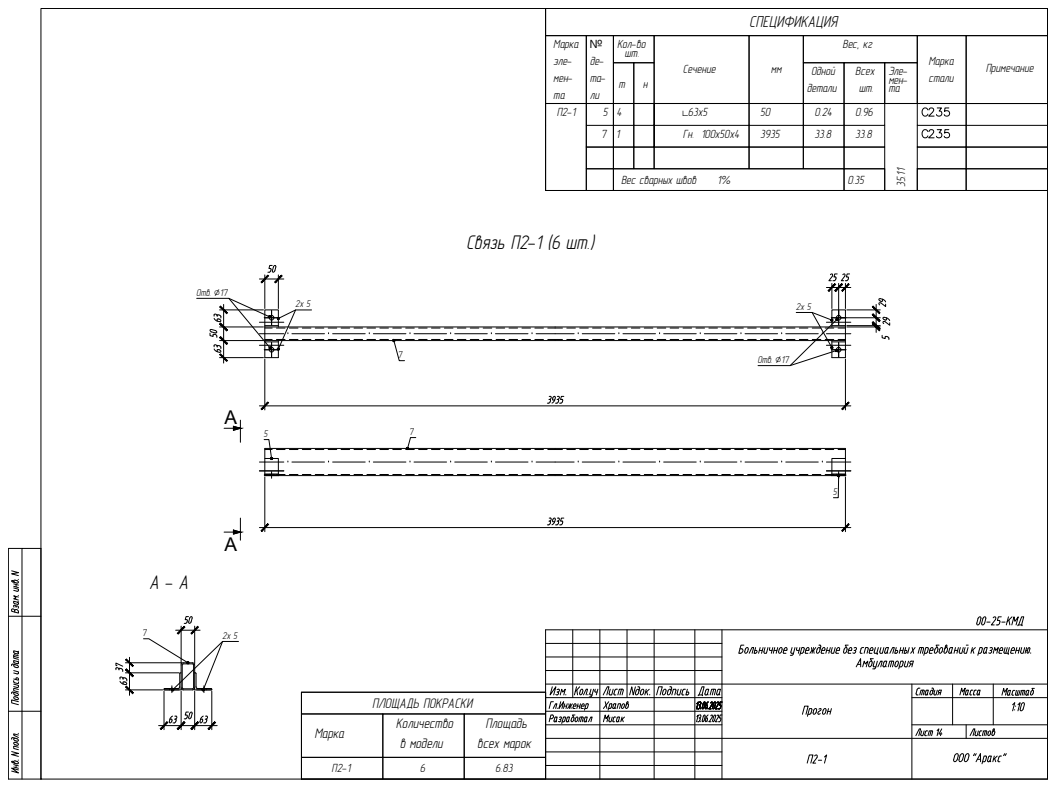
[picture p72: page 3]
СПЕЦИФИКАЦИЯ Марка эле- мен- та; Кол-во шт.; Всех шт. Одной детали Вес, кг Сечение; Примечание Марка стали Эле- мен- та П2-1; 33.8 Вес сварных швов

35.11 ПЛОЩАДЬ ПОКРАСКИ Площадь всех марок Количество в модели МаркаП2-1 6 6.83 Связь П2-1 (6 шт.) 7 5 5 АА 7 2x 5 Отв. 17 2x 5 Отв. 17 7 2x 5 А - А

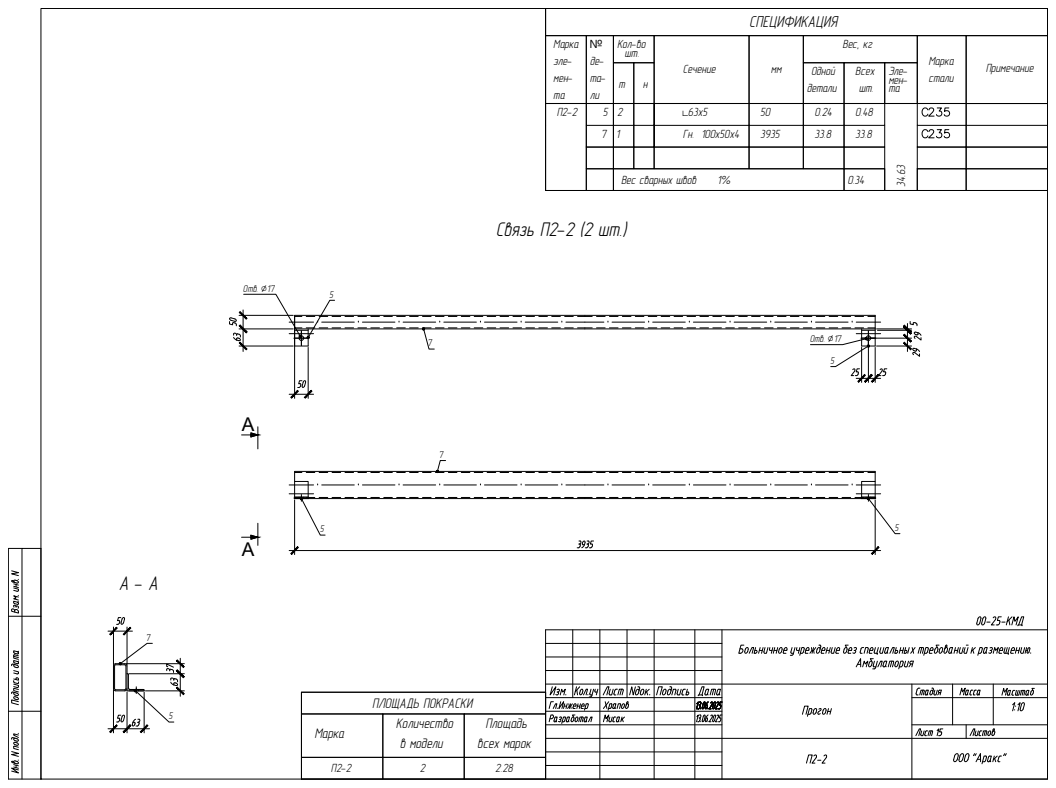
[picture p73: page 4]
СПЕЦИФИКАЦИЯ Марка эле- мен- та; Кол-во шт.; Всех шт. Одной детали Вес, кг Сечение; Примечание Марка стали Эле- мен- та П2-2; 33.8 Вес сварных швов

34.63 ПЛОЩАДЬ ПОКРАСКИ Площадь всех марок Количество в модели Марка П2-2 2 2.28 Связь П2-2 (2 шт.) 7 5 5 АА 7 5 Отв. 17 5 Отв. 17 7 5 А - А

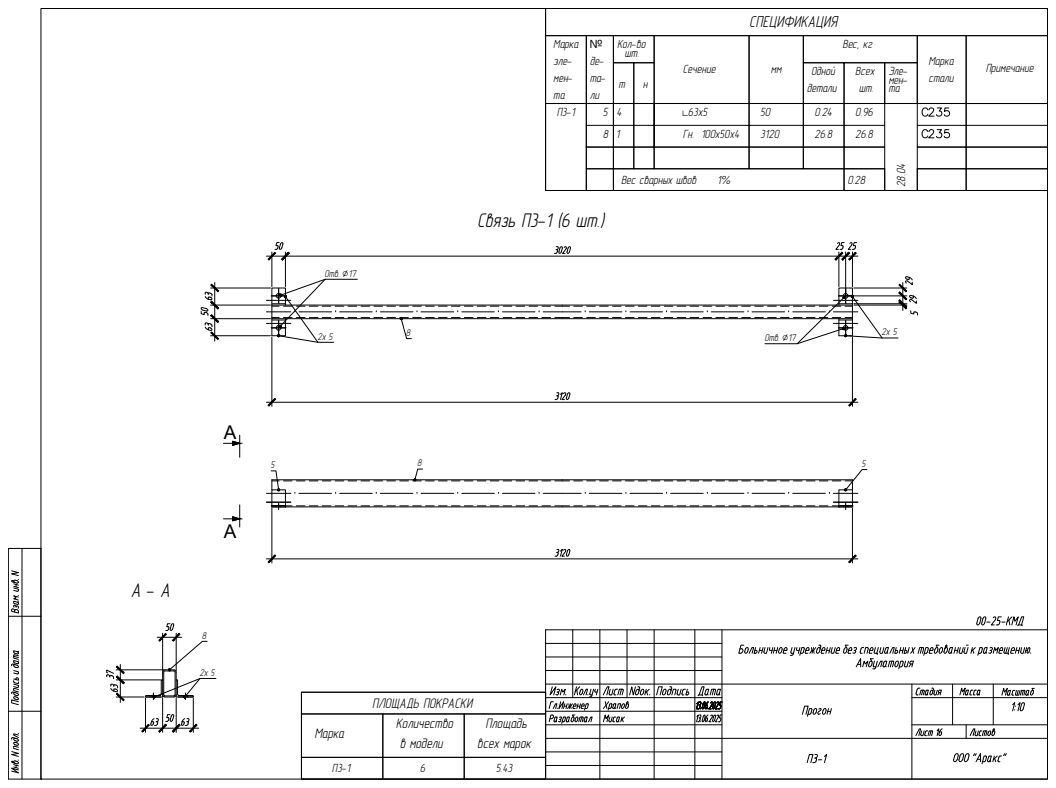
[picture p74: page 5]
СПЕЦИФИКАЦИЯ Марка эле- мен- та; Кол-во шт.; Всех шт. Одной детали Вес, кг Сечение; Примечание Марка стали Эле- мен- та П3-1; 26.8 Вес сварных швов

28.04 ПЛОЩАДЬ ПОКРАСКИ Площадь всех марок Количество в модели МаркаП3-1 6 5.43 Связь П3-1 (6 шт.) 5 8 5 АА 8 2x 5 2x 5 Отв. 17 Отв. 17 82x 5 А - А

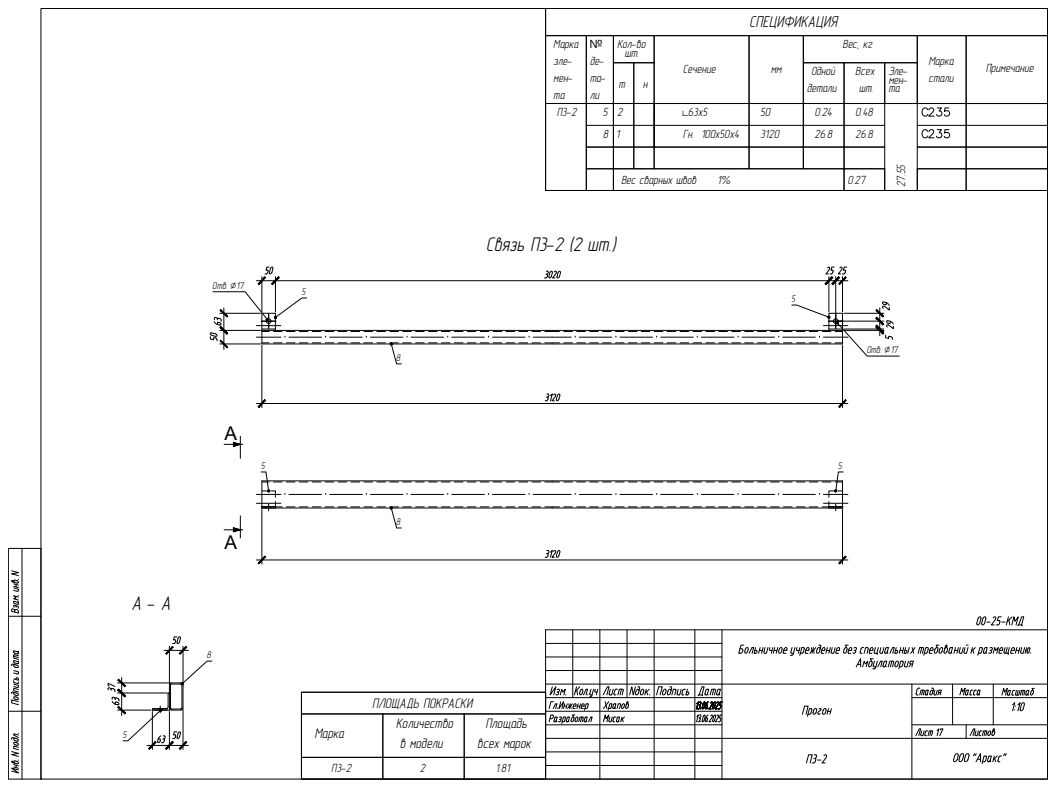
[picture p75: page 6]
СПЕЦИФИКАЦИЯ Марка эле- мен- та; Кол-во шт.; Всех шт. Одной детали Вес, кг Сечение; Примечание Марка стали Эле- мен- та П3-2; 26.8 Вес сварных швов

27.55 ПЛОЩАДЬ ПОКРАСКИ Площадь всех марок Количество в модели Марка П3-2 2 1.81 Связь П3-2 (2 шт.) 8 5 5 АА 8 5 Отв. 17 5 Отв. 17 8 5 А - А
