misakigr/Ambulat_pristr/Ригели.pdf

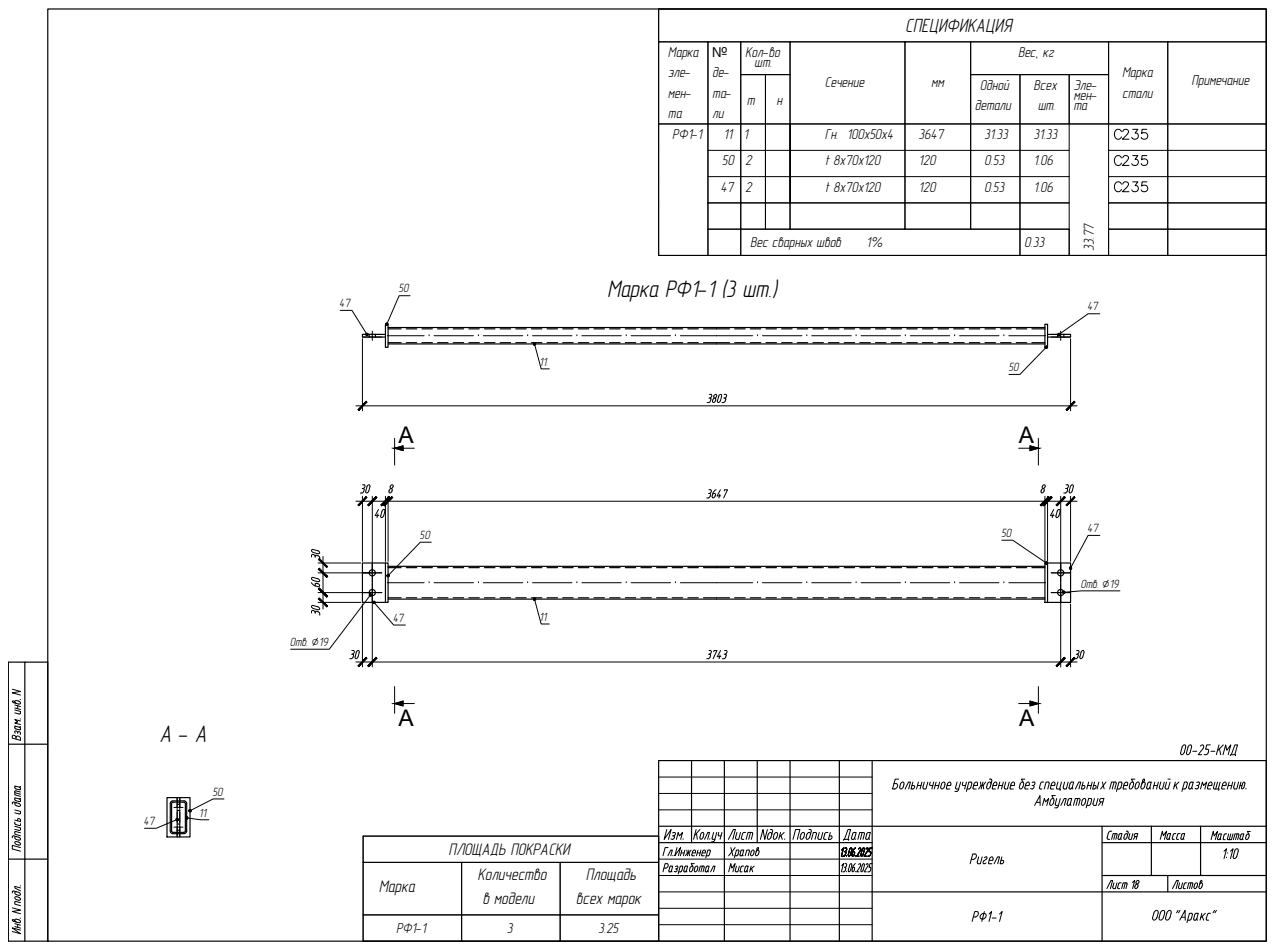
[picture p76: page 1]
СПЕЦИФИКАЦИЯ Марка эле- мен- та; Кол-во шт.; Всех шт. Одной детали Вес, кг Сечение; Примечание Марка стали Эле- мен- та РФ1-1; 1.06 Вес сварных швов

33.77 ПЛОЩАДЬ ПОКРАСКИ Площадь всех марок Количество в модели Марка РФ1-1 3 3.25Марка РФ1-1 (3 шт.) 47 11 Отв. 19 50 47 Отв. 19 50 АА АА 11 47 50 47 50 11 47 50 А - А

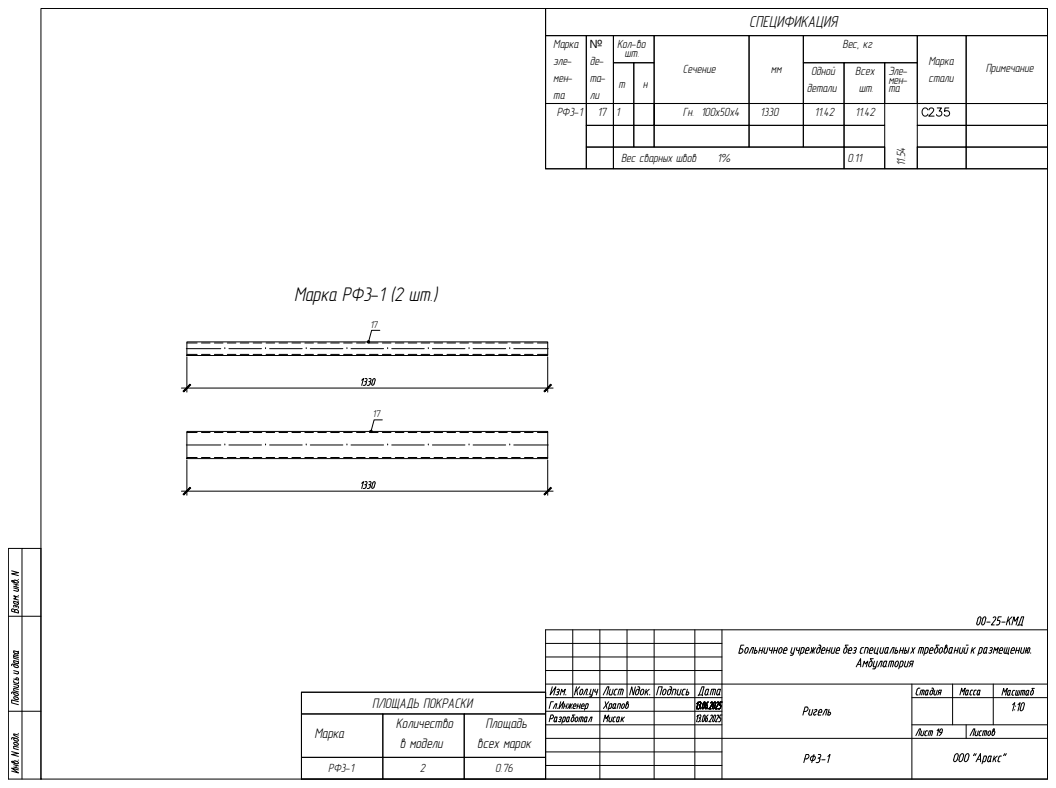
[picture p77: page 2]
СПЕЦИФИКАЦИЯ Марка эле- мен- та; Кол-во шт.; Всех шт. Одной детали Вес, кг Сечение; Примечание Марка стали Эле- мен- та РФ3-1; 11.42 Вес сварных швов

11.54 ПЛОЩАДЬ ПОКРАСКИ Площадь всех марок Количество в модели Марка РФ3-1 2 0.76 Марка РФ3-1 (2 шт.) 1717

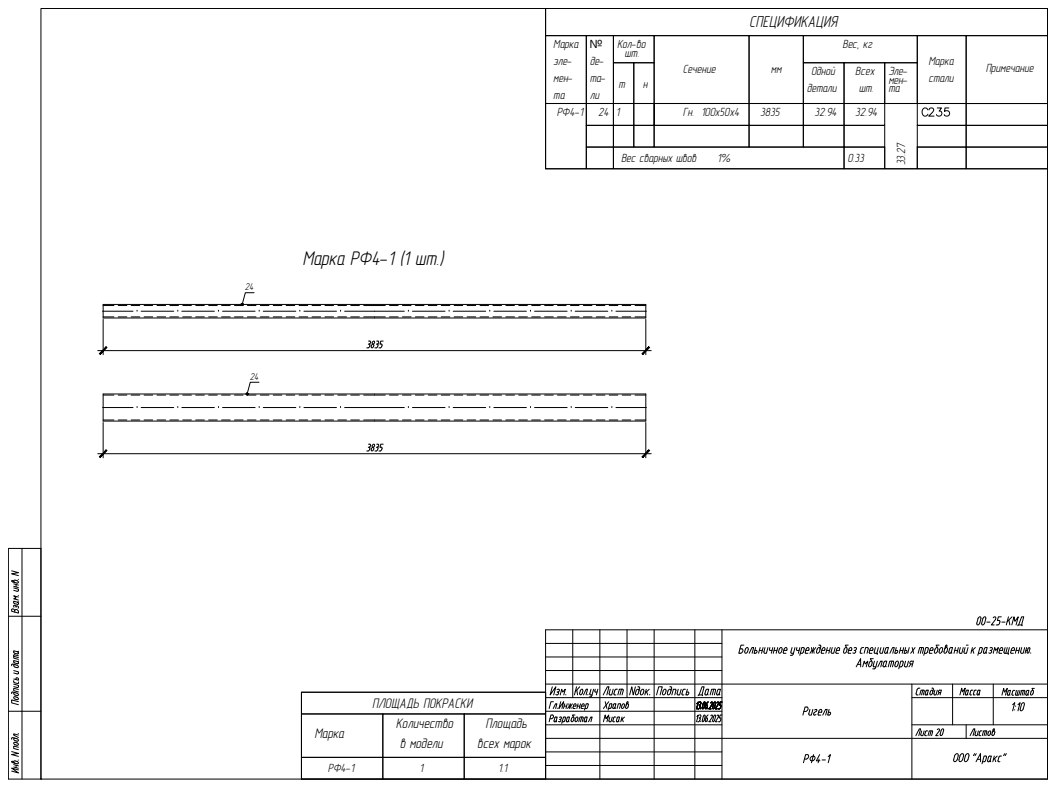
[picture p78: page 3]
СПЕЦИФИКАЦИЯ Марка эле- мен- та; Кол-во шт.; Всех шт. Одной детали Вес, кг Сечение; Примечание Марка стали Эле- мен- та РФ4-1; 32.94 Вес сварных швов

33.27 ПЛОЩАДЬ ПОКРАСКИ Площадь всех марок Количество в модели Марка РФ4-1 1 1.1 Марка РФ4-1 (1 шт.) 24 24

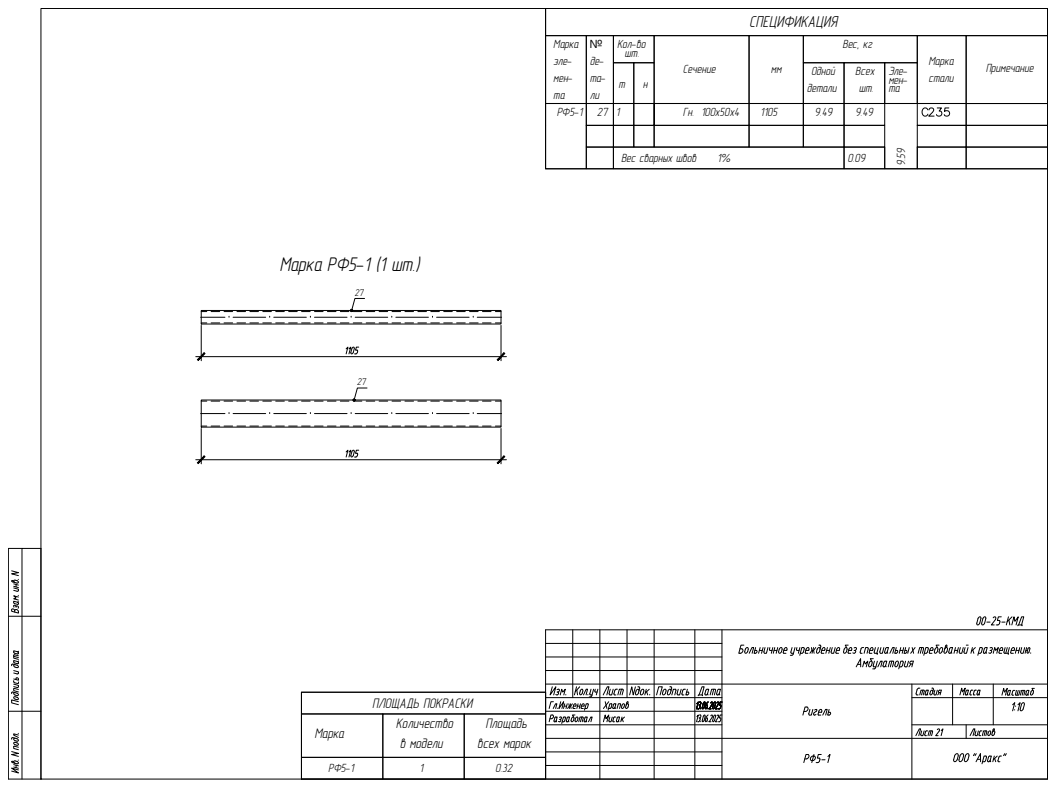
[picture p79: page 4]
СПЕЦИФИКАЦИЯ Марка эле- мен- та; Кол-во шт.; Всех шт. Одной детали Вес, кг Сечение; Примечание Марка стали Эле- мен- та РФ5-1; 9.49 Вес сварных швов

9.59 ПЛОЩАДЬ ПОКРАСКИ Площадь всех марок Количество в модели Марка РФ5-1 1 0.32 Марка РФ5-1 (1 шт.) 27 27

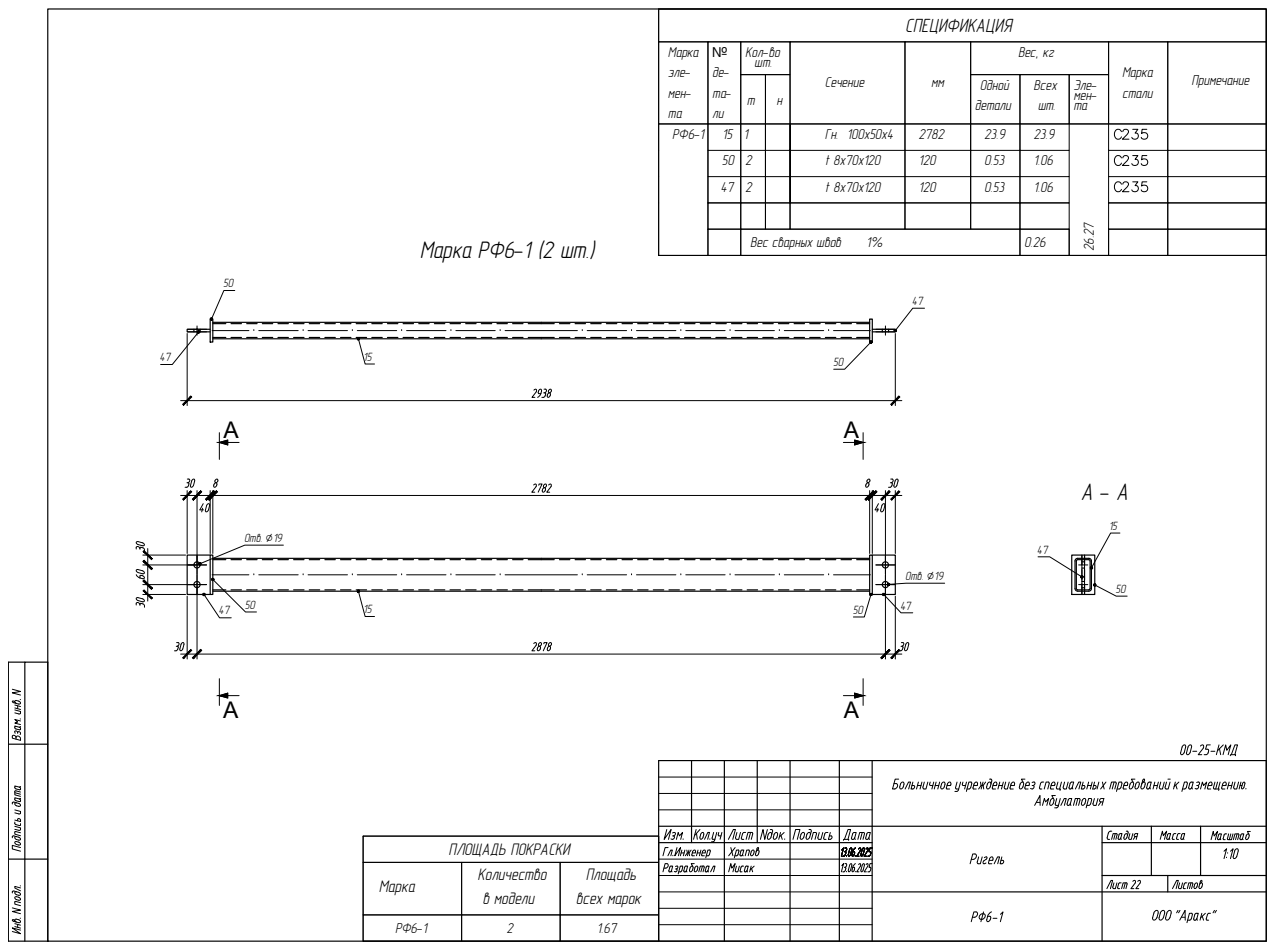
[picture p80: page 5]
СПЕЦИФИКАЦИЯ Марка эле- мен- та; Кол-во шт.; Всех шт. Одной детали Вес, кг Сечение; Примечание Марка стали Эле- мен- та РФ6-1; 1.06 Вес сварных швов

26.27 ПЛОЩАДЬ ПОКРАСКИ Площадь всех марок Количество в модели Марка РФ6-1 2 1.67 Марка РФ6-1 (2 шт.) 15 47Отв. 19 47 50 Отв. 19 50 АА АА 15 47 50 47 50 15 47 50 А - А
