misakigr/Ambulat_pristr/Связи.pdf

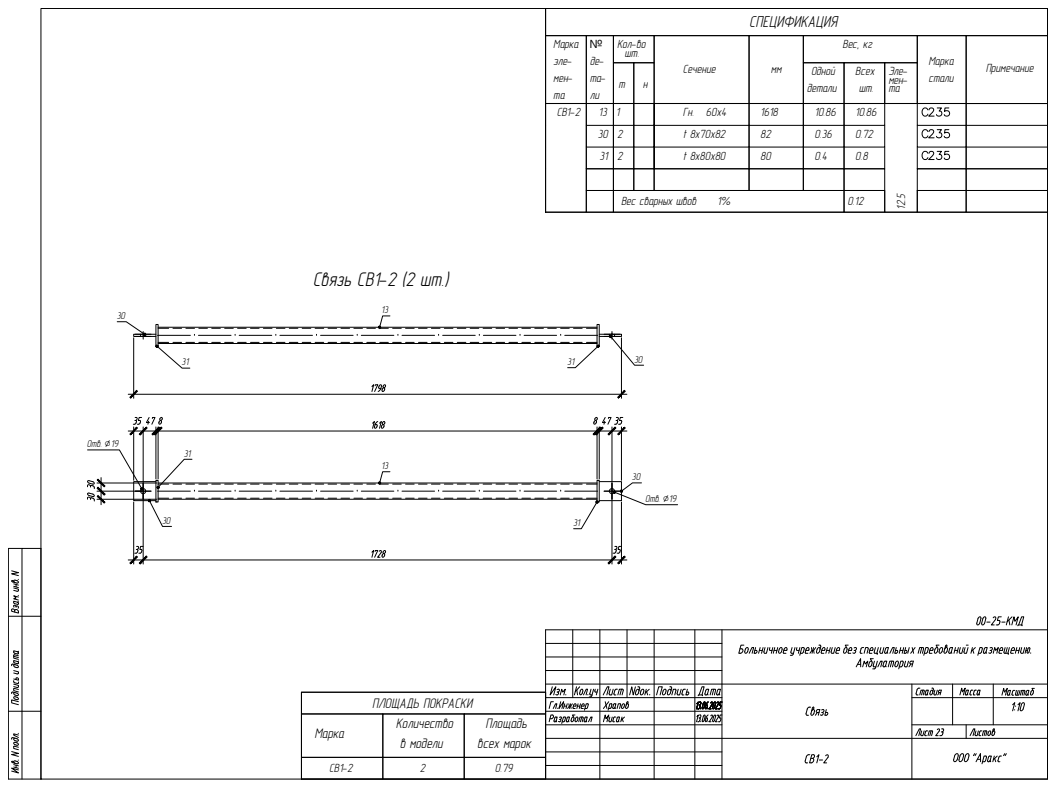
[picture p81: page 1]
СПЕЦИФИКАЦИЯ Марка эле- мен- та; Кол-во шт.; Всех шт. Одной детали Вес, кг Сечение; Примечание Марка стали Эле- мен- та СВ1-2; 0.8 Вес сварных швов

12.5 ПЛОЩАДЬ ПОКРАСКИ Площадь всех марок Количество в модели Марка СВ1-2 2 0.79 Связь СВ1-2 (2 шт.) 13 31 30 Отв. 19 31 30 Отв. 19 13 31 30 31 30

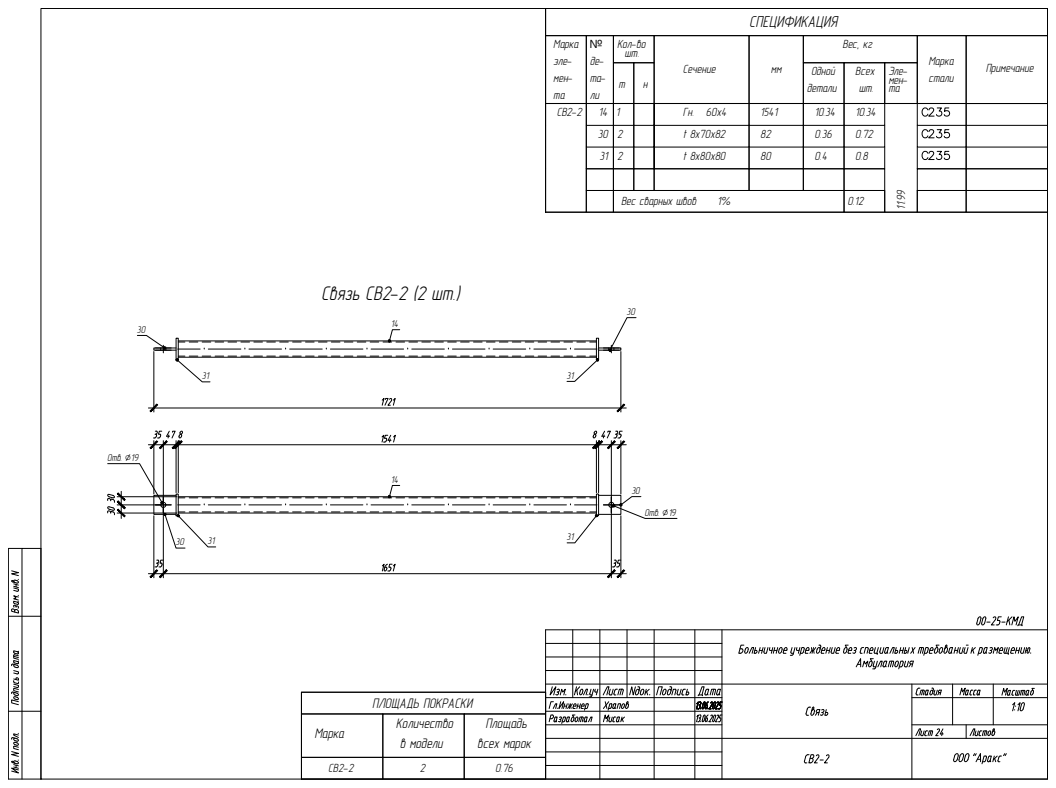
[picture p82: page 2]
СПЕЦИФИКАЦИЯ Марка эле- мен- та; Кол-во шт.; Всех шт. Одной детали Вес, кг Сечение; Примечание Марка стали Эле- мен- та СВ2-2; 0.8 Вес сварных швов

11.99 ПЛОЩАДЬ ПОКРАСКИ Площадь всех марок Количество в модели Марка СВ2-2 2 0.76 Связь СВ2-2 (2 шт.) 14 30 31 Отв. 19 31 30 Отв. 19 14 31 30 31 30

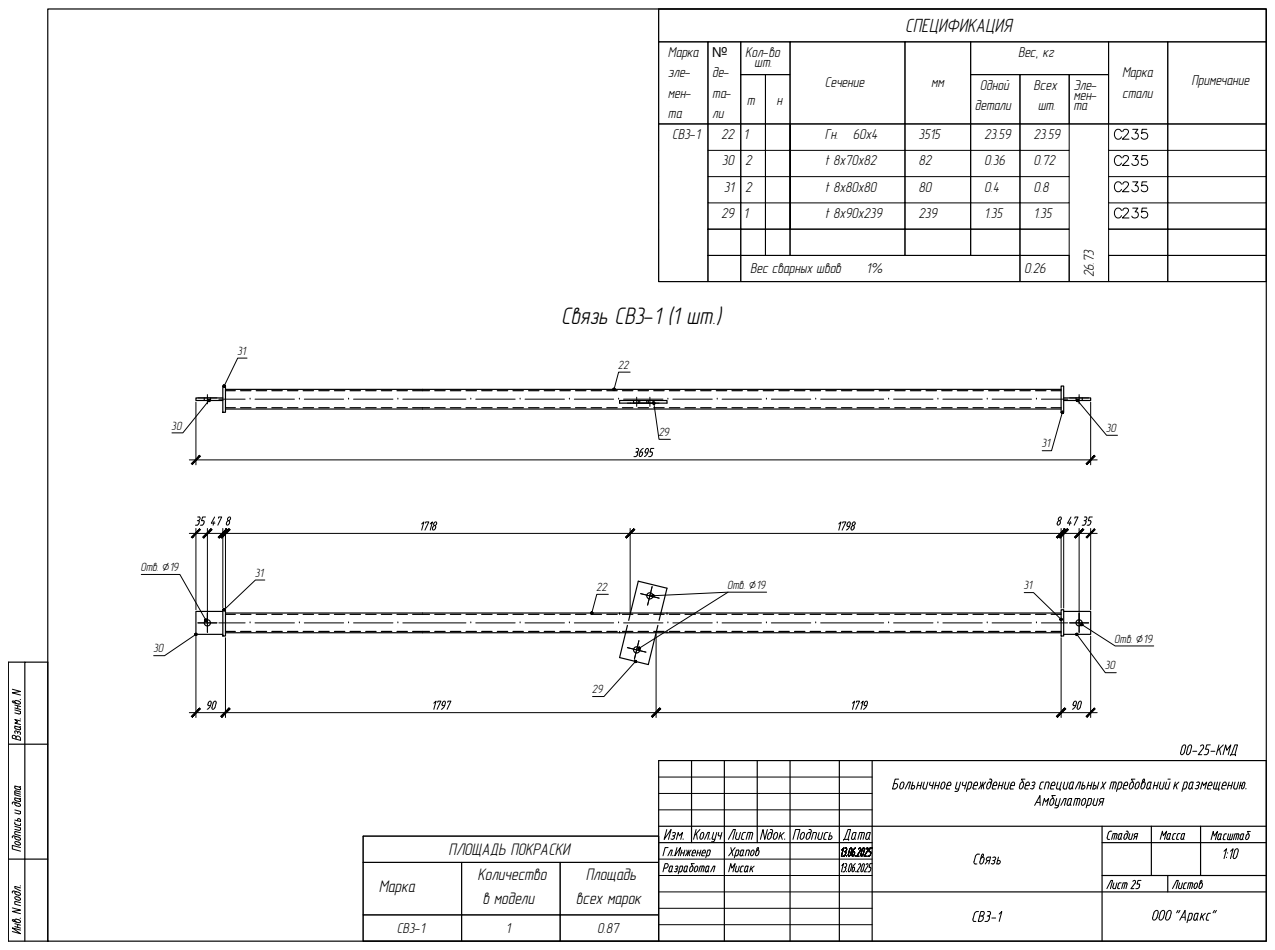
[picture p83: page 3]
СПЕЦИФИКАЦИЯ Марка эле- мен- та; Кол-во шт.; Всех шт. Одной детали Вес, кг Сечение; Примечание Марка стали Эле- мен- та СВ3-1; 1.35 Вес сварных швов

26.73 ПЛОЩАДЬ ПОКРАСКИ Площадь всех марок Количество в модели Марка СВ3-1 1 0.87 Связь СВ3-1 (1 шт.) 22 29 Отв. 19 31 30 Отв. 19 31 30Отв. 19 22 29 31 30 31 30

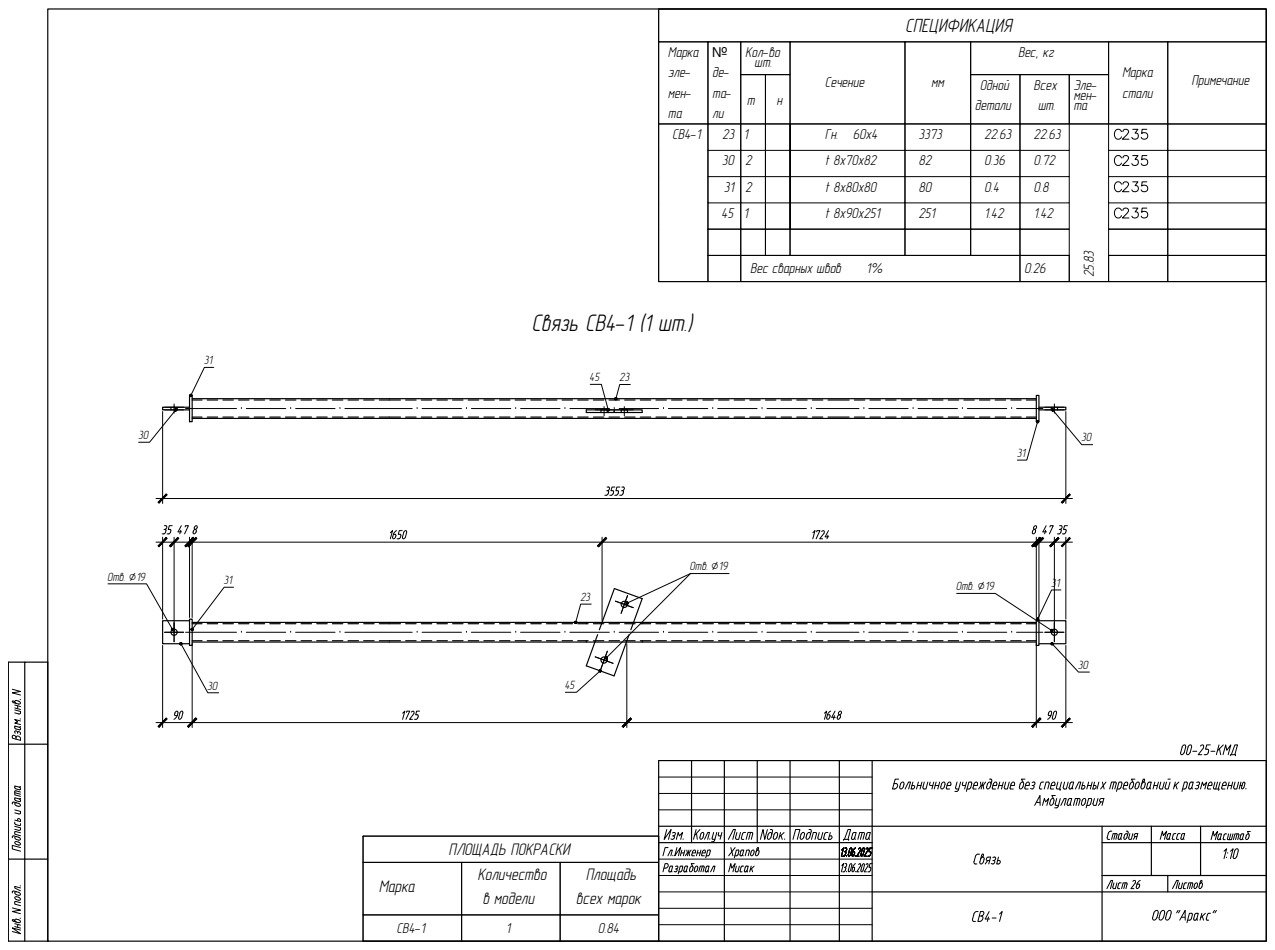
[picture p84: page 4]
СПЕЦИФИКАЦИЯ Марка эле- мен- та; Кол-во шт.; Всех шт. Одной детали Вес, кг Сечение; Примечание Марка стали Эле- мен- та СВ4-1; 1.42 Вес сварных швов

25.83 ПЛОЩАДЬ ПОКРАСКИ Площадь всех марок Количество в модели Марка СВ4-1 1 0.84 Связь СВ4-1 (1 шт.) 23 31 30 Отв. 19 31 30 Отв. 19 45 Отв. 19 23 31 30 31 30 45
