misakigr/Ambulat_pristr/Стойки.pdf

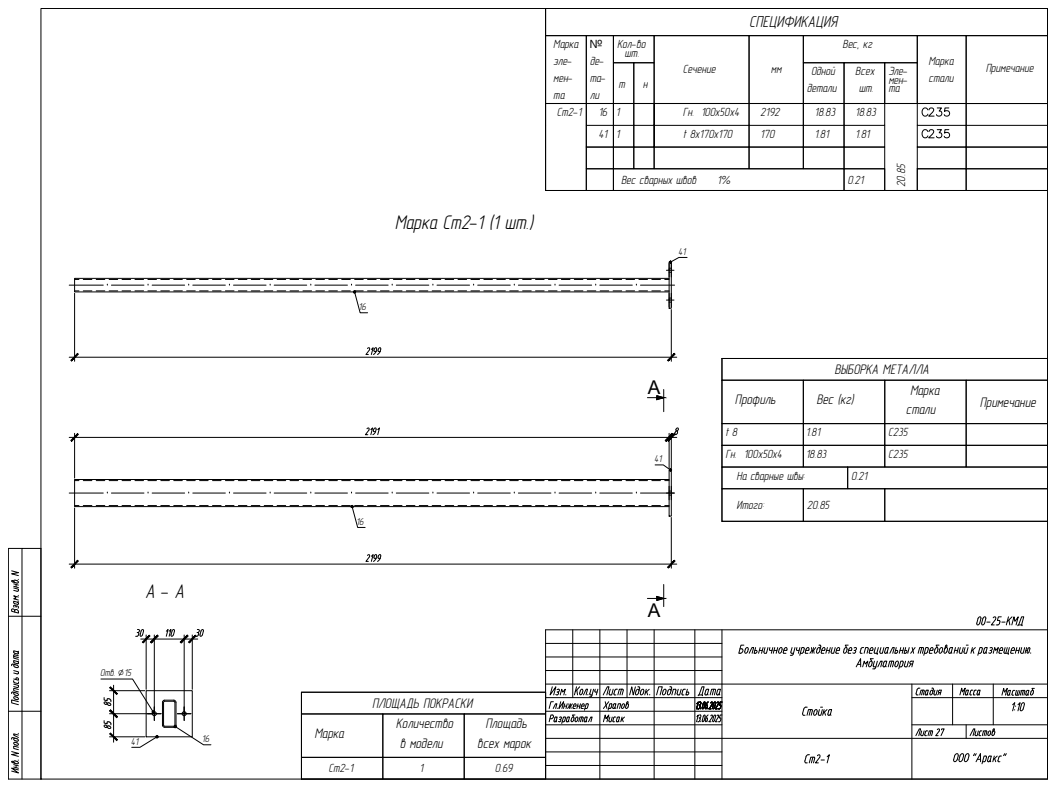
[picture p85: page 1]
СПЕЦИФИКАЦИЯ Марка эле- мен- та; Кол-во шт.; Всех шт. Одной детали Вес, кг Сечение; Примечание Марка стали Эле- мен- та Ст2-1; 1.81 Вес сварных швов

20.85 ПЛОЩАДЬ ПОКРАСКИ Площадь всех марок Количество в модели Марка Ст2-1 1 0.69 ВЫБОРКА МЕТАЛЛА Примечание Марка стали Профиль Вес (кг) t 8 1.81 С235 Гн. 100x50x4 18.83 С235 Итого: На сварные швы: 0.21 20.85 Марка Ст2-1 (1 шт.) 16 41 АА 16 41 16 41 Отв. 15 А - А

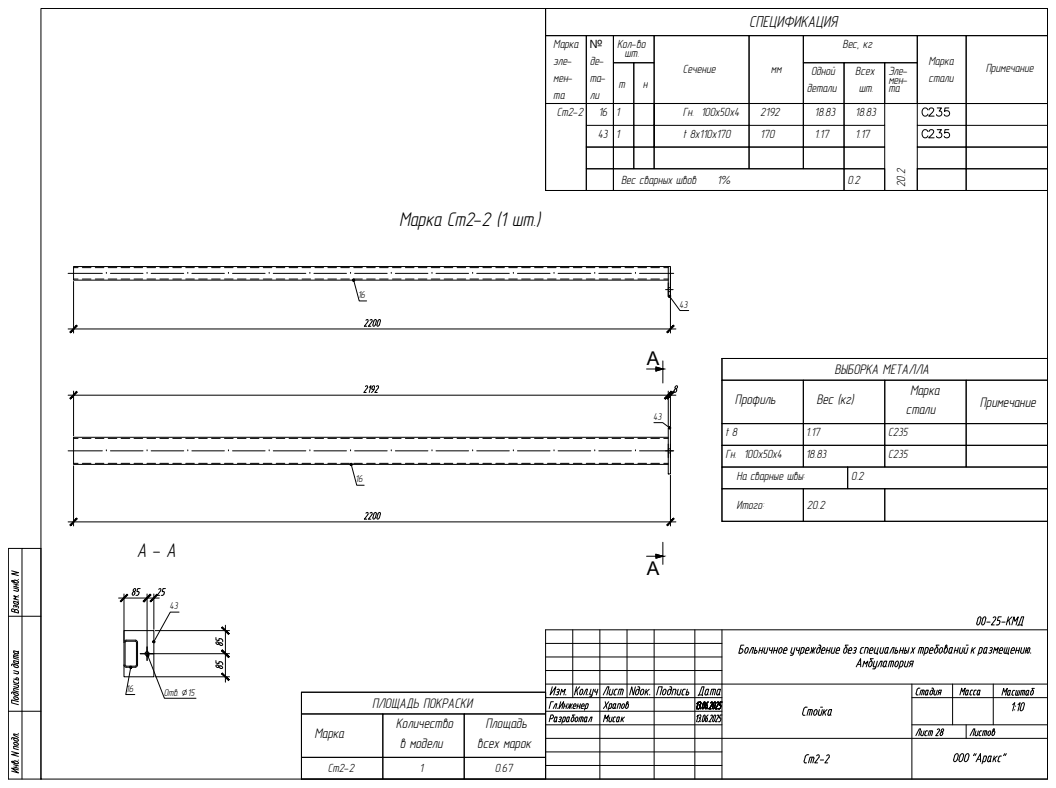
[picture p86: page 2]
СПЕЦИФИКАЦИЯ Марка эле- мен- та; Кол-во шт.; Всех шт. Одной детали Вес, кг Сечение; Примечание Марка стали Эле- мен- та Ст2-2; 1.17 Вес сварных швов

20.2 ПЛОЩАДЬ ПОКРАСКИ Площадь всех марок Количество в модели Марка Ст2-2 1 0.67 ВЫБОРКА МЕТАЛЛА Примечание Марка стали Профиль Вес (кг) t 8 1.17 С235 Гн. 100x50x4 18.83 С235 Итого: На сварные швы: 0.2 20.2 Марка Ст2-2 (1 шт.) 16 43 АА 16 43 16 43 Отв. 15 А - А

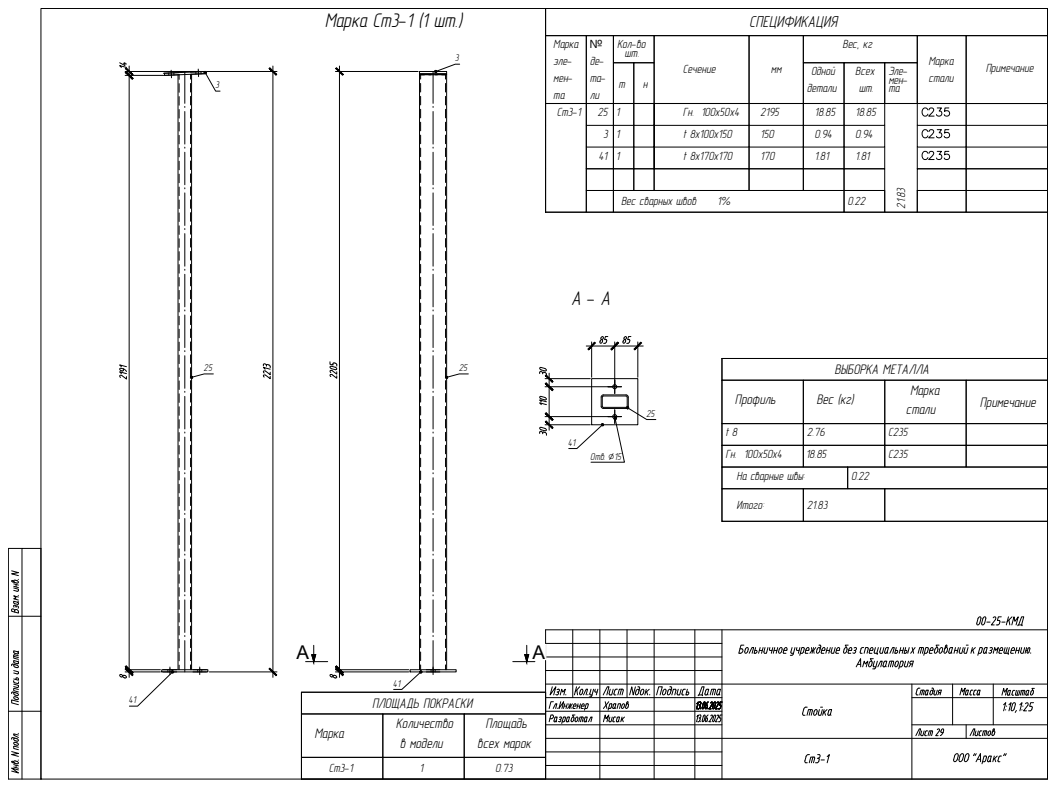
[picture p87: page 3]
СПЕЦИФИКАЦИЯ Марка эле- мен- та; Кол-во шт.; Всех шт. Одной детали Вес, кг Сечение; Примечание Марка стали Эле- мен- та Ст3-1; 1.81 Вес сварных швов

21.83 ПЛОЩАДЬ ПОКРАСКИ Площадь всех марок Количество в модели Марка Ст3-1 1 0.73 ВЫБОРКА МЕТАЛЛА Примечание Марка стали Профиль Вес (кг) t 8 2.76 С235 Гн. 100x50x4 18.85 С235 Итого: На сварные швы: 0.22 21.83 Марка Ст3-1 (1 шт.)25 3 41 А А 25 3 41 25 41 Отв. 15 А - А
