misakigr/Ambulat_pristr/Здание МРТ КМ.pdf

Взам. инв. N° Инв. N° подл. Подпись и дата

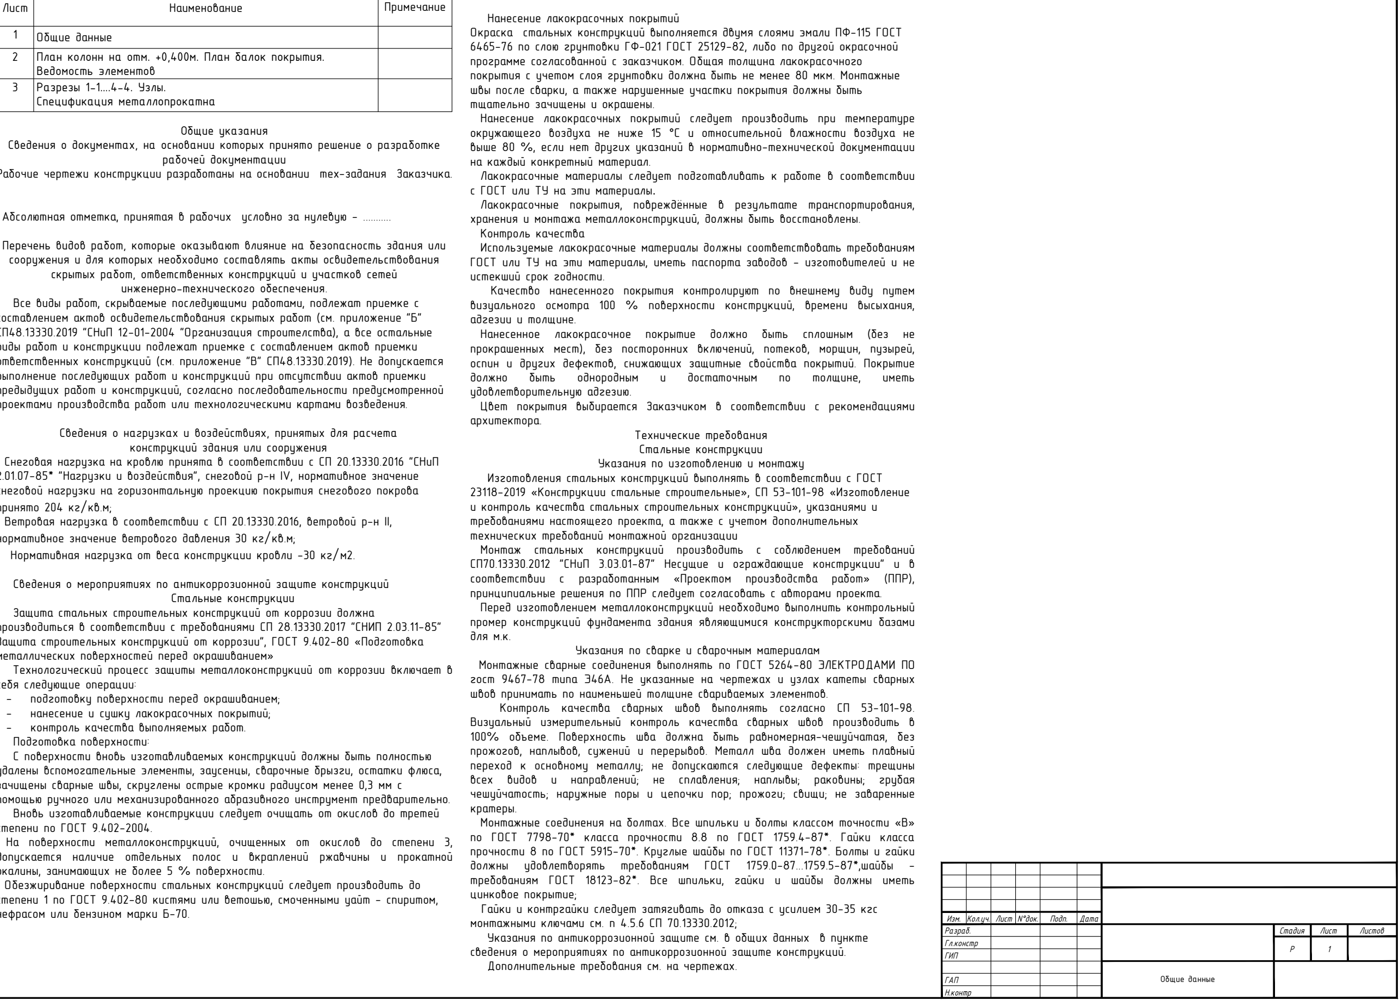
[picture p88: figure]
Р Разраб. Н.контр Гл.констр ГИПГАП; 1 Общие данные Лист; Наименование; Примечание; Общие данные; и вкраплений ржавчины; в нормативно; к работе; - изготовителей; и ограждающие конструкции" и; в соответствии; разработанным; «Проектом; производства; работ; А. Не указанные на чертежах; -чешуйчатая, без прожогов, наплывов, сужений; направлений;; сплавления;; наплывы;; раковины;; грубая чешуйчатость; наружные поры; и болты классом точности; и гайки должны; удовлетворять; требованиям; ГОСТ; 1759.0-87...1759.5-87*,шайбы

Согласовано Изм. Кол.уч. Лист N°док. Подп. Дата Стадия Лист Листов

2 | План колонн на отм. +0,400м. План балок покрытия. Ведомость элементов
3 | Разрезы 1-1....4-4. Узлы. Спецификация металлопрокатна Общие указания Сведения о документа, на основании которы принято реение о разработке рабоче документации Рабочие чертежи конструкции разработаны на основании тех
-задания Заказчика. Абсолютная отметка, принятая в рабочих условно за нулевую - | Перечень видов работ, которые оказыват влияние на безопасность здания или сооруения и для которы неободимо составлять акты освидетельствования скрыты работ, ответственны конструкци и участков сете иненерно-теническоо обеспечения. Все виды работ, скрываемые последующими работами, подлежат приемке с составлением актов освидетельствования скрытых работ (см. приложение "Б" СП48.13330.2019 "СНиП 12-01-2004 "Организация строителства), а все остальные виды работ и конструкции подлежат приемке с составлением актов приемки ответственных конструкций (см. приложение "В" СП48.13330.2019). Не допускается выполнение последующих работ и конструкций при отсутствии актов приемки предыдущих работ и конструкций, согласно последовательности предусмотренной проектами производства работ или технологическими картами возведения. Сведения о нарузка и воздествия, приняты для расчета конструкци здания или сооруения Снеговая нагрузка на кровлю принята в соответствии с СП 20.13330.2016 "СНиП 2.01.07-85* "Нагрузки и воздействия", снеговой р

-н IV, нормативное значение снеговой нагрузки на горизонтальную проекцию покрытия снегового покрова принято 204 кг

/кв.м; Ветровая нагрузка в соответствии с СП 20.13330.2016, ветровой р
-н II, нормативное значение ветрового давления 30 кг /кв.м; Нормативная нагрузка от веса конструкции кровли -30 кг
м2. Сведения о мероприятия по антикоррозионно защите конструкци Стальные конструкции Защита стальных строительных конструкций от коррозии должна производиться в соответствии с требованиями СП 28.13330.2017 "СНИП 2.03.11-85" Защита строительных конструкций от коррозии", ГОСТ 9.402-80 «Подготовка металлических поверхностей перед окрашиванием

» Технологический процесс защиты металлоконструкций от коррозии включает
в себя следующие операции: - | подготовку поверхности перед окрашиванием; - | нанесение и сушку лакокрасочных покрытий; - | контроль качества выполняемых работ. Подготовка поверхности: С поверхности вновь изготавливаемых конструкций должны быть полностью удалены вспомогательные элементы, заусенцы, сварочные брызги, остатки флюса, зачищены сварные швы, скруглены острые кромки радиусом менее 0,3 мм с помощью ручного или механизированного абразивного инструмент предварительно. Вновь изготавливаемые конструкции следует очищать от окислов до третей степени по ГОСТ 9.402-2004. На поверхности металлоконструкций, очищенных от окислов до степени 3, допускается наличие отдельных полос
и прокатной окалины, занимающих не более 5 % поверхности. Обезжиривание поверхности стальных конструкций следует производить до степени 1 по ГОСТ 9.402-80 кистями или ветошью, смоченными уайт - спиритом, нефрасом или бензином марки Б-70. | Нанесение лакокрасочных покрытий Окраска стальных конструкций выполняется двумя слоями эмали ПФ-115 ГОСТ 6465-76 по слою грунтовки ГФ-021 ГОСТ 25129-82, либо по другой окрасочной программе согласованной с заказчиком. Общая толщина лакокрасочного покрытия с учетом слоя грунтовки должна быть не менее 80 мкм. Монтажные швы после сварки, а также нарушенные участки покрытия должны быть тщательно зачищены и окрашены. Нанесение лакокрасочных покрытий следует производить при температуре окружающего воздуха не ниже 15 °С

и относительной влажности воздуха не выше 80 %, если нет других указаний -технической документации на каждый конкретный материал. Лакокрасочные материалы следует подготавливать

в соответствии с ГОСТ или ТУ на эти материалы. Лакокрасочные покрытия, повреждённые

в результате транспортирования, хранения и монтажа металлоконструкций, должны быть восстановлены. Контроль качества Используемые лакокрасочные материалы должны соответствовать требованиям ГОСТ или ТУ на эти материалы, иметь паспорта заводов

и не истекший срок годности. Качество нанесенного покрытия контролируют по внешнему виду путем визуального осмотра 100

% поверхности конструкций, времени высыхания, адгезии и толщине. Нанесенное | лакокрасочное | покрытие | должно | быть | сплошным | (без | не прокрашенных мест), без посторонних включений, потеков, морщин, пузырей, оспин
и других дефектов, снижающих защитные свойства покрытий. Покрытие должно | быть | однородным
и | достаточным | по | толщине, | иметь удовлетворительную адгезию. Цвет покрытия выбирается Заказчиком
в соответствии с рекомендациями архитектора. | енические требования Стальные конструкции Указания по изготовлению и монтажу Изготовления стальных конструкций выполнять в соответствии с ГОСТ 23118-2019 «Конструкции стальные строительные», СП 53-101-98 «Изготовление и контроль качества стальных строительных конструкций», указаниями и требованиями настоящего проекта, а также с учетом дополнительных технических требований монтажной организации Монтаж стальных конструкций производить с соблюдением требований СП70.13330.2012 "СНиП 3.03.01-87" Несущие
» | (ППР), принципиальные решения по ППР следует согласовать с авторами проекта. Перед изготовлением металлоконструкций необходимо выполнить контрольный промер конструкций фундамента здания являющимися конструкторскими базами для м.к. | Указания по сварке и сварочным материалам Монтажные сварные соединения выполнять по ГОСТ 5264-80 ЭЛЕКТРОДАМИ ПО гост 9467-78 типа

и узлах катеты сварных швов принимать по наименьшей толщине свариваемых элементов. Контроль качества сварных швов выполнять согласно СП 53-101-98. Визуальный измерительный контроль качества сварных швов производить

в 100% объеме. Поверхность шва должна быть равномерная

и перерывов. Металл шва должен иметь плавный переход к основному металлу; не допускаются следующие дефекты: трещины всех видов

и цепочки пор; прожоги; свищи; не заваренные кратеры. Монтажные соединения на болтах. Все шпильки

» по ГОСТ 7798-70* класса прочности 8.8 по ГОСТ 1759.4-87*. Гайки класса прочности

8 по ГОСТ 5915-70*. Круглые шайбы по ГОСТ 11371-78*. Болты
- требованиям ГОСТ 18123-82*. Все шпильки, гайки и шайбы должны иметь цинковое покрытие; Гайки и контргайки следует затягивать до отказа с усилием 30-35 кгс монтажными ключами см. п 4.5.6 СП 70.13330.2012; Указания по антикоррозионной защите см. в общих данных в пункте сведения о мероприятиях по антикоррозионной защите конструкций. Дополнительные требования см. на чертежах.

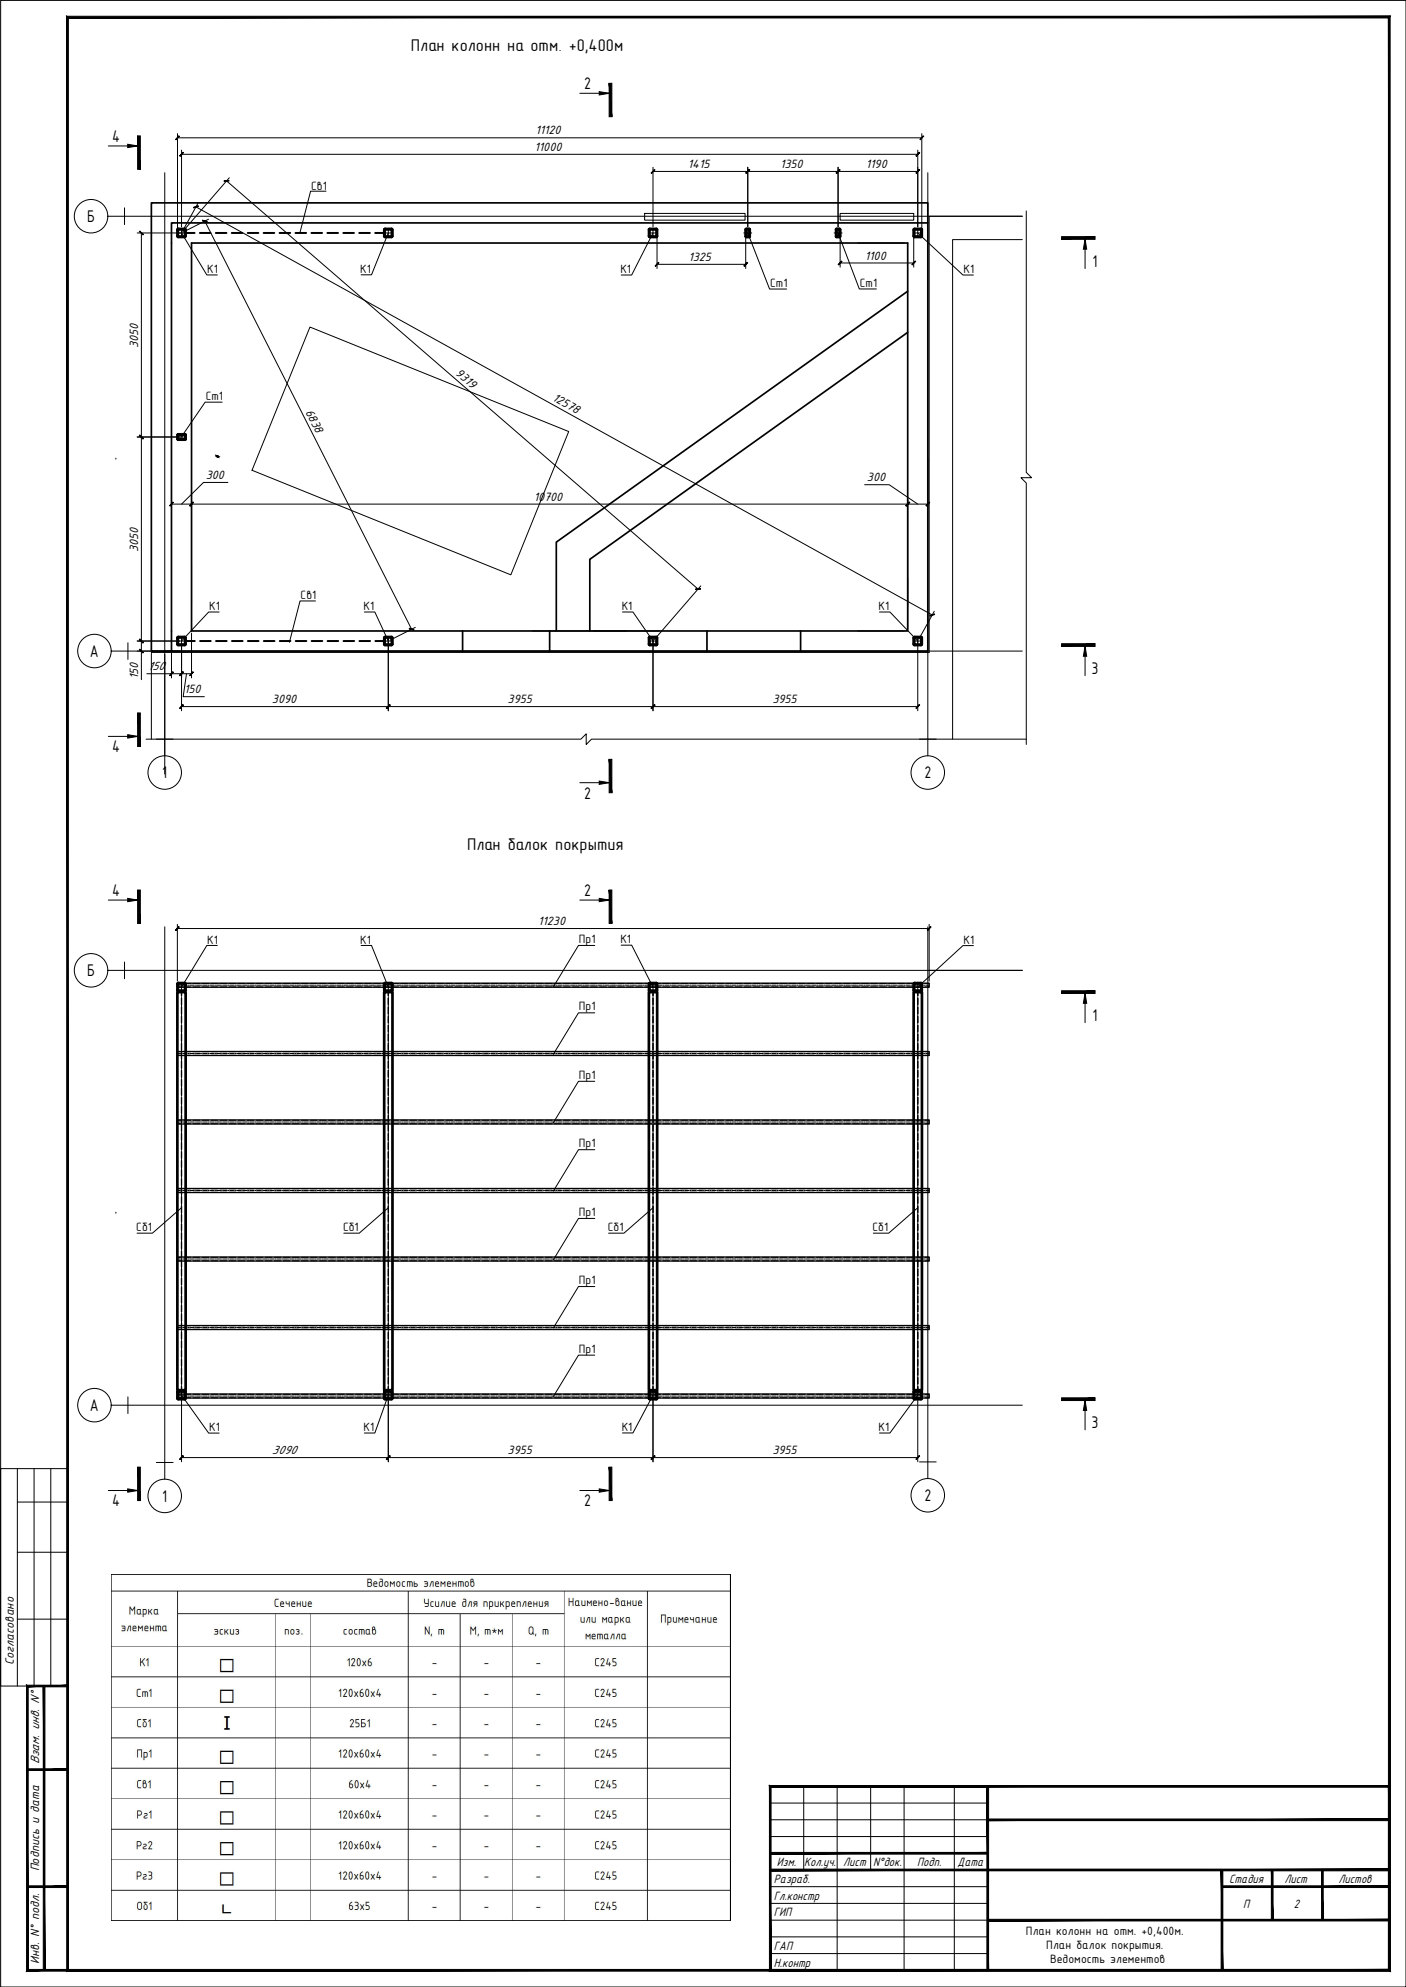
[picture p89: page 2]
План колонн на отм. +0,400м 1 А

150 3050 3050 1350 1190 1325 1100 1415 11000 11120 10700 300 300 6838 9319 12578 К1 К1 К1 К1 К1 К1 К1 К1 Ст1 Ст1 Ст1 Св1 Св1 13 22 44 План балок покрытия 1 А 2 Б К1 К1 К1 К1 К1 К1 К1 К1 Cб1 Cб1 Cб1 Cб1 Пр1 Пр1 Пр1 Пр1 Пр1 Пр1 Пр1 3090 3955 3955 11230 13 22 44

Согласовано Изм. Кол.уч. Лист N°док. Подп. Дата Стадия Лист Листов П Разраб. Н.контр Гл.констр ГИПГАП 2 План колонн на отм. +0,400м. План балок покрытия. Ведомость элементов

Взам. инв. N° Инв. N° подл. Подпись и дата

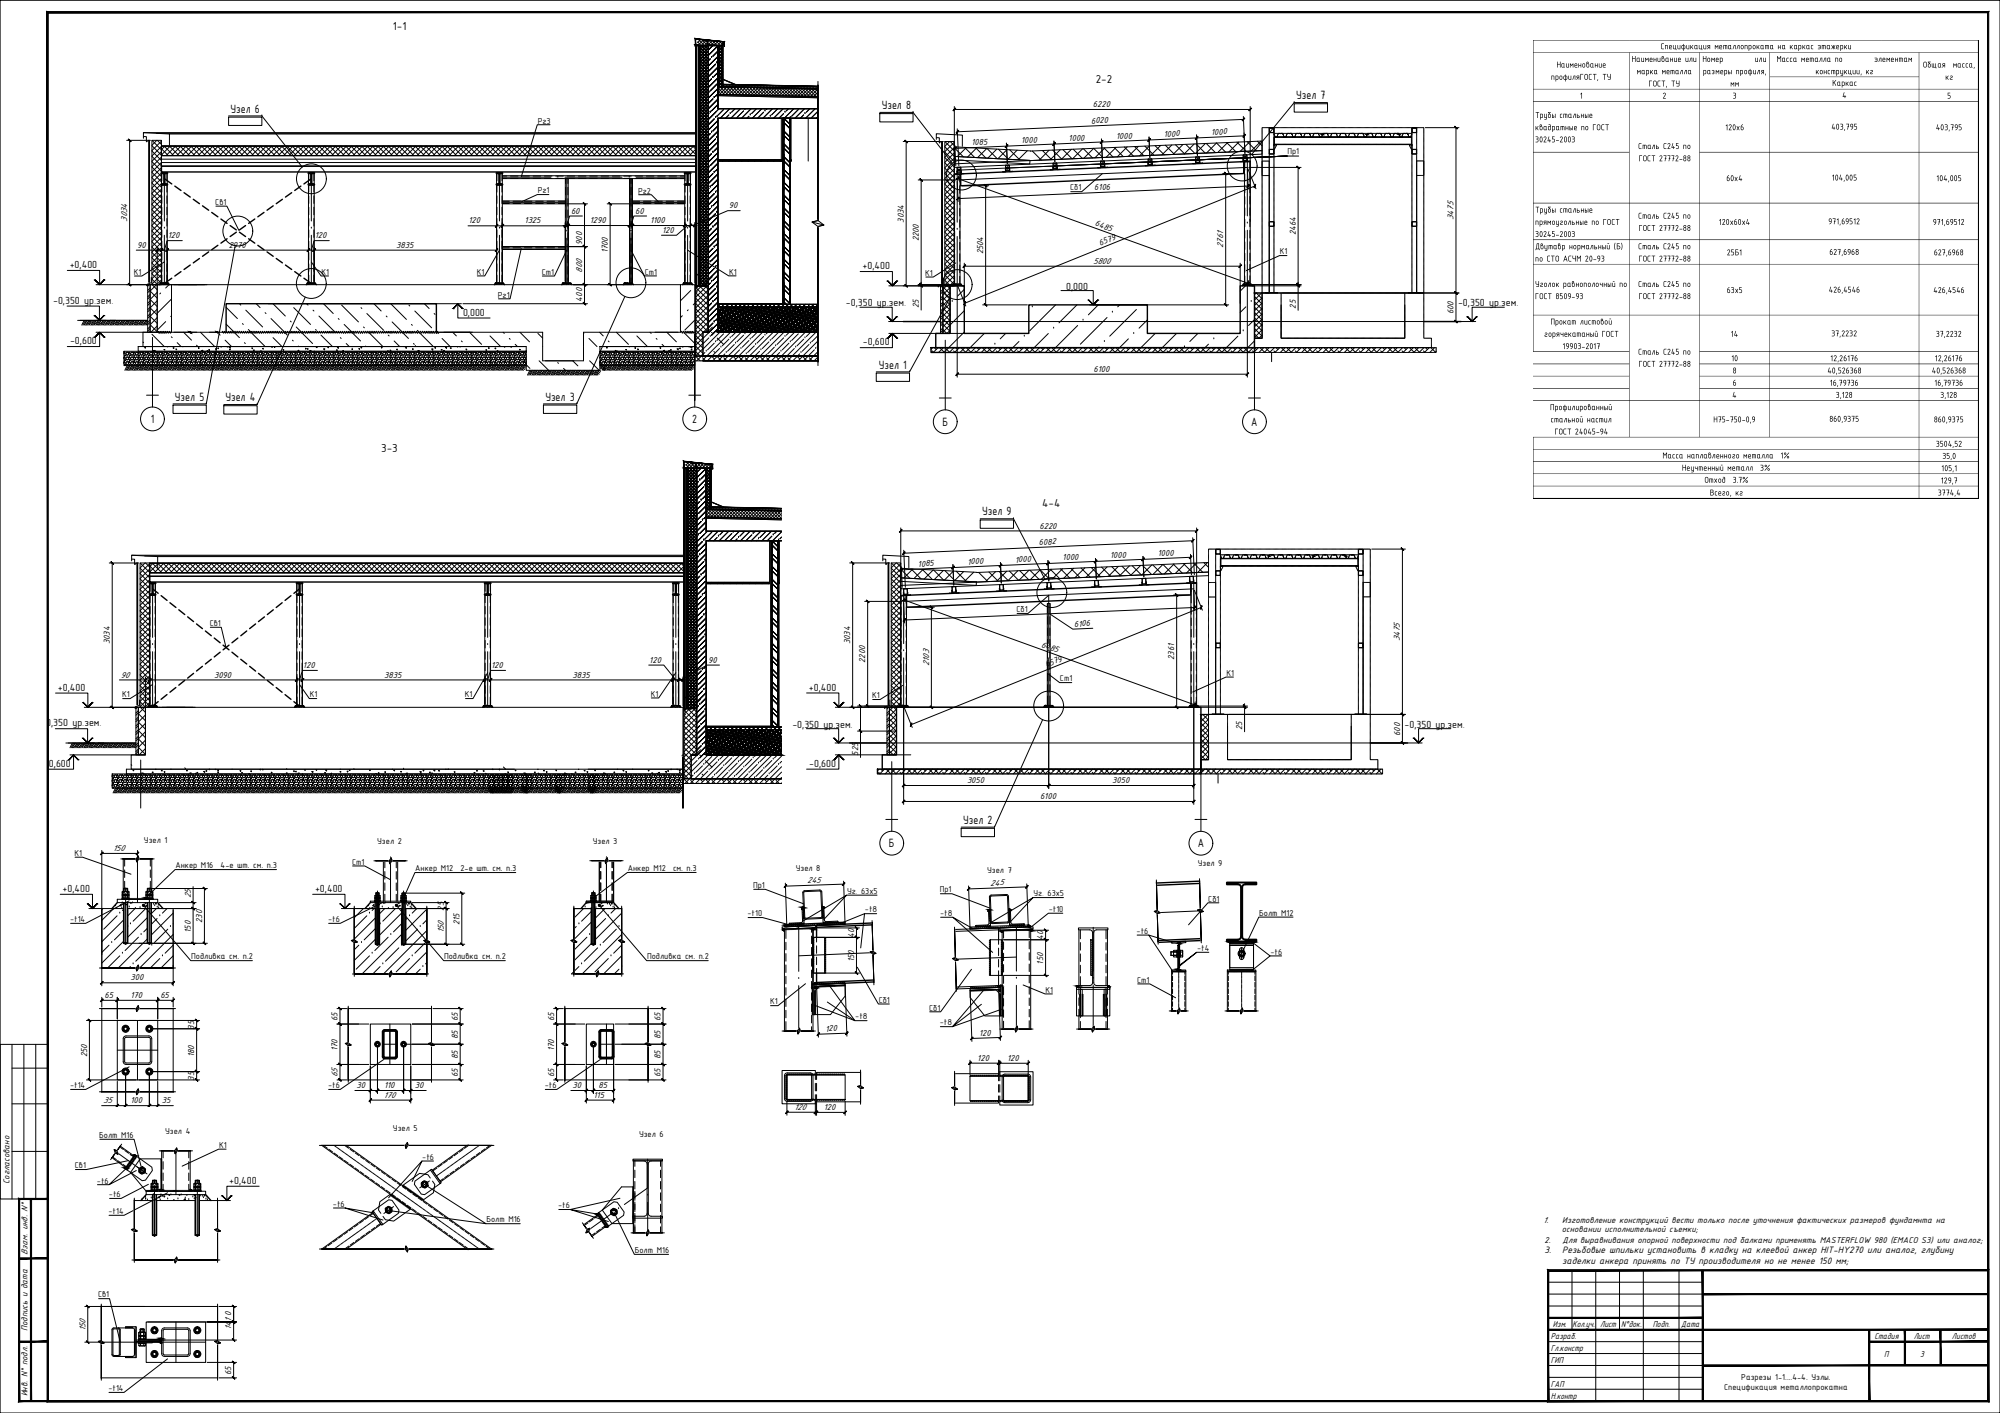
[picture p90: page 3]
+0,400 -0,600 -0,350 ур.зем.; 3475 600-0,350 ур.зем.; 3034 3-3 К1 К1 К1 К1 Св1 +0,400 -0,600 4-4 Б А -0,350 ур.зем.; 2361 3050 3050 1000 1000 1000 1000 1000 1085 Cб1 Ст1 К1 К1 Узел 2Узел 9 +0,400; 65 170 65 Узел 2 85 65 85 65 +0,400 -t6 -t14 -t6 150; 141 0 65 Узел 4 К1 -t14 -t14; 40 150 120 120 120 -t8 -t8 -t10 Уг. 63х5 Пр1 Узел 8 120 120 К Cб1 1 245

3034 К1 К1 К1 Ст1 Ст1 К1 Св1 Рг1 Рг1 Рг2 Узел 5 Узел 4 Узел 3 Узел 6 Рг3 0,000 +0,400 -0,600 2-2 Б А 5800 -0,350 ур.зем.

3034 Cб1 К1 К1Пр1 Узел 1 Узел 7 Узел 8 +0,400 -0,600 -0,350 ур.зем. 90 3090 120 3835 120 3835 120 90

180 35 35 Анкер М16 4-е шт. см. п.3 Узел 1 Подливка см. п.2 К1 -t14

85 65 85 65 -t6 Анкер М12 см. п.3 Подливка см. п.2 Подливка см. п.2 Узел 3 35 100 35 +0,400

25 Анкер М12 2-е шт. см. п.3 Ст1 170 30 110 30

40 150 120 -t8 -t8 -t10 Уг. 63х5 Пр1 Узел 9 -t6 -t4 Болт М12 -t6 Cб1 Ст1

150 -t6 -t6 Болт М16 Св1 Св1 Узел 5 -t6 -t6 Болт М16 Узел 6 -t6 Болт М16 Узел 7 Cб1 К1 245

Согласовано Изм. Кол.уч. Лист N°док. Подп. Дата Стадия Лист Листов П Разраб. Н.контр Гл.констр ГИПГАП 3 Разрезы 1-1....4-4. Узлы. Спецификация металлопрокатна 1. Изготовление конструкций вести только после уточнения фактических размеров фундамнта на основании исполнительной съемки; 2. Для выравнивания опорной поверхности под балками применять MASTERFLOW 980 (EMACO S3) или аналог; 3. Резьбовые шпильки установить в кладку на клеевой анкер HIT-HY270 или аналог, глубину заделки анкера принять по ТУ производителя но не менее 150 мм;

Взам. инв. N° Инв. N° подл. Подпись и дата
