misakigr/Ambulat_pristr/(commit log)

2025-06-02 Add files via upload
    Исходные данные
    [Peregorodka.dwg]
2025-06-02 Rename Peregorodka.dwg to Ambulat.dwg
    Переименовал основной файл
    [Ambulat.dwg]
2025-06-02 Первые колонны
    [Ambulat.dwg]
2025-06-03 Утонить проемы для сэндвич панелей
    [Ambulat.dwg]
2025-06-10 Прогоны
    [Ambulat.dwg]
2025-06-10 Пытаюсь сделать связь
    [Ambulat.dwg]
2025-06-11 Связи готовы
    [Ambulat.dwg]
2025-06-12 Б4 доделать
    [Ambulat.dwg]
2025-06-13 ГОТОВО!!!
    [Ambulat.dwg, Ведомость пластин.xls, Перечень профилей.xls]
